mc-hamster/nova-core/nova core/hardware/core 2.0/build_002/core.brd

## EAGLE design nova core/hardware/core 2.0/build_002/core.brd (2022-10-16)

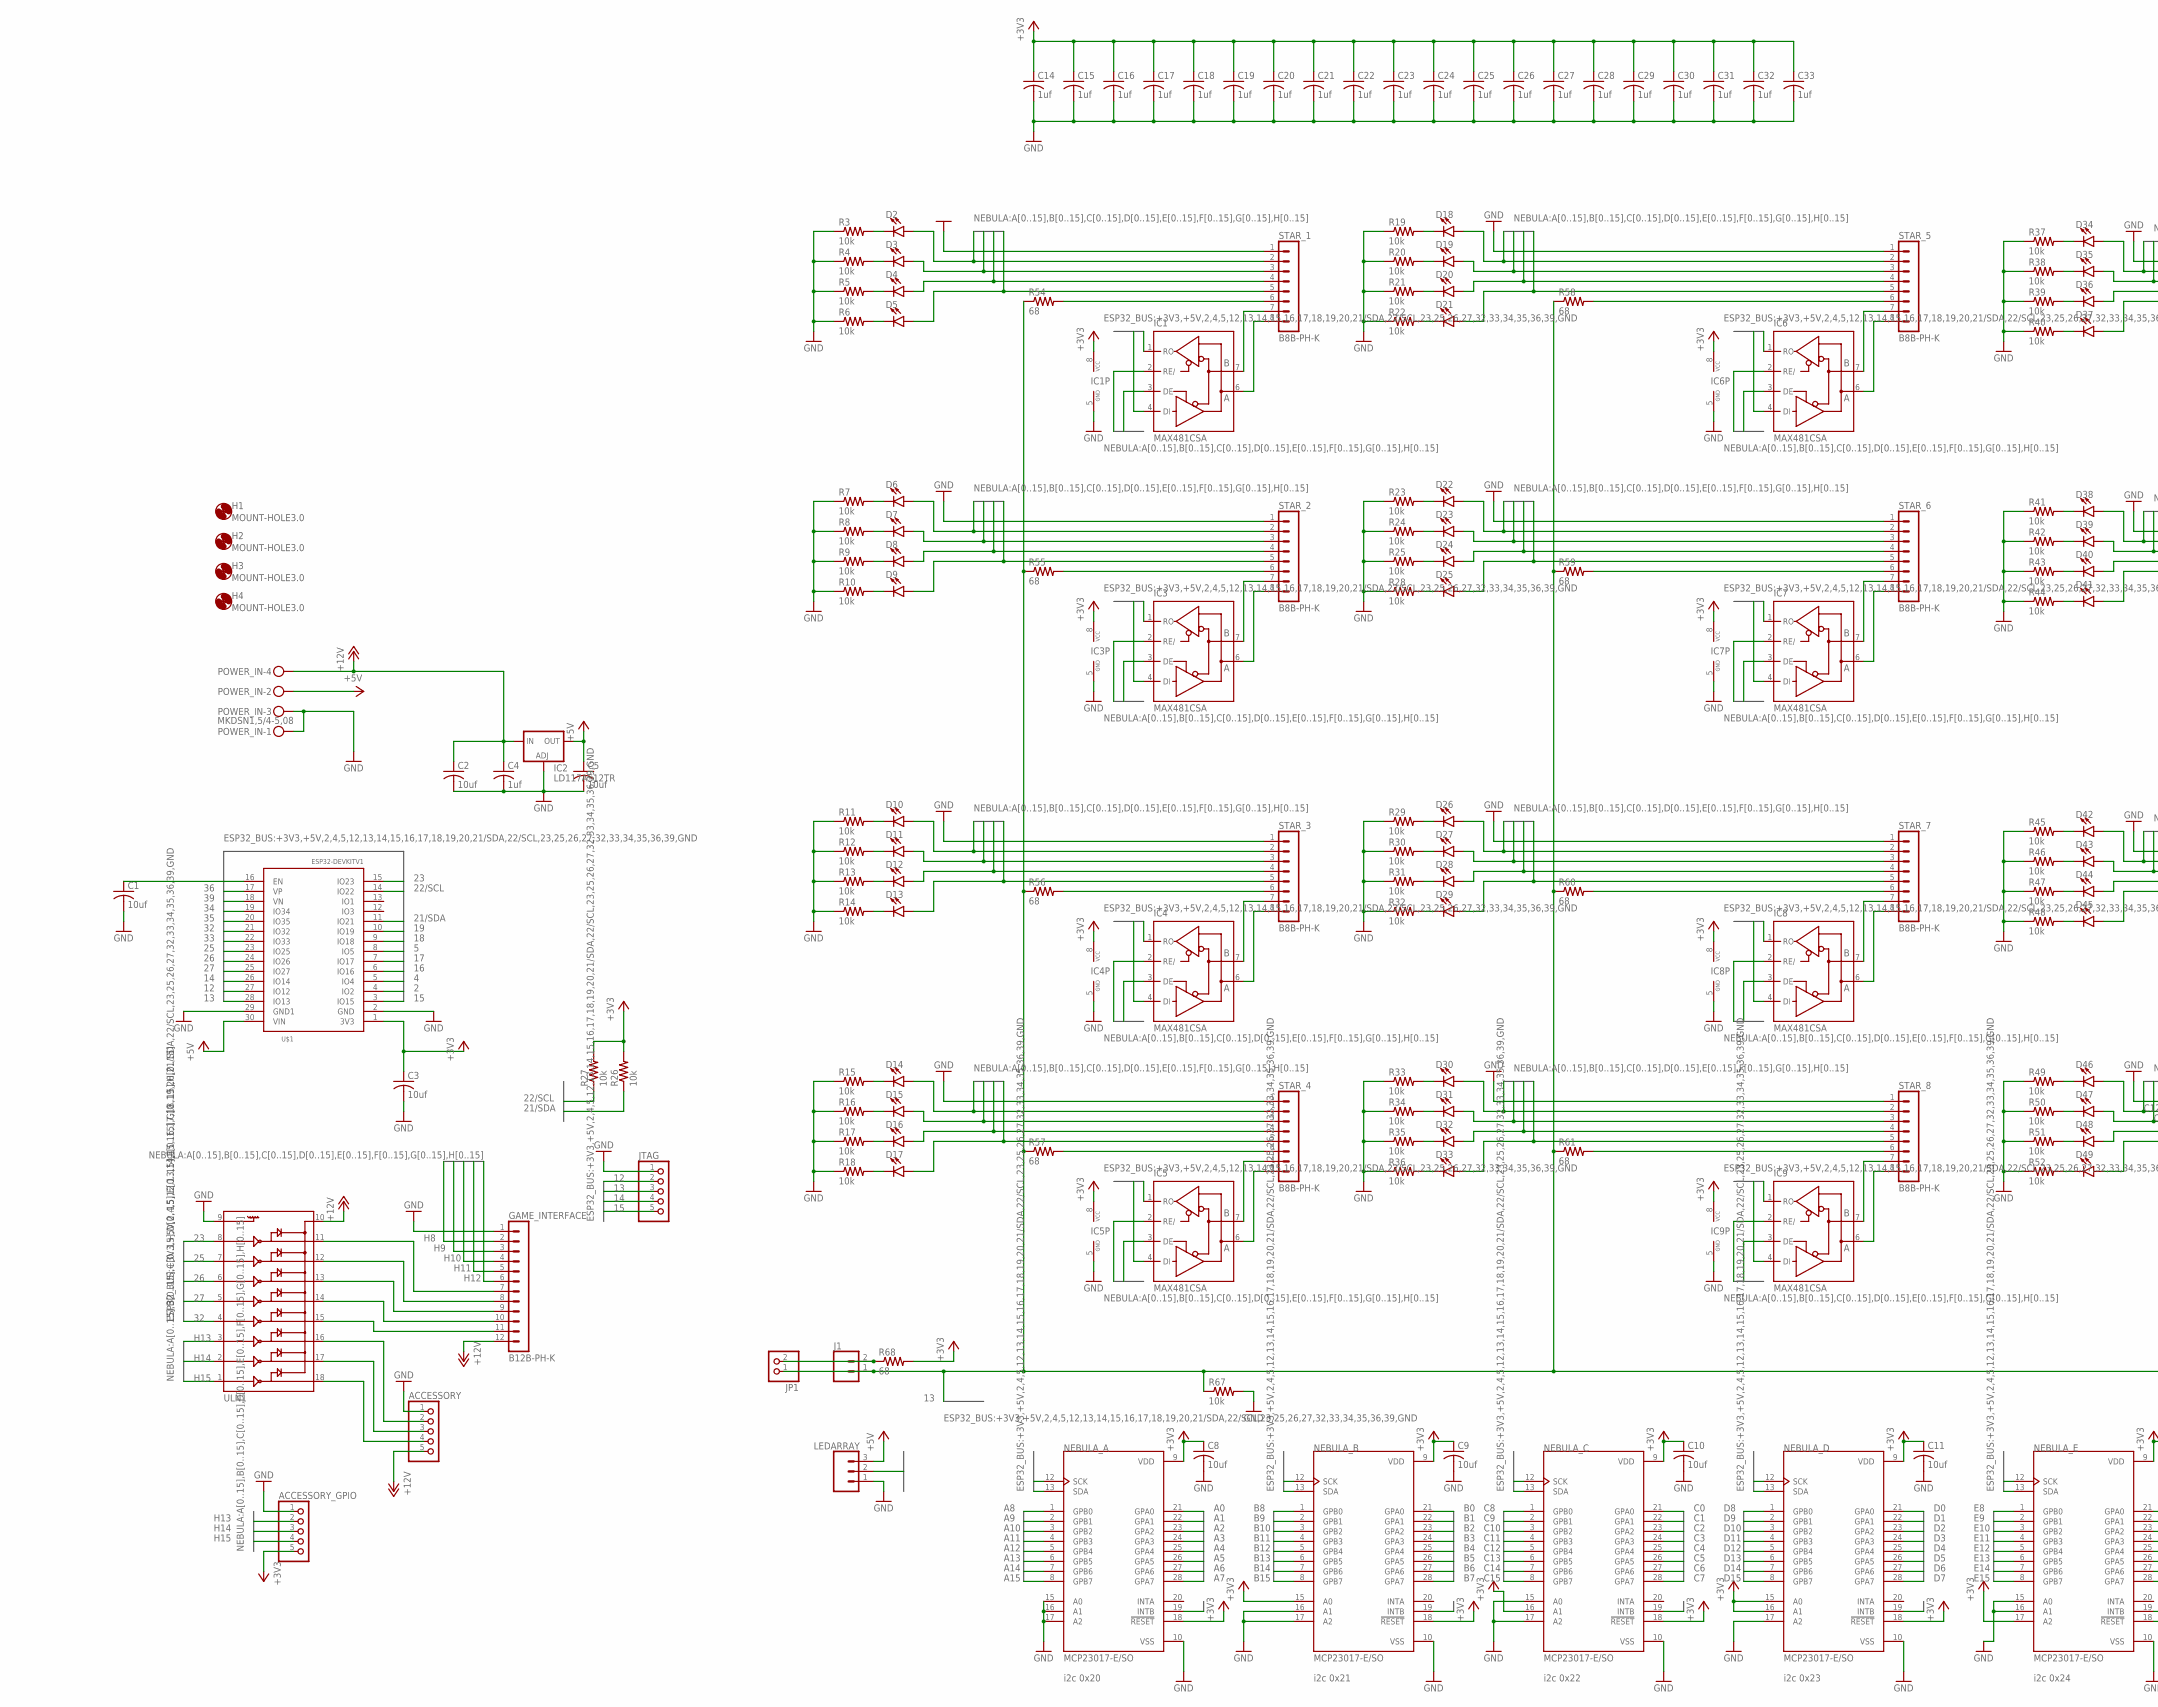
[picture p1: schematic core.sch, part in row 1, column 1]

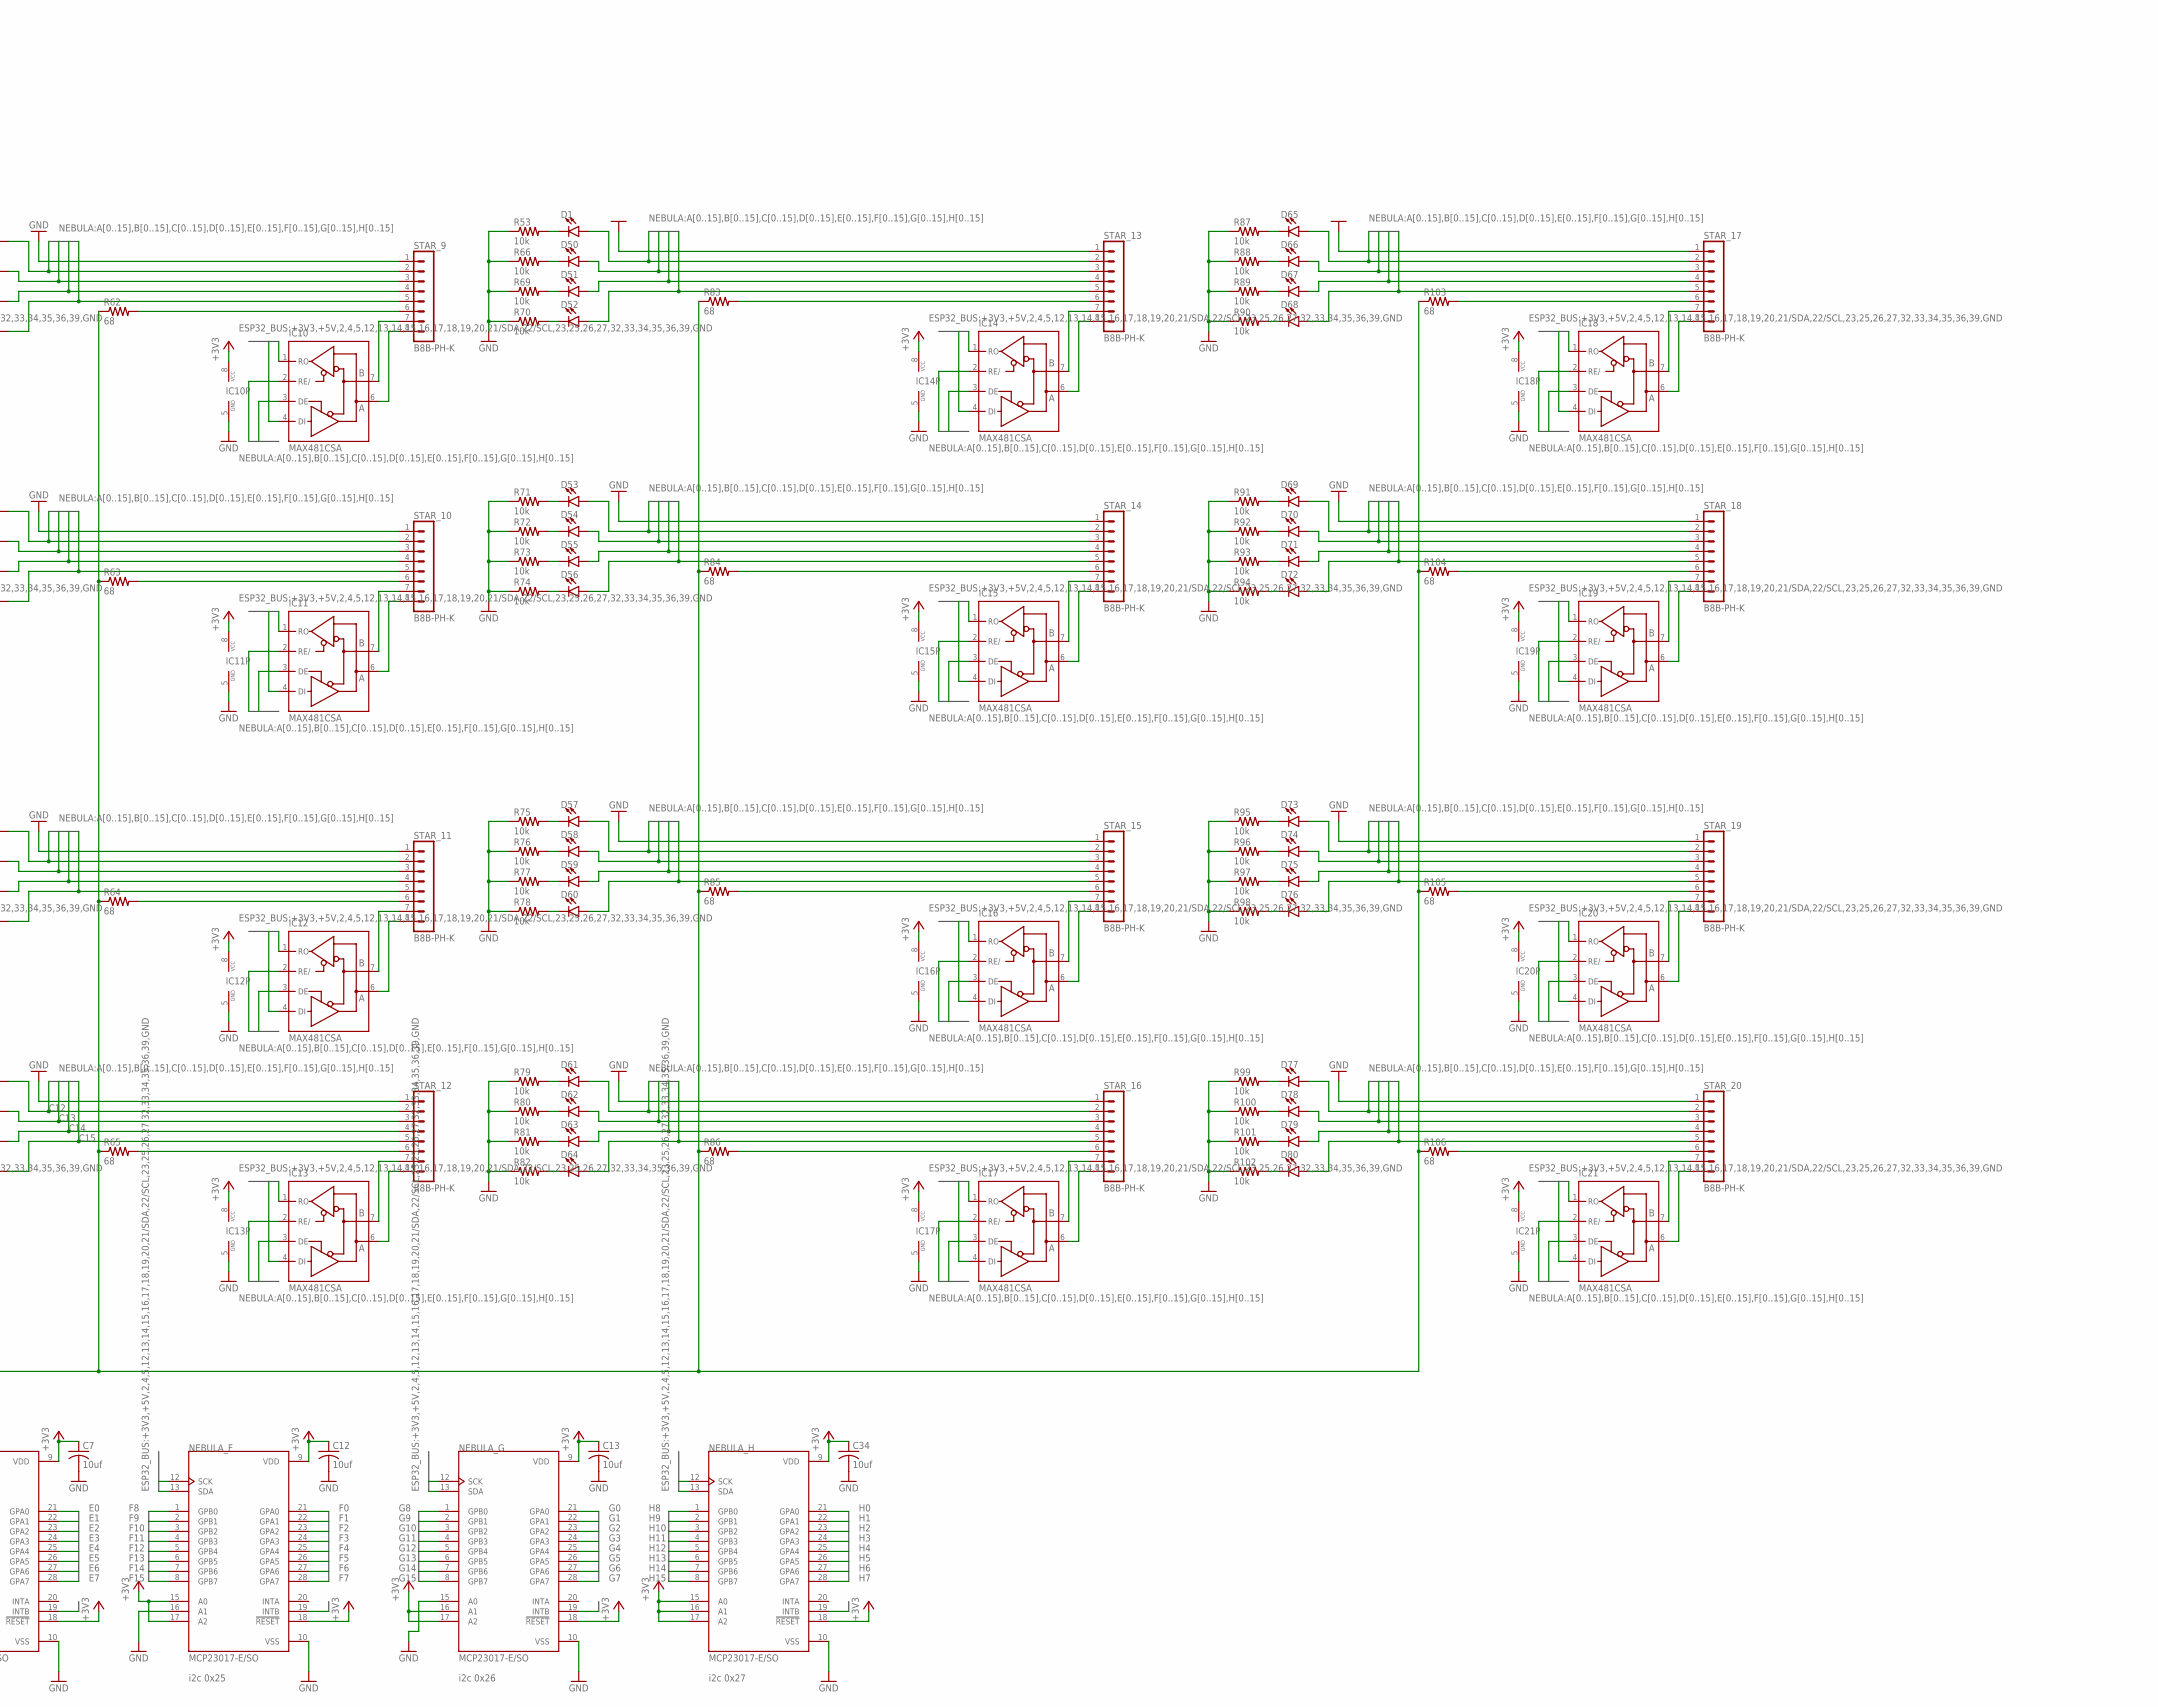
[picture p2: schematic core.sch, part in row 1, column 2]

Parts:
ACCESSORY: PINHD-1X5; 1X05
ACCESSORY_GPIO: PINHD-1X5; 1X05
C1, C2, C3, C5, C7, C8, C9, C10, C11, C12, C13, C34: 10uf; C0603; LCSC_PART C19702
C4, C14, C15, C16, C17, C18, C19, C20, C21, C22, C23, C24, C25, C26, C27, C28, C29, C30, C31, C32, C33: 1uf; C0805; LCSC_PART C15849
D1, D2, D6, D10, D14, D18, D22, D26, D30, D34, D38, D42, D46, D53, D57, D61, D65, D69, D73, D77: LED0603; LED-0603; LCSC_PART C2286
D3, D7, D11, D15, D19, D23, D27, D31, D35, D39, D43, D47, D50, D54, D58, D62, D66, D70, D74, D78: LED0603; LED-0603; LCSC_PART C72043
D4, D8, D12, D16, D20, D24, D28, D32, D36, D40, D44, D48, D51, D55, D59, D63, D67, D71, D75, D79: LED0603; LED-0603; LCSC_PART C72041
D5, D9, D13, D17, D21, D25, D29, D33, D37, D41, D45, D49, D52, D56, D60, D64, D68, D72, D76, D80: LED0603; LED-0603; LCSC_PART C2290
GAME_INTERFACE: B12B-PH-K
H1, H2, H3, H4: MOUNT-HOLE3.0; 3,0
IC1, IC3, IC4, IC5, IC6, IC7, IC8, IC9, IC10, IC11, IC12, IC13, IC14, IC15, IC16, IC17, IC18, IC19, IC20, IC21: MAX481CSA; SO08; LCSC_PART C8963
IC2: LD117AS12TR; SOT223; LCSC_PART C6187
J1: CONN_02JST-PTH-2; JST-2-PTH
JP1: PINHD-1X2; 1X02
JTAG: PINHD-1X5; 1X05
LEDARRAY: CONN_03; 1X03
NEBULA_A: MCP23017-E/SO; SOIC127P1030X265-28N; LCSC_PART C629440
NEBULA_B: MCP23017-E/SO; SOIC127P1030X265-28N; LCSC_PART C629440
NEBULA_C: MCP23017-E/SO; SOIC127P1030X265-28N; LCSC_PART C629440
NEBULA_D: MCP23017-E/SO; SOIC127P1030X265-28N; LCSC_PART C629440
NEBULA_E: MCP23017-E/SO; SOIC127P1030X265-28N; LCSC_PART C629440
NEBULA_F: MCP23017-E/SO; SOIC127P1030X265-28N; LCSC_PART C629440
NEBULA_G: MCP23017-E/SO; SOIC127P1030X265-28N; LCSC_PART C629440
NEBULA_H: MCP23017-E/SO; SOIC127P1030X265-28N; LCSC_PART C629440
POWER_IN: MKDSN1,5/4-5,08
R3, R4, R5, R6, R7, R8, R9, R10, R11, R12, R13, R14, R15, R16, R17, R18, R19, R20, R21, R22, R23, R24, R25, R26, R27, R28, R29, R30, R31, R32, R33, R34, R35, R36, R37, R38, R39, R40, R41, R42, R43, R44, R45, R46, R47, R48, R49, R50, R51, R52, R53, R66, R67, R69, R70, R71, R72, R73, R74, R75, R76, R77, R78, R79, R80, R81, R82, R87, R88, R89, R90, R91, R92, R93, R94, R95, R96, R97, R98, R99, R100, R101, R102: 10k; R0603; LCSC_PART C25804
R54, R55, R56, R57, R58, R59, R60, R61, R62, R63, R64, R65, R68, R83, R84, R85, R86, R103, R104, R105, R106: 68; R0603; LCSC_PART C25804
STAR_1, STAR_2, STAR_3, STAR_4, STAR_5, STAR_6, STAR_7, STAR_8, STAR_9, STAR_10, STAR_11, STAR_12, STAR_13, STAR_14, STAR_15, STAR_16, STAR_17, STAR_18, STAR_19, STAR_20: B8B-PH-K
U$1: ESP32DEVKITV1; ESP32-DEVKITV1
ULN1: ULN2803SOIC; SO018

Connections:
2: U$1.4 (IO2)
4: LEDARRAY.2, U$1.5 (IO4)
5: U$1.8 (IO5)
12: JTAG.2, U$1.27 (IO12)
13: J1.1, JP1.1, JTAG.3, R54.1, R55.1, R56.1, R57.1, R58.1, R59.1, R60.1, R61.1, R62.1, R63.1, R64.1, R65.1, R67.1, R83.1, R84.1, R85.1, R86.1, R103.1, R104.1, R105.1, R106.1, U$1.28 (IO13)
14: JTAG.4, U$1.26 (IO14)
15: JTAG.5, U$1.3 (IO15)
16: IC1.1 (RO), IC3.1 (RO), IC4.1 (RO), IC5.1 (RO), IC6.1 (RO), IC7.1 (RO), IC8.1 (RO), IC9.1 (RO), IC10.1 (RO), IC11.1 (RO), IC12.1 (RO), IC13.1 (RO), IC14.1 (RO), IC15.1 (RO), IC16.1 (RO), IC17.1 (RO), IC18.1 (RO), IC19.1 (RO), IC20.1 (RO), IC21.1 (RO), U$1.6 (IO16)
17: IC1.4 (DI), IC3.4 (DI), IC4.4 (DI), IC5.4 (DI), IC6.4 (DI), IC7.4 (DI), IC8.4 (DI), IC9.4 (DI), IC10.4 (DI), IC11.4 (DI), IC12.4 (DI), IC13.4 (DI), IC14.4 (DI), IC15.4 (DI), IC16.4 (DI), IC17.4 (DI), IC18.4 (DI), IC19.4 (DI), IC20.4 (DI), IC21.4 (DI), U$1.7 (IO17)
18: NEBULA_E.19 (INTB), U$1.9 (IO18)
19: NEBULA_F.19 (INTB), U$1.10 (IO19)
21/SDA: NEBULA_A.13 (SDA), NEBULA_B.13 (SDA), NEBULA_C.13 (SDA), NEBULA_D.13 (SDA), NEBULA_E.13 (SDA), NEBULA_F.13 (SDA), NEBULA_G.13 (SDA), NEBULA_H.13 (SDA), R26.1, U$1.11 (IO21)
22/SCL: NEBULA_A.12 (SCK), NEBULA_B.12 (SCK), NEBULA_C.12 (SCK), NEBULA_D.12 (SCK), NEBULA_E.12 (SCK), NEBULA_F.12 (SCK), NEBULA_G.12 (SCK), NEBULA_H.12 (SCK), R27.1, U$1.14 (IO22)
23: U$1.15 (IO23), ULN1.8
25: U$1.23 (IO25), ULN1.7
26: U$1.24 (IO26), ULN1.6
27: U$1.25 (IO27), ULN1.5
32: U$1.21 (IO32), ULN1.4
33: NEBULA_G.19 (INTB), NEBULA_H.19 (INTB), U$1.22 (IO33)
34: NEBULA_A.19 (INTB), U$1.19 (IO34)
35: NEBULA_B.19 (INTB), U$1.20 (IO35)
36: NEBULA_C.19 (INTB), U$1.17 (VP)
39: NEBULA_D.19 (INTB), U$1.18 (VN)
+3V3: ACCESSORY_GPIO.5, C3.1, C7.1, C8.1, C9.1, C10.1, C11.1, C12.1, C13.1, C14.1, C15.1, C16.1, C17.1, C18.1, C19.1, C20.1, C21.1, C22.1, C23.1, C24.1, C25.1, C26.1, C27.1, C28.1, C29.1, C30.1, C31.1, C32.1, C33.1, C34.1, IC1.8 (VCC), IC3.8 (VCC), IC4.8 (VCC), IC5.8 (VCC), IC6.8 (VCC), IC7.8 (VCC), IC8.8 (VCC), IC9.8 (VCC), IC10.8 (VCC), IC11.8 (VCC), IC12.8 (VCC), IC13.8 (VCC), IC14.8 (VCC), IC15.8 (VCC), IC16.8 (VCC), IC17.8 (VCC), IC18.8 (VCC), IC19.8 (VCC), IC20.8 (VCC), IC21.8 (VCC), NEBULA_A.9 (VDD), NEBULA_A.18 (!RESET), NEBULA_B.9 (VDD), NEBULA_B.15 (A0), NEBULA_B.18 (!RESET), NEBULA_C.9 (VDD), NEBULA_C.16 (A1), NEBULA_C.18 (!RESET), NEBULA_D.9 (VDD), NEBULA_D.15 (A0), NEBULA_D.16 (A1), NEBULA_D.18 (!RESET), NEBULA_E.9 (VDD), NEBULA_E.17 (A2), NEBULA_E.18 (!RESET), NEBULA_F.9 (VDD), NEBULA_F.15 (A0), NEBULA_F.17 (A2), NEBULA_F.18 (!RESET), NEBULA_G.9 (VDD), NEBULA_G.16 (A1), NEBULA_G.17 (A2), NEBULA_G.18 (!RESET), NEBULA_H.9 (VDD), NEBULA_H.15 (A0), NEBULA_H.16 (A1), NEBULA_H.17 (A2), NEBULA_H.18 (!RESET), R26.2, R27.2, R68.2, U$1.1 (3V3)
+5V: C5.1, IC2.4 (OUT), LEDARRAY.3, POWER_IN.2, U$1.30 (VIN)
+12V: ACCESSORY.5, C2.1, C4.1, GAME_INTERFACE.12, IC2.3 (IN), POWER_IN.4, ULN1.10
A0: D2.A, NEBULA_A.21 (GPA0), STAR_1.2
A1: D3.A, NEBULA_A.22 (GPA1), STAR_1.3
A2: D4.A, NEBULA_A.23 (GPA2), STAR_1.4
A3: D5.A, NEBULA_A.24 (GPA3), STAR_1.5
A4: D6.A, NEBULA_A.25 (GPA4), STAR_2.2
A5: D7.A, NEBULA_A.26 (GPA5), STAR_2.3
A6: D8.A, NEBULA_A.27 (GPA6), STAR_2.4
A7: D9.A, NEBULA_A.28 (GPA7), STAR_2.5
A8: D10.A, NEBULA_A.1 (GPB0), STAR_3.2
A9: D11.A, NEBULA_A.2 (GPB1), STAR_3.3
A10: D12.A, NEBULA_A.3 (GPB2), STAR_3.4
A11: D13.A, NEBULA_A.4 (GPB3), STAR_3.5
A12: D14.A, NEBULA_A.5 (GPB4), STAR_4.2
A13: D15.A, NEBULA_A.6 (GPB5), STAR_4.3
A14: D16.A, NEBULA_A.7 (GPB6), STAR_4.4
A15: D17.A, NEBULA_A.8 (GPB7), STAR_4.5
B0: D18.A, NEBULA_B.21 (GPA0), STAR_5.2
B1: D19.A, NEBULA_B.22 (GPA1), STAR_5.3
B2: D20.A, NEBULA_B.23 (GPA2), STAR_5.4
B3: D21.A, NEBULA_B.24 (GPA3), STAR_5.5
B4: D22.A, NEBULA_B.25 (GPA4), STAR_6.2
B5: D23.A, NEBULA_B.26 (GPA5), STAR_6.3
B6: D24.A, NEBULA_B.27 (GPA6), STAR_6.4
B7: D25.A, NEBULA_B.28 (GPA7), STAR_6.5
B8: D26.A, NEBULA_B.1 (GPB0), STAR_7.2
B9: D27.A, NEBULA_B.2 (GPB1), STAR_7.3
B10: D28.A, NEBULA_B.3 (GPB2), STAR_7.4
B11: D29.A, NEBULA_B.4 (GPB3), STAR_7.5
B12: D30.A, NEBULA_B.5 (GPB4), STAR_8.2
B13: D31.A, NEBULA_B.6 (GPB5), STAR_8.3
B14: D32.A, NEBULA_B.7 (GPB6), STAR_8.4
B15: D33.A, NEBULA_B.8 (GPB7), STAR_8.5
C0: D34.A, NEBULA_C.21 (GPA0), STAR_9.2
C1: D35.A, NEBULA_C.22 (GPA1), STAR_9.3
C2: D36.A, NEBULA_C.23 (GPA2), STAR_9.4
C3: D37.A, NEBULA_C.24 (GPA3), STAR_9.5
C4: D38.A, NEBULA_C.25 (GPA4), STAR_10.2
C5: D39.A, NEBULA_C.26 (GPA5), STAR_10.3
C6: D40.A, NEBULA_C.27 (GPA6), STAR_10.4
C7: D41.A, NEBULA_C.28 (GPA7), STAR_10.5
C8: D42.A, NEBULA_C.1 (GPB0), STAR_11.2
C9: D43.A, NEBULA_C.2 (GPB1), STAR_11.3
C10: D44.A, NEBULA_C.3 (GPB2), STAR_11.4
C11: D45.A, NEBULA_C.4 (GPB3), STAR_11.5
C12: D46.A, NEBULA_C.5 (GPB4), STAR_12.2
C13: D47.A, NEBULA_C.6 (GPB5), STAR_12.3
C14: D48.A, NEBULA_C.7 (GPB6), STAR_12.4
C15: D49.A, NEBULA_C.8 (GPB7), STAR_12.5
D0: D1.A, NEBULA_D.21 (GPA0), STAR_13.2
D1: D50.A, NEBULA_D.22 (GPA1), STAR_13.3
D2: D51.A, NEBULA_D.23 (GPA2), STAR_13.4
D3: D52.A, NEBULA_D.24 (GPA3), STAR_13.5
D4: D53.A, NEBULA_D.25 (GPA4), STAR_14.2
D5: D54.A, NEBULA_D.26 (GPA5), STAR_14.3
D6: D55.A, NEBULA_D.27 (GPA6), STAR_14.4
D7: D56.A, NEBULA_D.28 (GPA7), STAR_14.5
D8: D57.A, NEBULA_D.1 (GPB0), STAR_15.2
D9: D58.A, NEBULA_D.2 (GPB1), STAR_15.3
D10: D59.A, NEBULA_D.3 (GPB2), STAR_15.4
D11: D60.A, NEBULA_D.4 (GPB3), STAR_15.5
D12: D61.A, NEBULA_D.5 (GPB4), STAR_16.2
D13: D62.A, NEBULA_D.6 (GPB5), STAR_16.3
D14: D63.A, NEBULA_D.7 (GPB6), STAR_16.4
D15: D64.A, NEBULA_D.8 (GPB7), STAR_16.5
E0: D65.A, NEBULA_E.21 (GPA0), STAR_17.2
E1: D66.A, NEBULA_E.22 (GPA1), STAR_17.3
E2: D67.A, NEBULA_E.23 (GPA2), STAR_17.4
E3: D68.A, NEBULA_E.24 (GPA3), STAR_17.5
E4: D69.A, NEBULA_E.25 (GPA4), STAR_18.2
E5: D70.A, NEBULA_E.26 (GPA5), STAR_18.3
E6: D71.A, NEBULA_E.27 (GPA6), STAR_18.4
E7: D72.A, NEBULA_E.28 (GPA7), STAR_18.5
E8: D73.A, NEBULA_E.1 (GPB0), STAR_19.2
E9: D74.A, NEBULA_E.2 (GPB1), STAR_19.3
E10: D75.A, NEBULA_E.3 (GPB2), STAR_19.4
E11: D76.A, NEBULA_E.4 (GPB3), STAR_19.5
E12: D77.A, NEBULA_E.5 (GPB4), STAR_20.2
E13: D78.A, NEBULA_E.6 (GPB5), STAR_20.3
E14: D79.A, NEBULA_E.7 (GPB6), STAR_20.4
E15: D80.A, NEBULA_E.8 (GPB7), STAR_20.5
F0: IC1.2 (RE/), NEBULA_F.21 (GPA0)
F1: IC1.3 (DE), NEBULA_F.22 (GPA1)
F2: IC3.2 (RE/), NEBULA_F.23 (GPA2)
F3: IC3.3 (DE), NEBULA_F.24 (GPA3)
F4: IC4.2 (RE/), NEBULA_F.25 (GPA4)
F5: IC4.3 (DE), NEBULA_F.26 (GPA5)
F6: IC5.2 (RE/), NEBULA_F.27 (GPA6)
F7: IC5.3 (DE), NEBULA_F.28 (GPA7)
F8: IC6.2 (RE/), NEBULA_F.1 (GPB0)
F9: IC6.3 (DE), NEBULA_F.2 (GPB1)
F10: IC7.2 (RE/), NEBULA_F.3 (GPB2)
F11: IC7.3 (DE), NEBULA_F.4 (GPB3)
F12: IC8.2 (RE/), NEBULA_F.5 (GPB4)
F13: IC8.3 (DE), NEBULA_F.6 (GPB5)
F14: IC9.2 (RE/), NEBULA_F.7 (GPB6)
F15: IC9.3 (DE), NEBULA_F.8 (GPB7)
G0: IC10.2 (RE/), NEBULA_G.21 (GPA0)
G1: IC10.3 (DE), NEBULA_G.22 (GPA1)
G2: IC11.2 (RE/), NEBULA_G.23 (GPA2)
G3: IC11.3 (DE), NEBULA_G.24 (GPA3)
G4: IC12.2 (RE/), NEBULA_G.25 (GPA4)
G5: IC12.3 (DE), NEBULA_G.26 (GPA5)
G6: IC13.2 (RE/), NEBULA_G.27 (GPA6)
G7: IC13.3 (DE), NEBULA_G.28 (GPA7)
G8: IC14.2 (RE/), NEBULA_G.1 (GPB0)
G9: IC14.3 (DE), NEBULA_G.2 (GPB1)
G10: IC15.2 (RE/), NEBULA_G.3 (GPB2)
G11: IC15.3 (DE), NEBULA_G.4 (GPB3)
G12: IC16.2 (RE/), NEBULA_G.5 (GPB4)
G13: IC16.3 (DE), NEBULA_G.6 (GPB5)
G14: IC17.2 (RE/), NEBULA_G.7 (GPB6)
G15: IC17.3 (DE), NEBULA_G.8 (GPB7)
GND: ACCESSORY.1, ACCESSORY_GPIO.1, C1.2, C2.2, C3.2, C4.2, C5.2, C7.2, C8.2, C9.2, C10.2, C11.2, C12.2, C13.2, C14.2, C15.2, C16.2, C17.2, C18.2, C19.2, C20.2, C21.2, C22.2, C23.2, C24.2, C25.2, C26.2, C27.2, C28.2, C29.2, C30.2, C31.2, C32.2, C33.2, C34.2, GAME_INTERFACE.1, IC1.5 (GND), IC2.1 (ADJ), IC3.5 (GND), IC4.5 (GND), IC5.5 (GND), IC6.5 (GND), IC7.5 (GND), IC8.5 (GND), IC9.5 (GND), IC10.5 (GND), IC11.5 (GND), IC12.5 (GND), IC13.5 (GND), IC14.5 (GND), IC15.5 (GND), IC16.5 (GND), IC17.5 (GND), IC18.5 (GND), IC19.5 (GND), IC20.5 (GND), IC21.5 (GND), JTAG.1, LEDARRAY.1, NEBULA_A.10 (VSS), NEBULA_A.15 (A0), NEBULA_A.16 (A1), NEBULA_A.17 (A2), NEBULA_B.10 (VSS), NEBULA_B.16 (A1), NEBULA_B.17 (A2), NEBULA_C.10 (VSS), NEBULA_C.15 (A0), NEBULA_C.17 (A2), NEBULA_D.10 (VSS), NEBULA_D.17 (A2), NEBULA_E.10 (VSS), NEBULA_E.15 (A0), NEBULA_E.16 (A1), NEBULA_F.10 (VSS), NEBULA_F.16 (A1), NEBULA_G.10 (VSS), NEBULA_G.15 (A0), NEBULA_H.10 (VSS), POWER_IN.1, POWER_IN.3, R3.1, R4.1, R5.1, R6.1, R7.1, R8.1, R9.1, R10.1, R11.1, R12.1, R13.1, R14.1, R15.1, R16.1, R17.1, R18.1, R19.1, R20.1, R21.1, R22.1, R23.1, R24.1, R25.1, R28.1, R29.1, R30.1, R31.1, R32.1, R33.1, R34.1, R35.1, R36.1, R37.1, R38.1, R39.1, R40.1, R41.1, R42.1, R43.1, R44.1, R45.1, R46.1, R47.1, R48.1, R49.1, R50.1, R51.1, R52.1, R53.1, R66.1, R67.2, R69.1, R70.1, R71.1, R72.1, R73.1, R74.1, R75.1, R76.1, R77.1, R78.1, R79.1, R80.1, R81.1, R82.1, R87.1, R88.1, R89.1, R90.1, R91.1, R92.1, R93.1, R94.1, R95.1, R96.1, R97.1, R98.1, R99.1, R100.1, R101.1, R102.1, STAR_1.1, STAR_2.1, STAR_3.1, STAR_4.1, STAR_5.1, STAR_6.1, STAR_7.1, STAR_8.1, STAR_9.1, STAR_10.1, STAR_11.1, STAR_12.1, STAR_13.1, STAR_14.1, STAR_15.1, STAR_16.1, STAR_17.1, STAR_18.1, STAR_19.1, STAR_20.1, U$1.2 (GND), U$1.29 (GND1), ULN1.9
H0: IC18.2 (RE/), NEBULA_H.21 (GPA0)
H1: IC18.3 (DE), NEBULA_H.22 (GPA1)
H2: IC19.2 (RE/), NEBULA_H.23 (GPA2)
H3: IC19.3 (DE), NEBULA_H.24 (GPA3)
H4: IC20.2 (RE/), NEBULA_H.25 (GPA4)
H5: IC20.3 (DE), NEBULA_H.26 (GPA5)
H6: IC21.2 (RE/), NEBULA_H.27 (GPA6)
H7: IC21.3 (DE), NEBULA_H.28 (GPA7)
H8: GAME_INTERFACE.2, NEBULA_H.1 (GPB0)
H9: GAME_INTERFACE.3, NEBULA_H.2 (GPB1)
H10: GAME_INTERFACE.4, NEBULA_H.3 (GPB2)
H11: GAME_INTERFACE.5, NEBULA_H.4 (GPB3)
H12: GAME_INTERFACE.6, NEBULA_H.5 (GPB4)
H13: ACCESSORY_GPIO.2, NEBULA_H.6 (GPB5), ULN1.3
H14: ACCESSORY_GPIO.3, NEBULA_H.7 (GPB6), ULN1.2
H15: ACCESSORY_GPIO.4, NEBULA_H.8 (GPB7), ULN1.1
unnamed: C1.1, U$1.16 (EN)
unnamed: R55.2, STAR_2.6
unnamed: D2.C, R3.2
unnamed: D3.C, R4.2
unnamed: D4.C, R5.2
unnamed: D5.C, R6.2
unnamed: R56.2, STAR_3.6
unnamed: R57.2, STAR_4.6
unnamed: R54.2, STAR_1.6
unnamed: R58.2, STAR_5.6
unnamed: D6.C, R7.2
unnamed: D7.C, R8.2
unnamed: D8.C, R9.2
unnamed: D9.C, R10.2
unnamed: R59.2, STAR_6.6
unnamed: R60.2, STAR_7.6
unnamed: R61.2, STAR_8.6
unnamed: R65.2, STAR_12.6
unnamed: R64.2, STAR_11.6
unnamed: D10.C, R11.2
unnamed: D11.C, R12.2
unnamed: D12.C, R13.2
unnamed: D13.C, R14.2
unnamed: R63.2, STAR_10.6
unnamed: R62.2, STAR_9.6
unnamed: D1.C, R53.2
unnamed: D50.C, R66.2
unnamed: D14.C, R15.2
unnamed: D15.C, R16.2
unnamed: D16.C, R17.2
unnamed: D17.C, R18.2
unnamed: D51.C, R69.2
unnamed: D52.C, R70.2
unnamed: D65.C, R87.2
unnamed: D53.C, R71.2
unnamed: D18.C, R19.2
unnamed: D19.C, R20.2
unnamed: D20.C, R21.2
unnamed: D21.C, R22.2
unnamed: D54.C, R72.2
unnamed: D55.C, R73.2
unnamed: D56.C, R74.2
unnamed: D57.C, R75.2
unnamed: D22.C, R23.2
unnamed: D23.C, R24.2
unnamed: D24.C, R25.2
unnamed: D25.C, R28.2
unnamed: D58.C, R76.2
unnamed: D59.C, R77.2
unnamed: D60.C, R78.2
unnamed: GAME_INTERFACE.7, ULN1.11
unnamed: D26.C, R29.2
unnamed: D27.C, R30.2
unnamed: D28.C, R31.2
unnamed: D29.C, R32.2
unnamed: GAME_INTERFACE.8, ULN1.12
unnamed: GAME_INTERFACE.9, ULN1.13
unnamed: GAME_INTERFACE.10, ULN1.14
unnamed: GAME_INTERFACE.11, ULN1.15
unnamed: D30.C, R33.2
unnamed: D31.C, R34.2
unnamed: D32.C, R35.2
unnamed: D33.C, R36.2
unnamed: D61.C, R79.2
unnamed: D62.C, R80.2
unnamed: D63.C, R81.2
unnamed: D64.C, R82.2
unnamed: D34.C, R37.2
unnamed: D35.C, R38.2
unnamed: D36.C, R39.2
unnamed: D37.C, R40.2
unnamed: R84.2, STAR_14.6
unnamed: R85.2, STAR_15.6
unnamed: R86.2, STAR_16.6
unnamed: R83.2, STAR_13.6
unnamed: D38.C, R41.2
unnamed: D39.C, R42.2
unnamed: D40.C, R43.2
unnamed: D41.C, R44.2
unnamed: D66.C, R88.2
unnamed: D67.C, R89.2
unnamed: D68.C, R90.2
unnamed: D69.C, R91.2
unnamed: D42.C, R45.2
unnamed: D43.C, R46.2
unnamed: D44.C, R47.2
unnamed: D45.C, R48.2
unnamed: D70.C, R92.2
unnamed: J1.2, JP1.2, R68.1
unnamed: D71.C, R93.2
unnamed: D72.C, R94.2
unnamed: D73.C, R95.2
unnamed: D46.C, R49.2
unnamed: D47.C, R50.2
unnamed: D48.C, R51.2
unnamed: D49.C, R52.2
unnamed: D74.C, R96.2
unnamed: D75.C, R97.2
unnamed: D76.C, R98.2
unnamed: D77.C, R99.2
unnamed: D78.C, R100.2
unnamed: D79.C, R101.2
unnamed: D80.C, R102.2
unnamed: R104.2, STAR_18.6
unnamed: R105.2, STAR_19.6
unnamed: R106.2, STAR_20.6
unnamed: R103.2, STAR_17.6
unnamed: IC1.7 (B), STAR_1.7
unnamed: IC1.6 (A), STAR_1.8
unnamed: IC3.7 (B), STAR_2.7
unnamed: IC3.6 (A), STAR_2.8
unnamed: IC4.7 (B), STAR_3.7
unnamed: IC4.6 (A), STAR_3.8
unnamed: IC5.7 (B), STAR_4.7
unnamed: IC5.6 (A), STAR_4.8
unnamed: IC6.7 (B), STAR_5.7
unnamed: IC6.6 (A), STAR_5.8
unnamed: IC7.7 (B), STAR_6.7
unnamed: IC7.6 (A), STAR_6.8
unnamed: IC8.7 (B), STAR_7.7
unnamed: IC8.6 (A), STAR_7.8
unnamed: IC9.7 (B), STAR_8.7
unnamed: IC9.6 (A), STAR_8.8
unnamed: IC10.7 (B), STAR_9.7
unnamed: IC10.6 (A), STAR_9.8
unnamed: IC11.7 (B), STAR_10.7
unnamed: IC11.6 (A), STAR_10.8
unnamed: IC12.7 (B), STAR_11.7
unnamed: IC12.6 (A), STAR_11.8
unnamed: IC13.7 (B), STAR_12.7
unnamed: IC13.6 (A), STAR_12.8
unnamed: IC14.7 (B), STAR_13.7
unnamed: IC14.6 (A), STAR_13.8
unnamed: IC15.7 (B), STAR_14.7
unnamed: IC15.6 (A), STAR_14.8
unnamed: IC16.7 (B), STAR_15.7
unnamed: IC16.6 (A), STAR_15.8
unnamed: IC17.7 (B), STAR_16.7
unnamed: IC17.6 (A), STAR_16.8
unnamed: IC18.7 (B), STAR_17.7
unnamed: IC18.6 (A), STAR_17.8
unnamed: IC19.7 (B), STAR_18.7
unnamed: IC19.6 (A), STAR_18.8
unnamed: IC20.7 (B), STAR_19.7
unnamed: IC20.6 (A), STAR_19.8
unnamed: IC21.7 (B), STAR_20.7
unnamed: IC21.6 (A), STAR_20.8
unnamed: ACCESSORY.2, ULN1.16
unnamed: ACCESSORY.3, ULN1.17
unnamed: ACCESSORY.4, ULN1.18

Notes on the sheet:
i2c 0x20
i2c 0x21
i2c 0x22
i2c 0x23
i2c 0x24
i2c 0x25
i2c 0x26
i2c 0x27

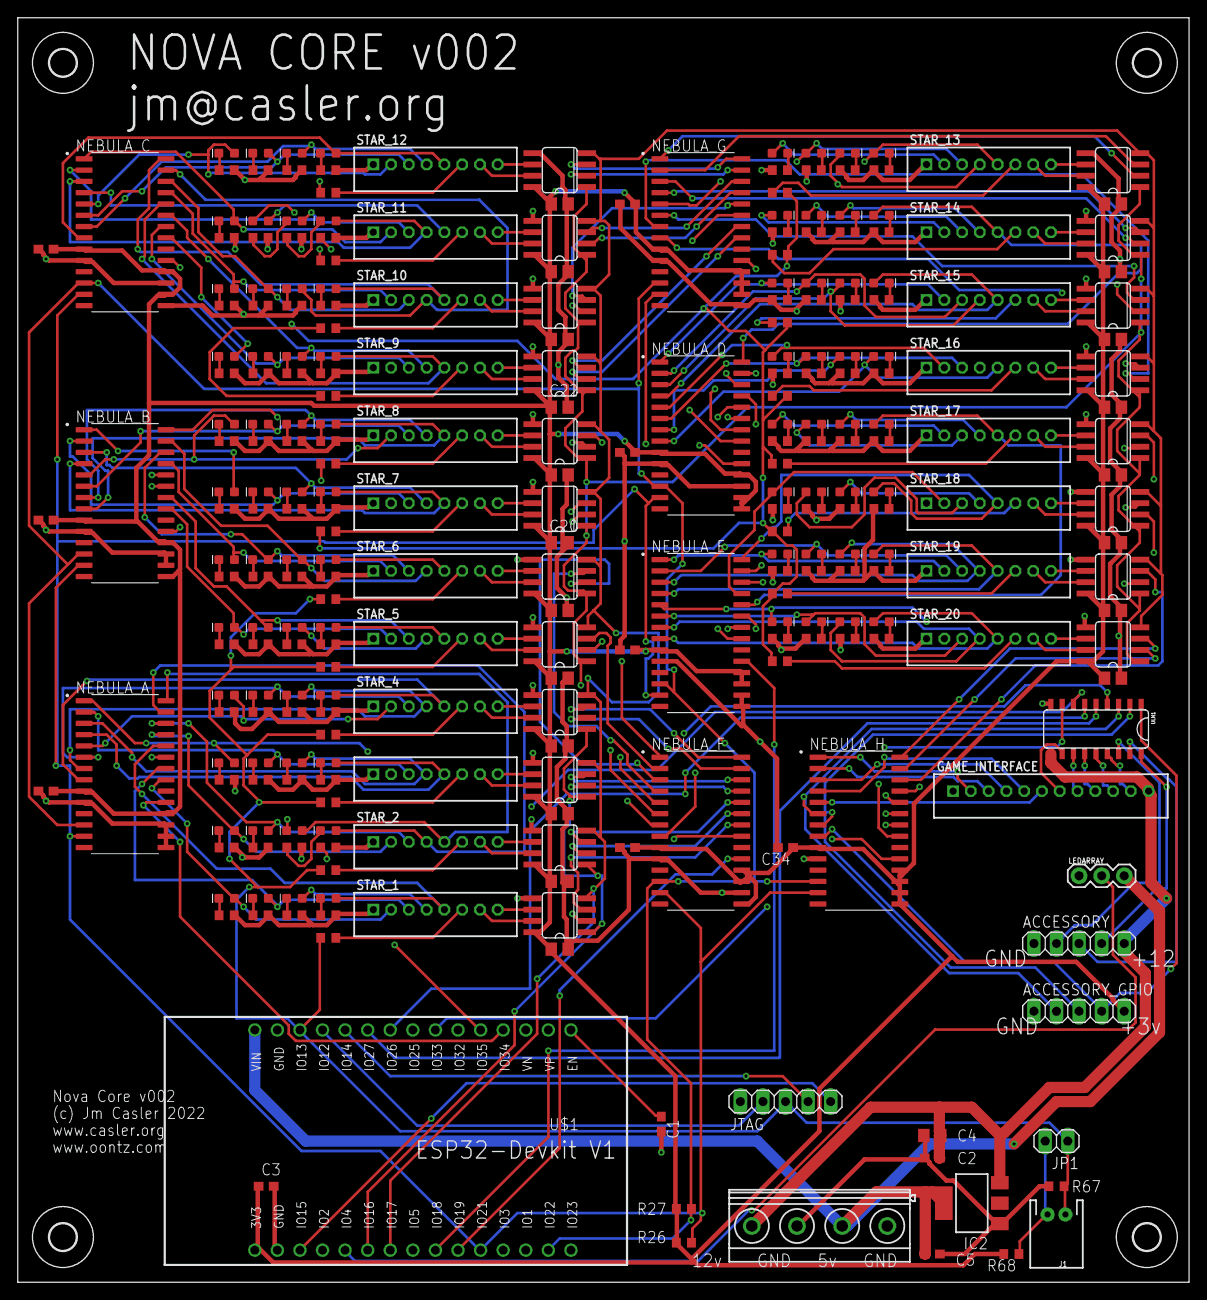
[picture p3: board nova core/hardware/core 2.0/build_002/core.brd from above]

Board: 4 copper layers, 131.8 x 142.2 mm, 280 parts (0 on the bottom side), 303 nets.
