mc-hamster/nova-core/nova core/hardware/core-manual/core_manual.brd

## EAGLE design nova core/hardware/core-manual/core_manual.brd (2023-05-19)

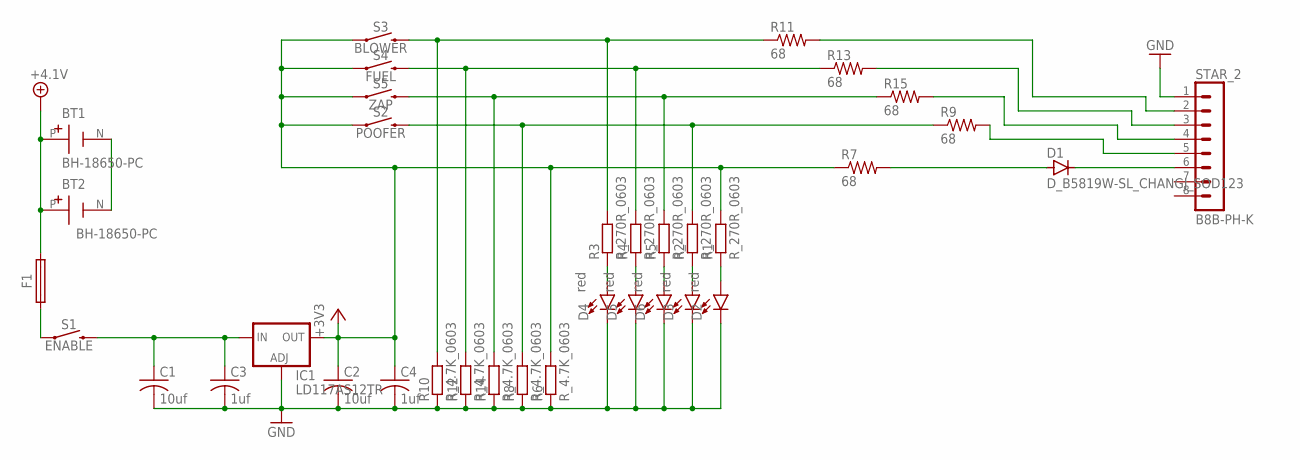
[picture p4: schematic core_manual.sch]

Parts:
BT1, BT2: BH-18650-PC; BAT_BH-18650-PC
C1, C2: 10uf; C0603; LCSC_PART C19702
C3, C4: 1uf; C0805; LCSC_PART C15849
D1: D_B5819W-SL_CHANGJ_SOD123; SOD123
D2, D3, D4, D5, D6: red; LED-0603; LCSC_PART C2286
F1: MF-MSMF-STYLE2_1; FUSC4632X160; LCSC_PART C78695
IC1: LD117AS12TR; SOT223; LCSC_PART C347222
R1, R2, R3, R4, R5: R_270R_0603; R0603
R6, R8, R10, R12, R14: R_4.7K_0603; R0603
R7, R9, R11, R13, R15: 68; R0603; LCSC_PART c27592
S1: ENABLE; TACTILE_SWITCH_PTH_6.0MM
S2: POOFER; TACTILE_SWITCH_PTH_6.0MM
S3: BLOWER; TACTILE_SWITCH_PTH_6.0MM
S4: FUEL; TACTILE_SWITCH_PTH_6.0MM
S5: ZAP; TACTILE_SWITCH_PTH_6.0MM
STAR_2: B8B-PH-K

Connections:
+3V3: C2.1, C4.1, IC1.4 (OUT), R1.2, R6.2, R7.1, S2.1, S3.1, S4.1, S5.1
+4.1V: BT1.P (+), BT2.P (+), F1.2
GND: C1.2, C2.2, C3.2, C4.2, D2.C, D3.C, D4.C, D5.C, D6.C, IC1.1 (ADJ), R6.1, R8.1, R10.1, R12.1, R14.1, STAR_2.1
unnamed: C1.1, C3.1, IC1.3 (IN), S1.3 (2)
unnamed: BT1.N (-), BT2.N (-)
unnamed: F1.1, S1.1
unnamed: R3.2, R10.2, R11.1, S3.3 (2)
unnamed: R4.2, R12.2, R13.1, S4.3 (2)
unnamed: R5.2, R14.2, R15.1, S5.3 (2)
unnamed: R2.2, R8.2, R9.1, S2.3 (2)
unnamed: R9.2, STAR_2.5
unnamed: R15.2, STAR_2.4
unnamed: R13.2, STAR_2.3
unnamed: R11.2, STAR_2.2
unnamed: D2.A, R1.1
unnamed: D3.A, R2.1
unnamed: D6.A, R5.1
unnamed: D5.A, R4.1
unnamed: D4.A, R3.1
unnamed: D1.A, R7.2
unnamed: D1.C, STAR_2.6

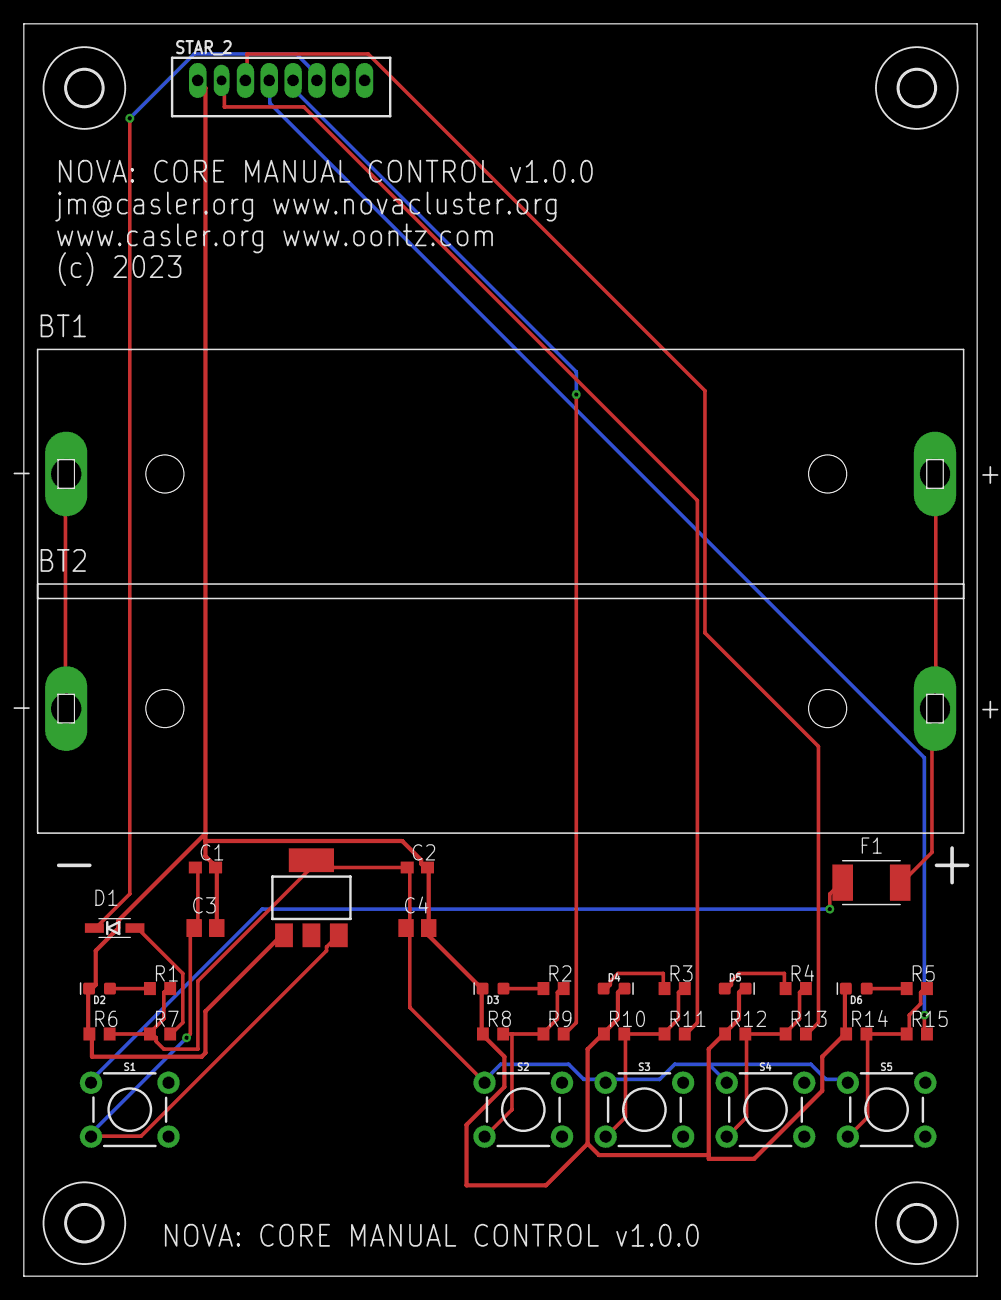
[picture p5: board core_manual.brd from above]

Board: 2 copper layers, 80.0 x 105.1 mm, 39 parts (0 on the bottom side), 21 nets.

Other parts of the board:
H1, H2, H3, H4: MOUNT-HOLE3.0; 3,0
