mc-hamster/nova-core/nova core/hardware/core 2.0/core.brd

## EAGLE design nova core/hardware/core 2.0/core.brd (2023-05-14)

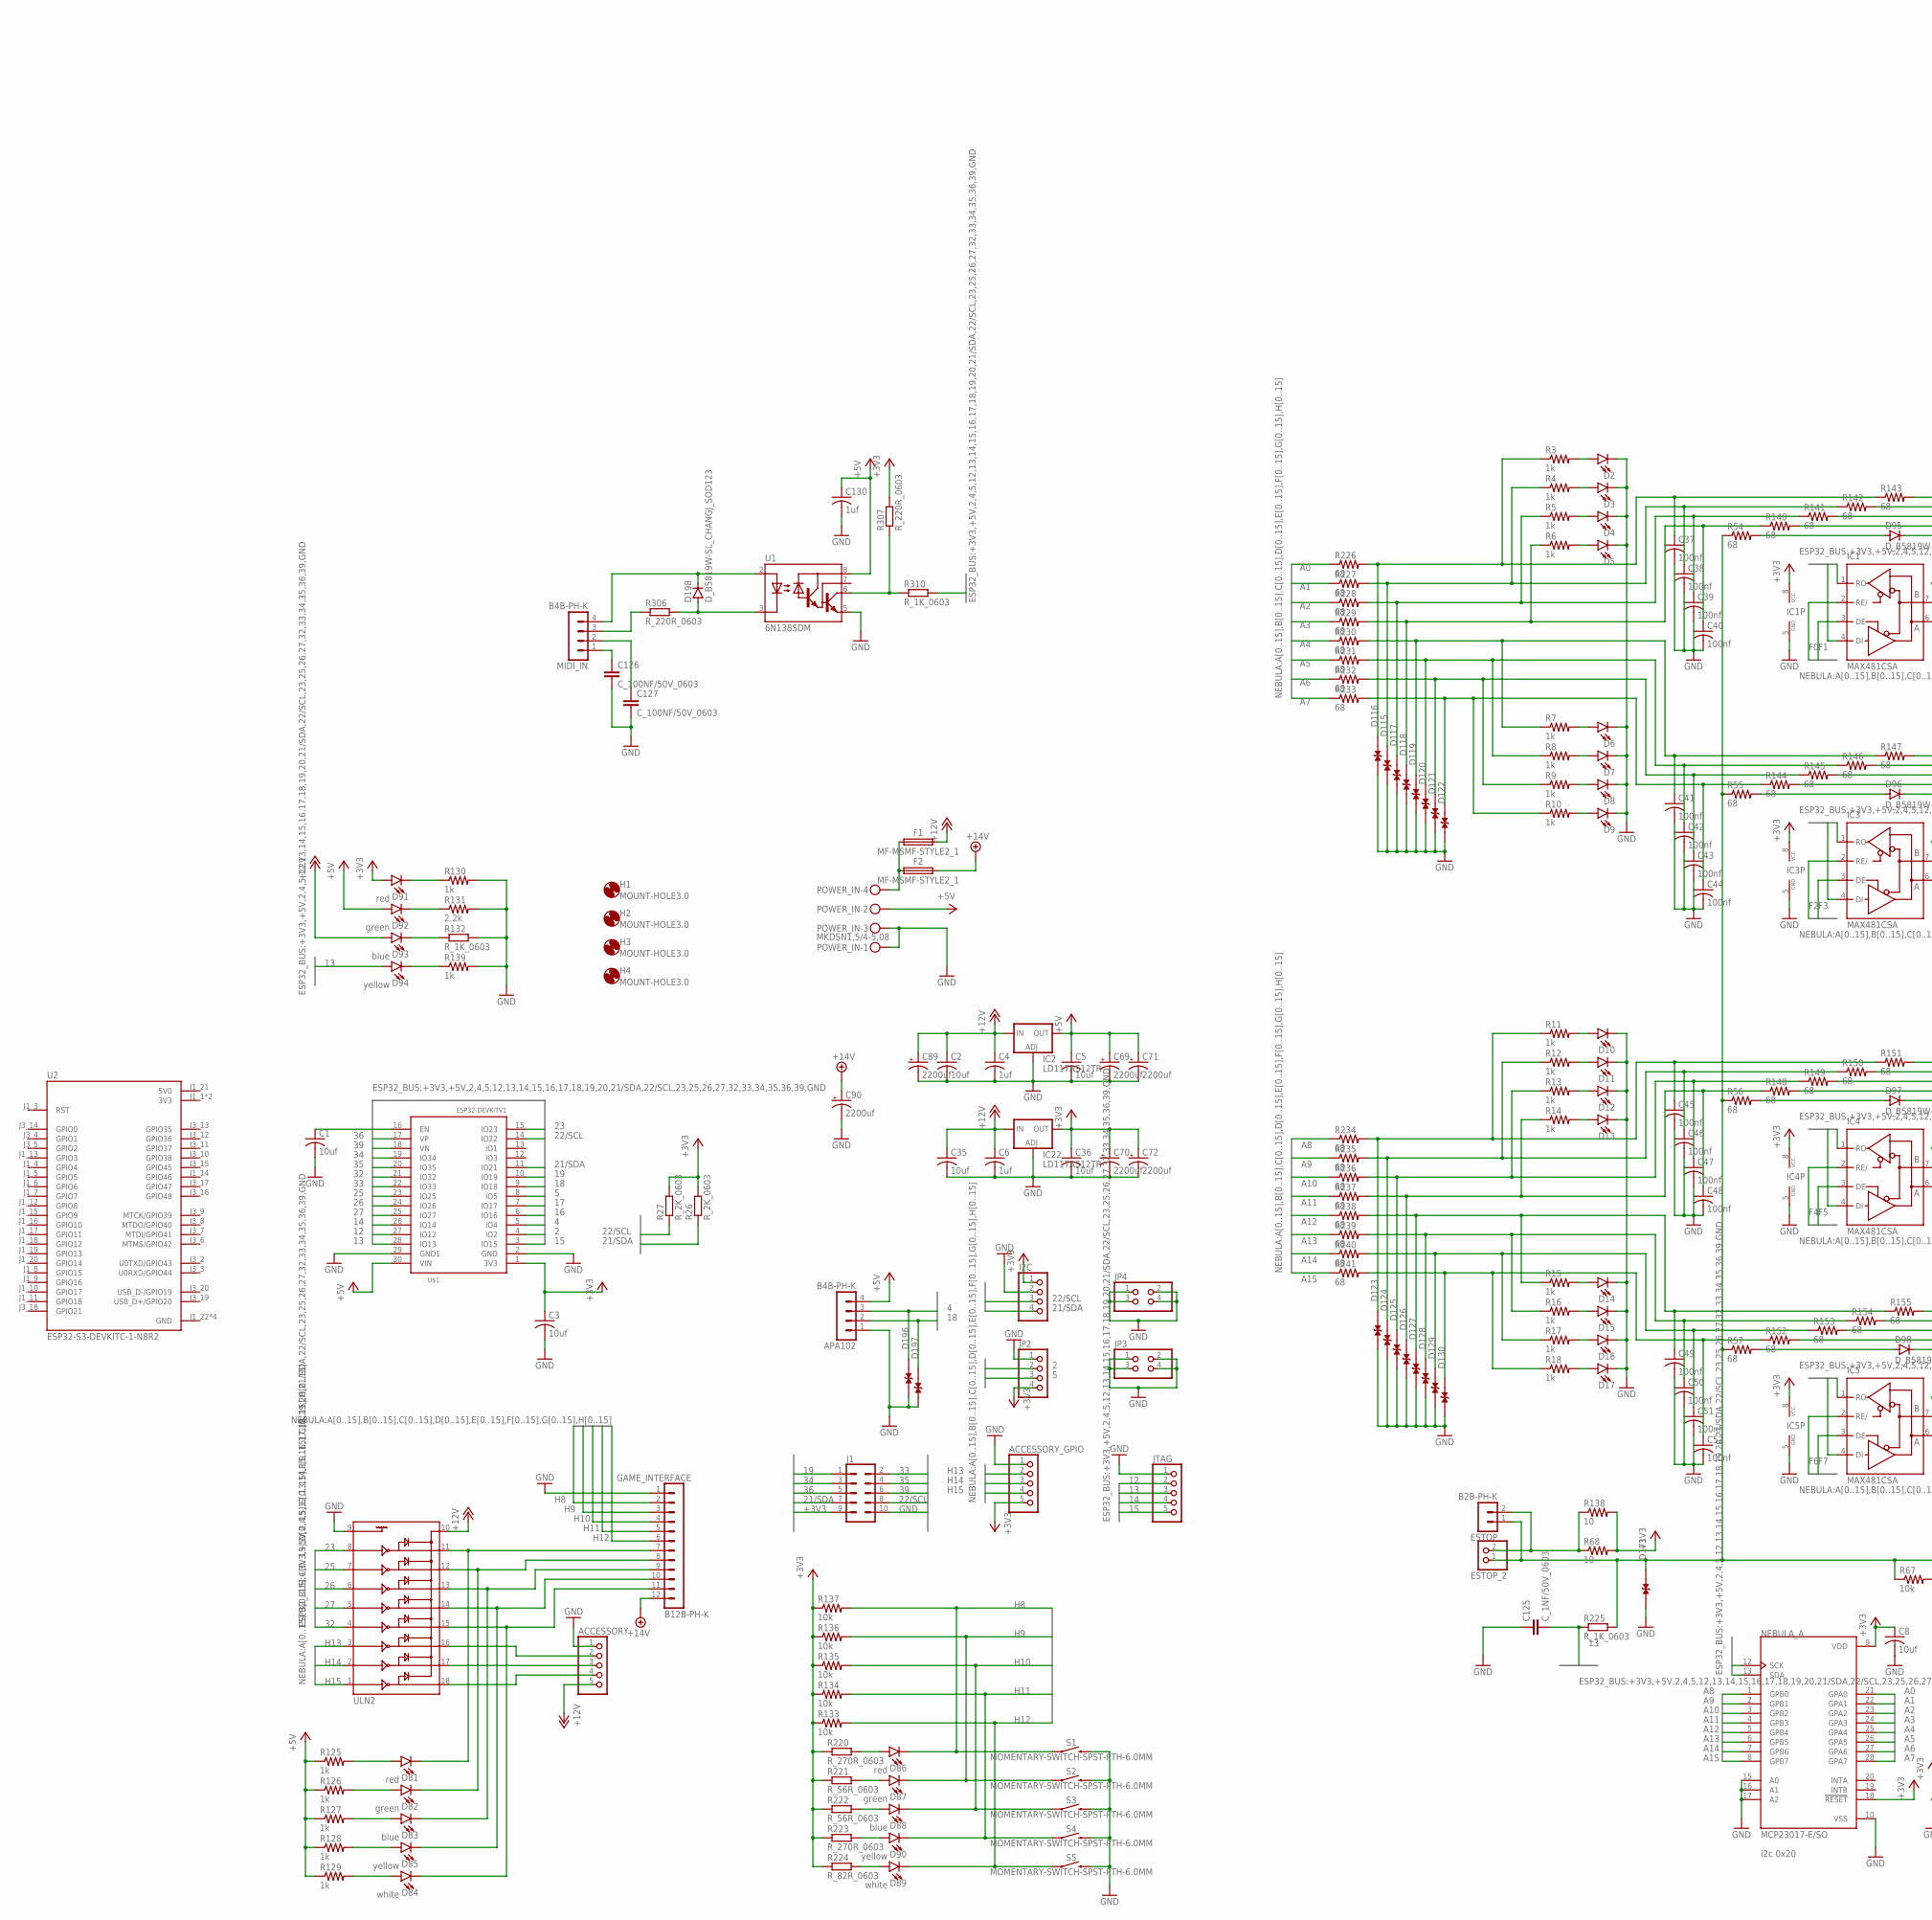
[picture p6: schematic core.sch, part in row 1, column 1]

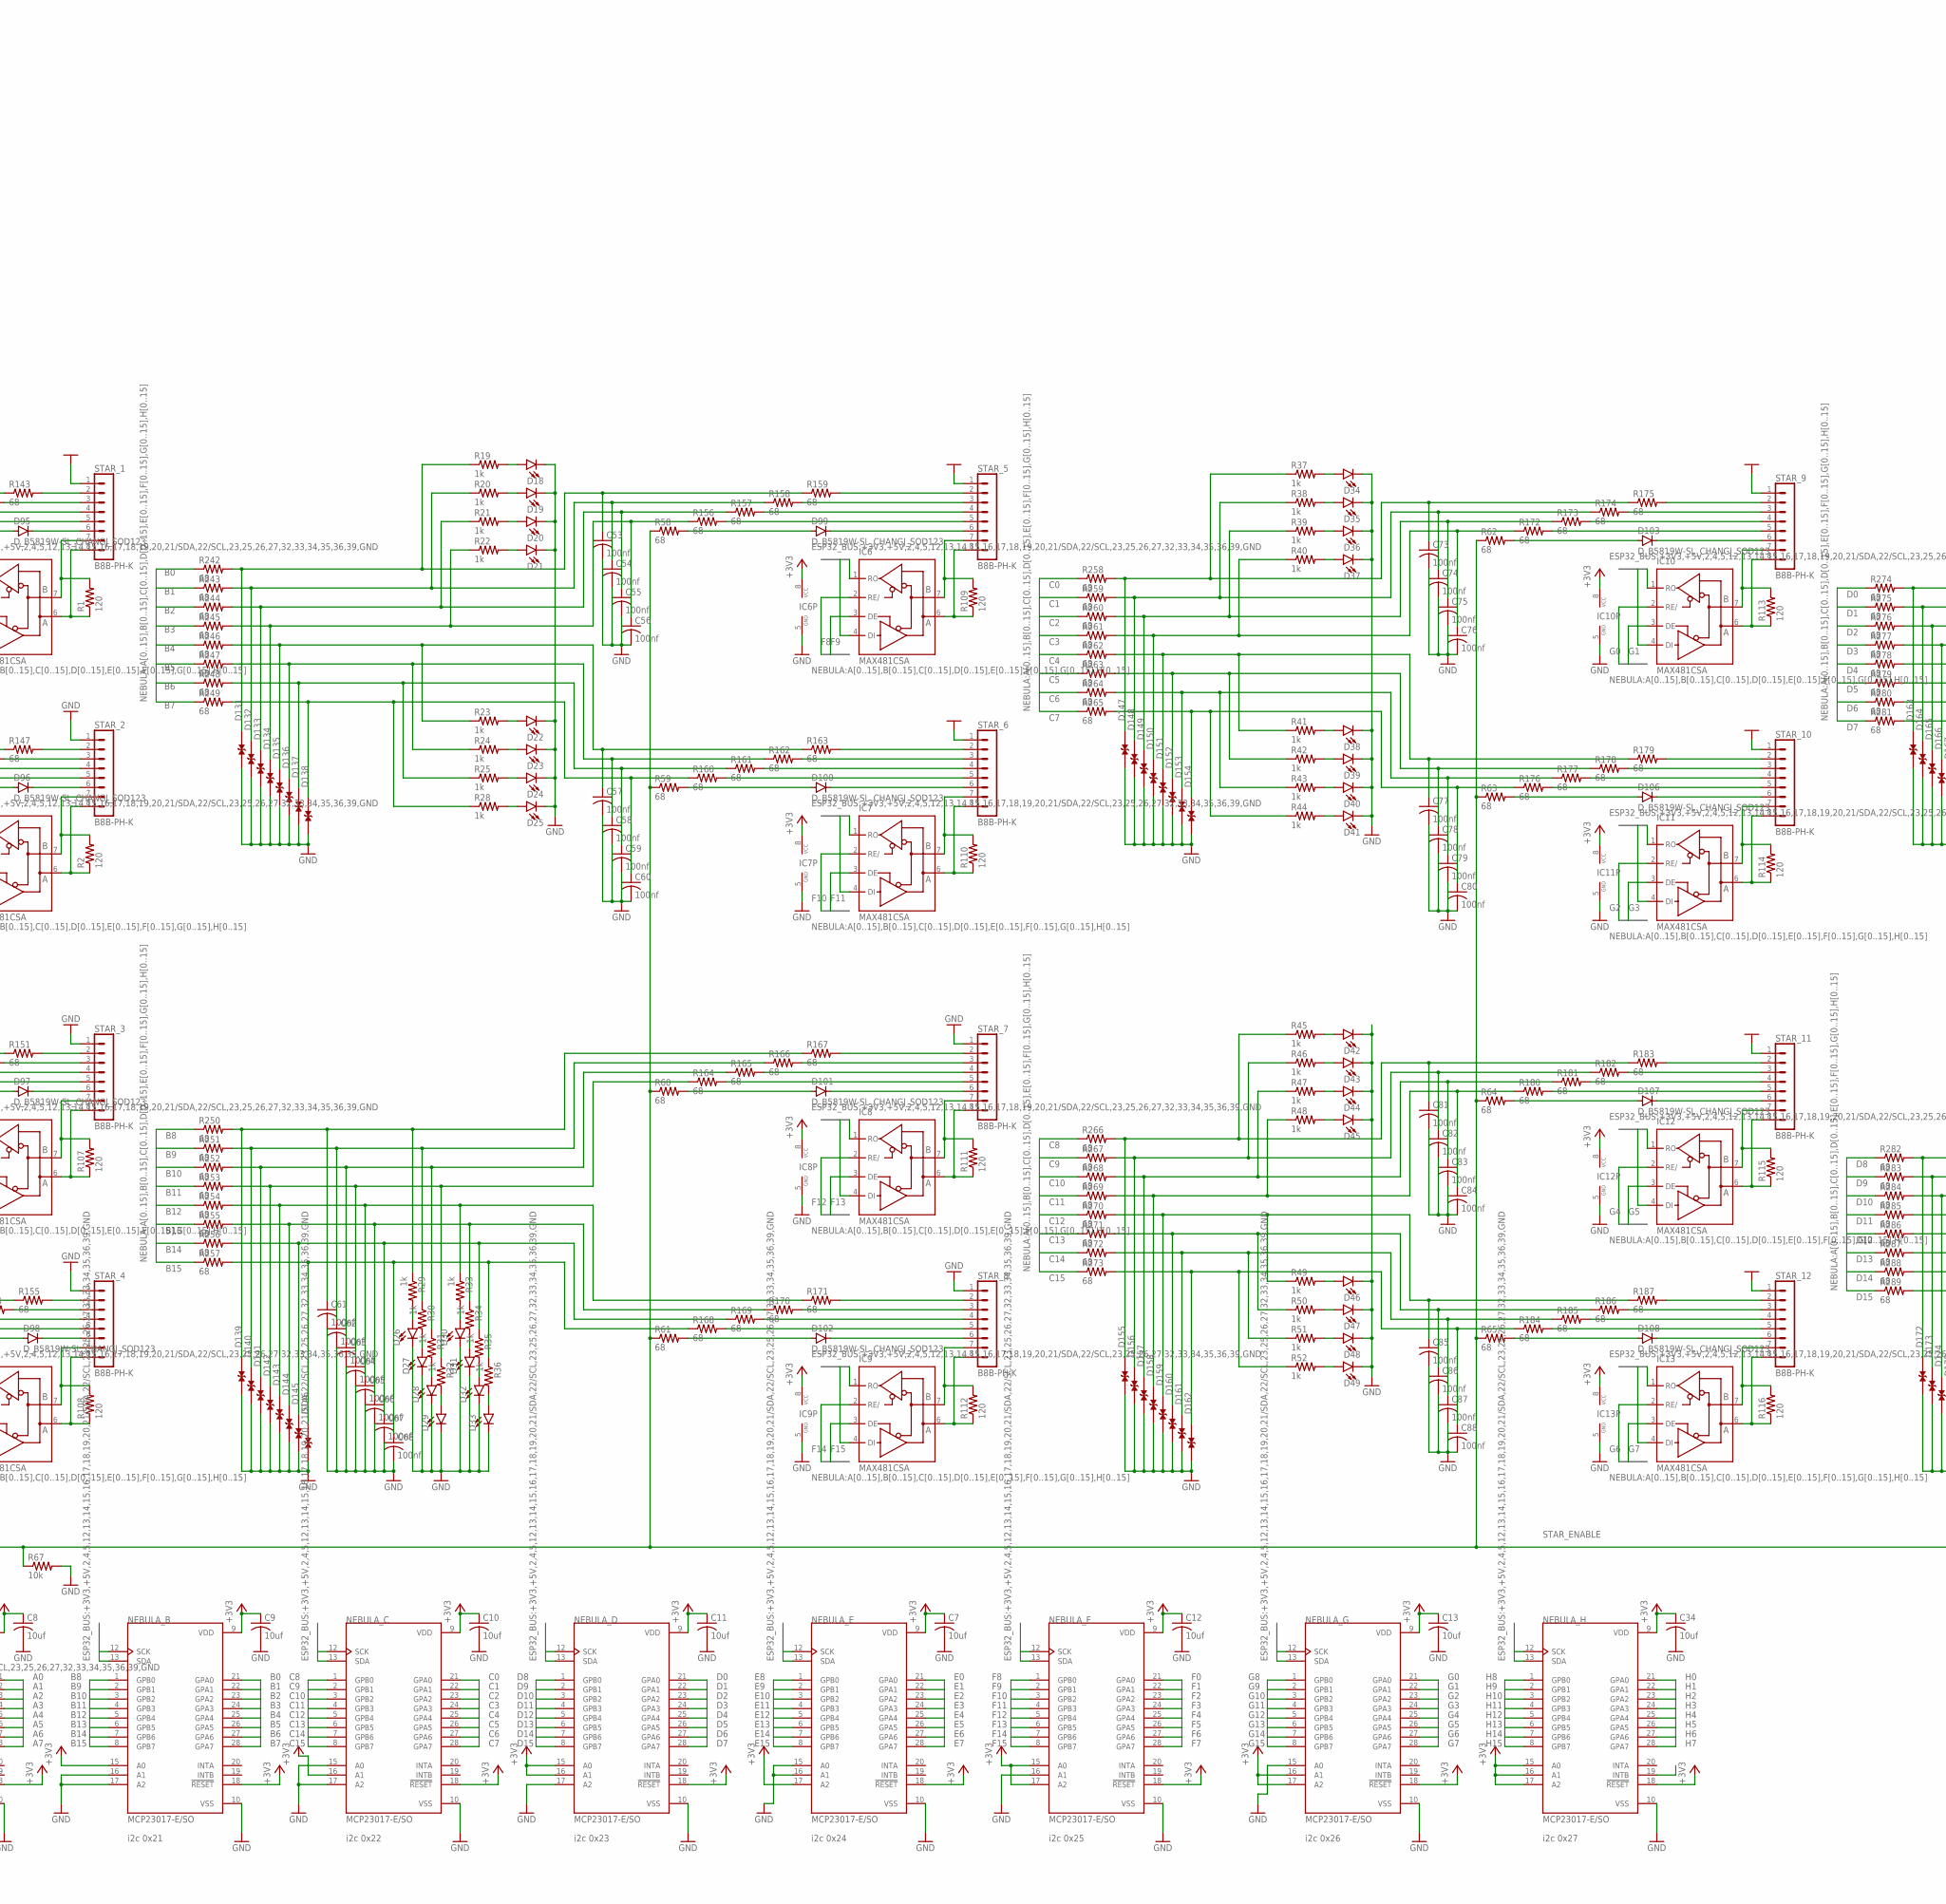
[picture p7: schematic core.sch, part in row 1, column 2]

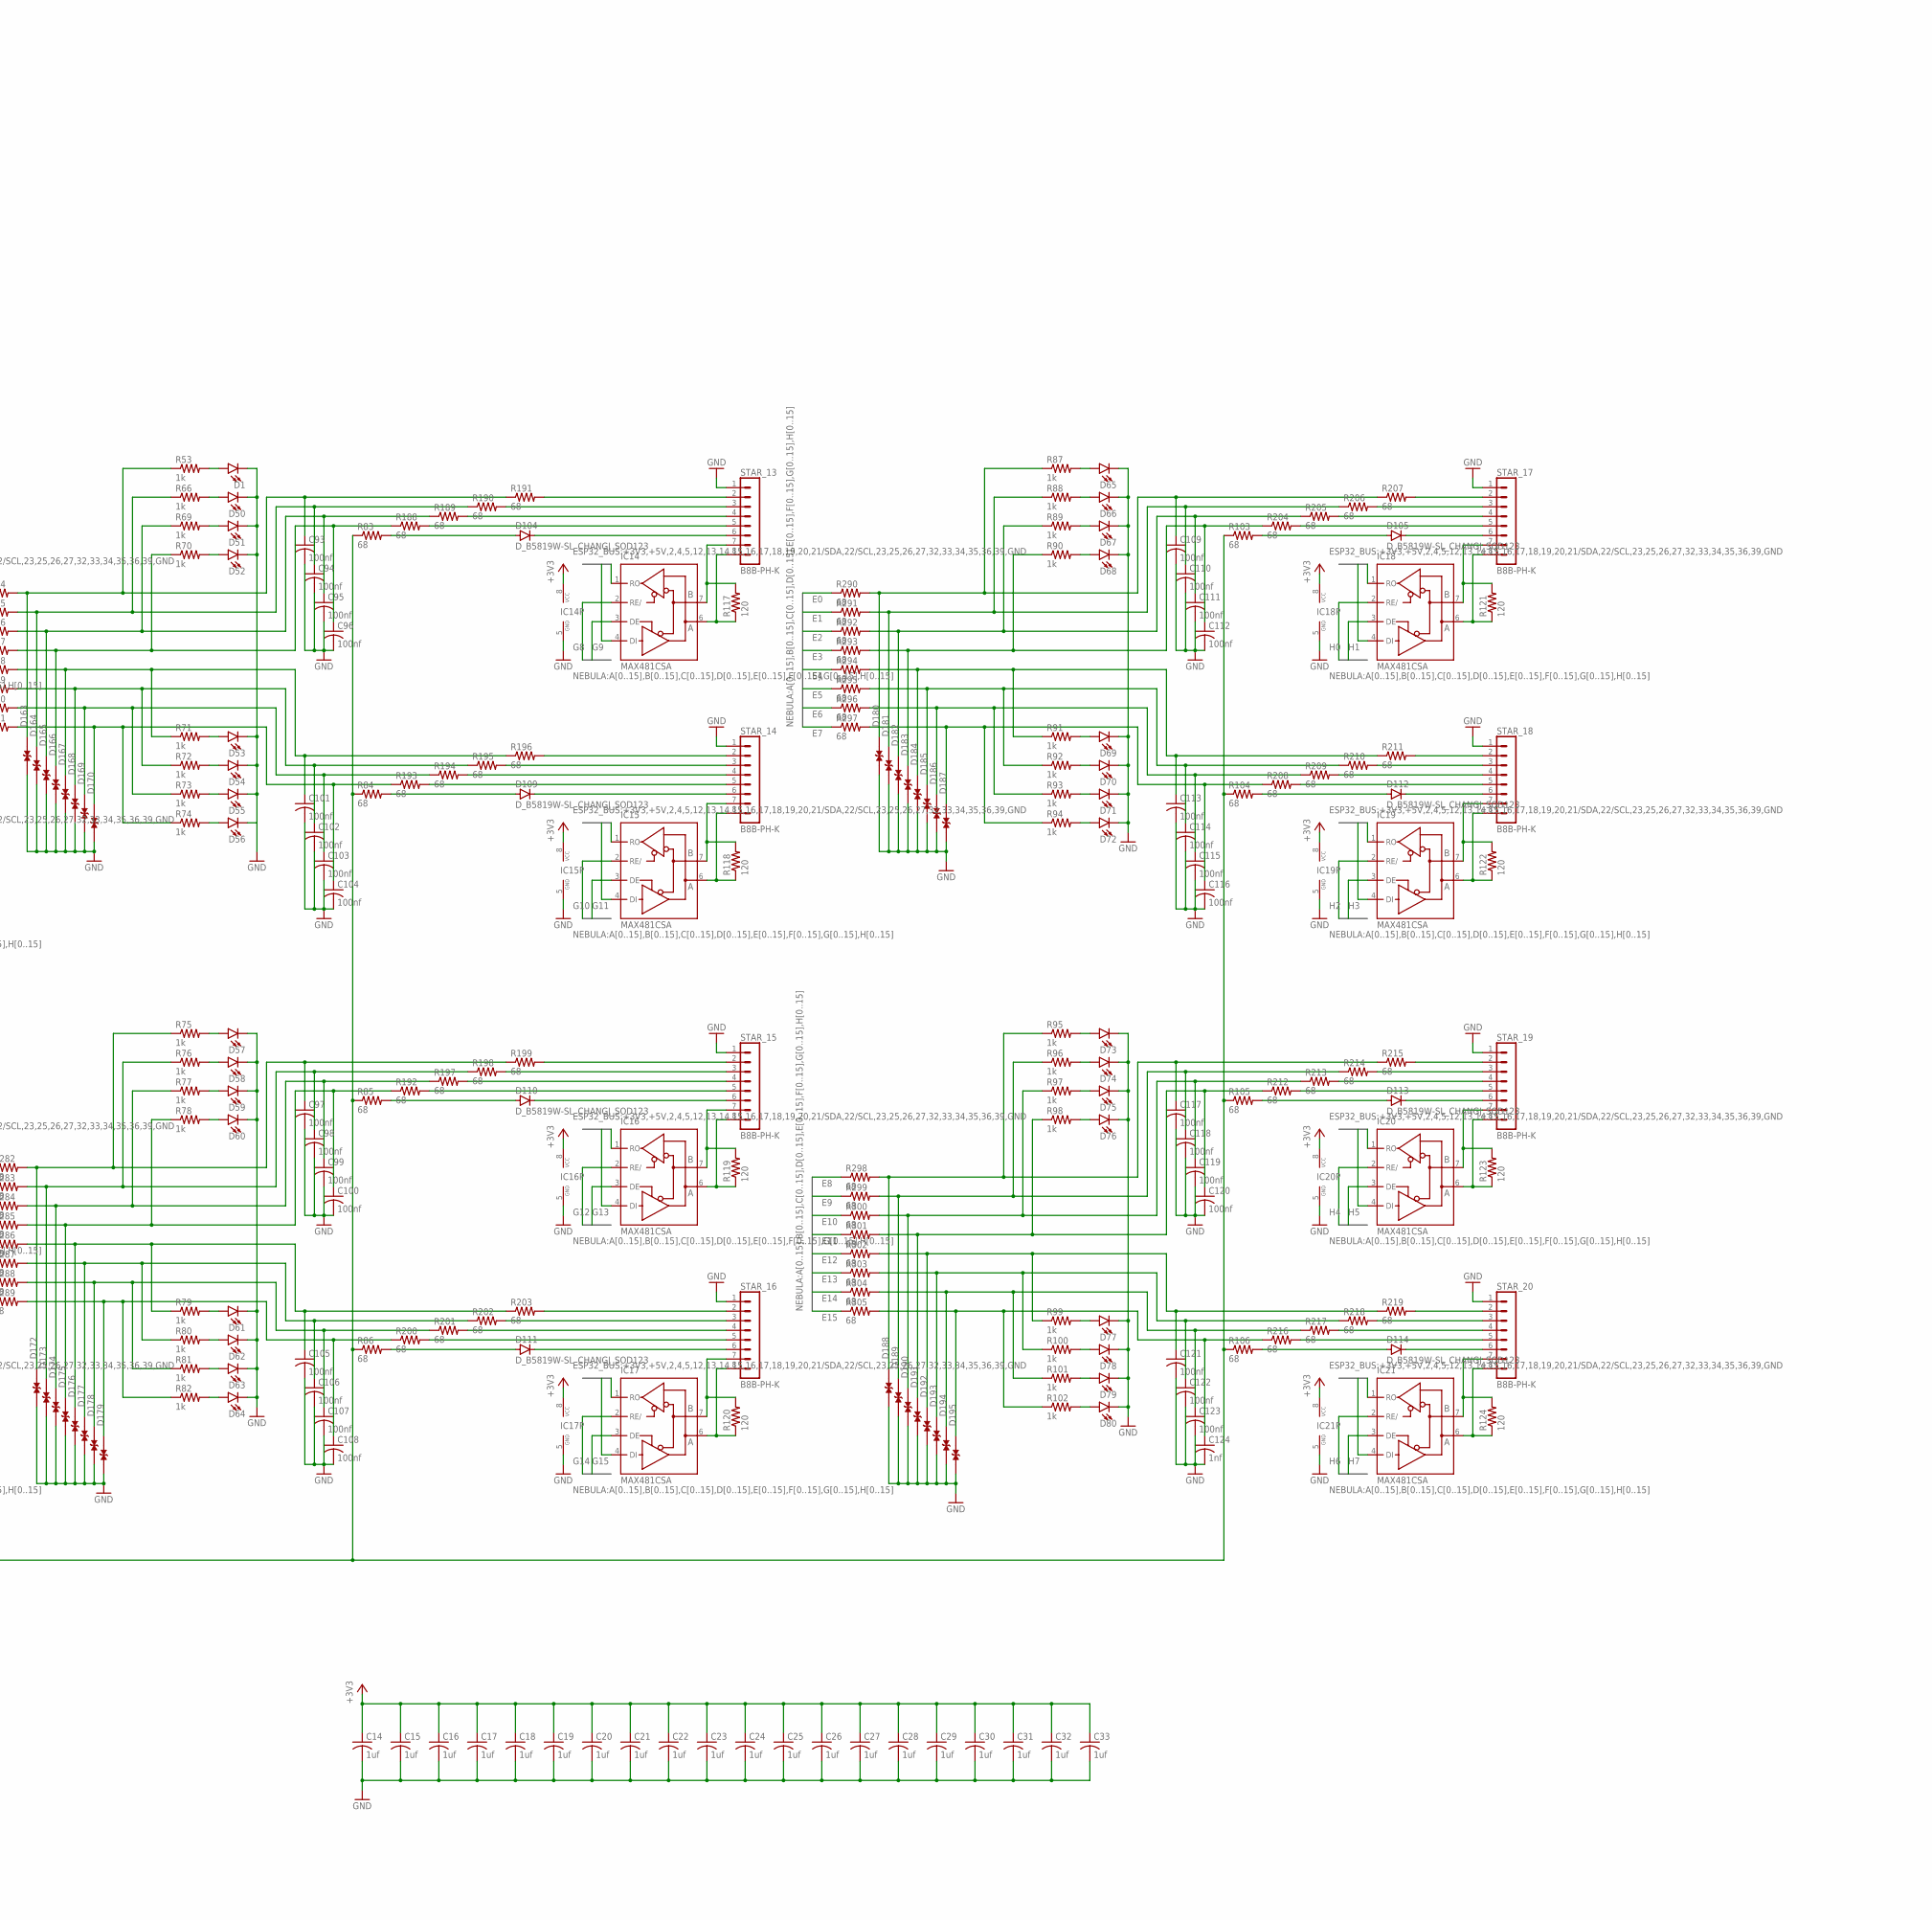
[picture p8: schematic core.sch, part in row 1, column 3]

Parts:
ACCESSORY: PINHD-1X5; 1X05
ACCESSORY_GPIO: PINHD-1X5; 1X05
APA102: B4B-PH-K
C1, C2, C3, C5, C7, C8, C9, C10, C11, C12, C13, C34, C35, C36: 10uf; C0603; LCSC_PART C19702
C4, C6, C14, C15, C16, C17, C18, C19, C20, C21, C22, C23, C24, C25, C26, C27, C28, C29, C30, C31, C32, C33, C130: 1uf; C0805; LCSC_PART C15849
C37, C38, C39, C40, C41, C42, C43, C44, C45, C46, C47, C48, C49, C50, C51, C52, C53, C54, C55, C56, C57, C58, C59, C60, C61, C62, C63, C64, C65, C66, C67, C68, C73, C74, C75, C76, C77, C78, C79, C80, C81, C82, C83, C84, C85, C86, C87, C88, C93, C94, C95, C96, C97, C98, C99, C100, C101, C102, C103, C104, C105, C106, C107, C108, C109, C110, C111, C112, C113, C114, C115, C116, C117, C118, C119, C120, C121, C122, C123: 100nf; C0603; LCSC_PART C14663
C69, C70, C71, C72, C89, C90: 2200uf; E5-13
C124: 1nf; C0603; LCSC_PART C1588
C125: C_1NF/50V_0603; C0603
C126, C127: C_100NF/50V_0603; C0603
D1, D2, D6, D10, D14, D18, D22, D26, D30, D34, D38, D42, D46, D53, D57, D61, D65, D69, D73, D77: LED0603; LED-0603; LCSC_PART C2286
D3, D7, D11, D15, D19, D23, D27, D31, D35, D39, D43, D47, D50, D54, D58, D62, D66, D70, D74, D78: LED0603; LED-0603; LCSC_PART C72043
D4, D8, D12, D16, D20, D24, D28, D32, D36, D40, D44, D48, D51, D55, D59, D63, D67, D71, D75, D79: LED0603; LED-0603; LCSC_PART C72041
D5, D9, D13, D17, D21, D25, D29, D33, D37, D41, D45, D49, D52, D56, D60, D64, D68, D72, D76, D80: LED0603; LED-0603; LCSC_PART C2290
D81, D86, D91: red; LED-0603; LCSC_PART C2286
D82, D87, D92: green; LED-0603; LCSC_PART C72043
D83, D88, D93: blue; LED-0603; LCSC_PART C72041
D84, D89: white; LED-0603; LCSC_PART C2290
D85, D90, D94: yellow; LED-0603; LCSC_PART C72038
D95, D96, D97, D98, D99, D100, D101, D102, D103, D104, D105, D106, D107, D108, D109, D110, D111, D112, D113, D114, D198: D_B5819W-SL_CHANGJ_SOD123; SOD123
D115, D116, D117, D118, D119, D120, D121, D122, D123, D124, D125, D126, D127, D128, D129, D130, D131, D132, D133, D134, D135, D136, D137, D138, D139, D140, D141, D142, D143, D144, D145, D146, D147, D148, D149, D150, D151, D152, D153, D154, D155, D156, D157, D158, D159, D160, D161, D162, D163, D164, D165, D166, D167, D168, D169, D170, D171, D172, D173, D174, D175, D176, D177, D178, D179, D180, D181, D182, D183, D184, D185, D186, D187, D188, D189, D190, D191, D192, D193, D194, D195, D196, D197: SMBJ8.0CA; DIOM4336X265N; LCSC_PART C78757
ESTOP: B2B-PH-K
ESTOP_2: PINHD-1X2; 1X02
F1, F2: MF-MSMF-STYLE2_1; FUSC4632X160; LCSC_PART C78695
GAME_INTERFACE: B12B-PH-K
H1, H2, H3, H4: MOUNT-HOLE3.0; 3,0
I2C: PINHD-1X4; 1X04
IC1, IC3, IC4, IC5, IC6, IC7, IC8, IC9, IC10, IC11, IC12, IC13, IC14, IC15, IC16, IC17, IC18, IC19, IC20, IC21: MAX481CSA; SO08; LCSC_PART C8963
IC2: LD117AS12TR; SOT223; LCSC_PART C6187
IC22: LD117AS12TR; SOT223; LCSC_PART C347222
J1: CONN_05X2SHD; 2X5-SHROUDED
JP2: PINHD-1X4; 1X04
JP3, JP4: PINHD-2X2; 2X02
JTAG: PINHD-1X5; 1X05
MIDI_IN: B4B-PH-K
NEBULA_A: MCP23017-E/SO; SOIC127P1030X265-28N; LCSC_PART C629440
NEBULA_B: MCP23017-E/SO; SOIC127P1030X265-28N; LCSC_PART C629440
NEBULA_C: MCP23017-E/SO; SOIC127P1030X265-28N; LCSC_PART C629440
NEBULA_D: MCP23017-E/SO; SOIC127P1030X265-28N; LCSC_PART C629440
NEBULA_E: MCP23017-E/SO; SOIC127P1030X265-28N; LCSC_PART C629440
NEBULA_F: MCP23017-E/SO; SOIC127P1030X265-28N; LCSC_PART C629440
NEBULA_G: MCP23017-E/SO; SOIC127P1030X265-28N; LCSC_PART C629440
NEBULA_H: MCP23017-E/SO; SOIC127P1030X265-28N; LCSC_PART C629440
POWER_IN: MKDSN1,5/4-5,08
R1, R2, R107, R108, R109, R110, R111, R112, R113, R114, R115, R116, R117, R118, R119, R120, R121, R122, R123, R124: 120; R0603; LCSC_PART C22787
R3, R4, R5, R6, R7, R8, R9, R10, R11, R12, R13, R14, R15, R16, R17, R18, R19, R20, R21, R22, R23, R24, R25, R28, R29, R30, R31, R32, R33, R34, R35, R36, R37, R38, R39, R40, R41, R42, R43, R44, R45, R46, R47, R48, R49, R50, R51, R52, R53, R66, R69, R70, R71, R72, R73, R74, R75, R76, R77, R78, R79, R80, R81, R82, R87, R88, R89, R90, R91, R92, R93, R94, R95, R96, R97, R98, R99, R100, R101, R102, R125, R126, R127, R128, R129, R130, R139: 1k; R0603; LCSC_PART C21190
R26, R27: R_2K_0603; R0603
R54, R55, R56, R57, R58, R59, R60, R61, R62, R63, R64, R65, R83, R84, R85, R86, R103, R104, R105, R106, R140, R141, R142, R143, R144, R145, R146, R147, R148, R149, R150, R151, R152, R153, R154, R155, R156, R157, R158, R159, R160, R161, R162, R163, R164, R165, R166, R167, R168, R169, R170, R171, R172, R173, R174, R175, R176, R177, R178, R179, R180, R181, R182, R183, R184, R185, R186, R187, R188, R189, R190, R191, R192, R193, R194, R195, R196, R197, R198, R199, R200, R201, R202, R203, R204, R205, R206, R207, R208, R209, R210, R211, R212, R213, R214, R215, R216, R217, R218, R219, R226, R227, R228, R229, R230, R231, R232, R233, R234, R235, R236, R237, R238, R239, R240, R241, R242, R243, R244, R245, R246, R247, R248, R249, R250, R251, R252, R253, R254, R255, R256, R257, R258, R259, R260, R261, R262, R263, R264, R265, R266, R267, R268, R269, R270, R271, R272, R273, R274, R275, R276, R277, R278, R279, R280, R281, R282, R283, R284, R285, R286, R287, R288, R289, R290, R291, R292, R293, R294, R295, R296, R297, R298, R299, R300, R301, R302, R303, R304, R305: 68; R0603; LCSC_PART c27592
R67, R133, R134, R135, R136, R137: 10k; R0603; LCSC_PART C25804
R68, R138: 10; R1206; LCSC_PART C17903
R131: 2.2k; R0603; LCSC_PART C4190
R132, R225, R310: R_1K_0603; R0603
R220, R223: R_270R_0603; R0603
R221, R222: R_56R_0603; R0603
R224: R_82R_0603; R0603
R306, R307: R_220R_0603; R0603
S1, S2, S3, S4, S5: MOMENTARY-SWITCH-SPST-PTH-6.0MM; TACTILE_SWITCH_PTH_6.0MM
STAR_1, STAR_2, STAR_3, STAR_4, STAR_5, STAR_6, STAR_7, STAR_8, STAR_9, STAR_10, STAR_11, STAR_12, STAR_13, STAR_14, STAR_15, STAR_16, STAR_17, STAR_18, STAR_19, STAR_20: B8B-PH-K
U1: 6N138SDM; COUPL_6N138SDM; LCSC_PART C188666
U2: ESP32-S3-DEVKITC-1-N8R2; XCVR_ESP32-S3-DEVKITC-1-N8R2
U$1: ESP32DEVKITV1; ESP32-DEVKITV1
ULN2: ULN2803SOICW; SO18L

Connections:
2: JP2.2, U$1.4 (IO2)
3V3: U2.J1_1 (3V3), U2.J1_2 (3V3)
4: APA102.3, D196.2, U$1.5 (IO4)
5: JP2.3, U$1.8 (IO5)
5V0: U2.J1_21 (5V0)
12: JTAG.2, U$1.27 (IO12)
13: C125.2, D94.A, JTAG.3, R225.1, U$1.28 (IO13)
14: JTAG.4, U$1.26 (IO14)
15: JTAG.5, U$1.3 (IO15)
16: IC1.1 (RO), IC3.1 (RO), IC4.1 (RO), IC5.1 (RO), IC6.1 (RO), IC7.1 (RO), IC8.1 (RO), IC9.1 (RO), IC10.1 (RO), IC11.1 (RO), IC12.1 (RO), IC13.1 (RO), IC14.1 (RO), IC15.1 (RO), IC16.1 (RO), IC17.1 (RO), IC18.1 (RO), IC19.1 (RO), IC20.1 (RO), IC21.1 (RO), U$1.6 (IO16)
17: IC1.4 (DI), IC3.4 (DI), IC4.4 (DI), IC5.4 (DI), IC6.4 (DI), IC7.4 (DI), IC8.4 (DI), IC9.4 (DI), IC10.4 (DI), IC11.4 (DI), IC12.4 (DI), IC13.4 (DI), IC14.4 (DI), IC15.4 (DI), IC16.4 (DI), IC17.4 (DI), IC18.4 (DI), IC19.4 (DI), IC20.4 (DI), IC21.4 (DI), U$1.7 (IO17)
18: APA102.2, D197.2, U$1.9 (IO18)
19: J1.1, R307.1, R310.1, R310.2, U1.6 (VO), U$1.10 (IO19)
21/SDA: I2C.4, J1.7, NEBULA_A.13 (SDA), NEBULA_B.13 (SDA), NEBULA_C.13 (SDA), NEBULA_D.13 (SDA), NEBULA_E.13 (SDA), NEBULA_F.13 (SDA), NEBULA_G.13 (SDA), NEBULA_H.13 (SDA), R26.1, U$1.11 (IO21)
22/SCL: I2C.3, J1.8, NEBULA_A.12 (SCK), NEBULA_B.12 (SCK), NEBULA_C.12 (SCK), NEBULA_D.12 (SCK), NEBULA_E.12 (SCK), NEBULA_F.12 (SCK), NEBULA_G.12 (SCK), NEBULA_H.12 (SCK), R27.1, U$1.14 (IO22)
23: U$1.15 (IO23), ULN2.8
25: U$1.23 (IO25), ULN2.7
26: U$1.24 (IO26), ULN2.6
27: U$1.25 (IO27), ULN2.5
32: U$1.21 (IO32), ULN2.4
33: J1.2, U$1.22 (IO33)
34: J1.3, U$1.19 (IO34)
35: J1.4, U$1.20 (IO35)
36: J1.5, U$1.17 (VP)
39: J1.6, NEBULA_H.19 (INTB), U$1.18 (VN)
+3V3: ACCESSORY_GPIO.5, C3.1, C7.1, C8.1, C9.1, C10.1, C11.1, C12.1, C13.1, C14.1, C15.1, C16.1, C17.1, C18.1, C19.1, C20.1, C21.1, C22.1, C23.1, C24.1, C25.1, C26.1, C27.1, C28.1, C29.1, C30.1, C31.1, C32.1, C33.1, C34.1, C36.1, C70.+, C72.+, D91.A, I2C.1, IC1.8 (VCC), IC3.8 (VCC), IC4.8 (VCC), IC5.8 (VCC), IC6.8 (VCC), IC7.8 (VCC), IC8.8 (VCC), IC9.8 (VCC), IC10.8 (VCC), IC11.8 (VCC), IC12.8 (VCC), IC13.8 (VCC), IC14.8 (VCC), IC15.8 (VCC), IC16.8 (VCC), IC17.8 (VCC), IC18.8 (VCC), IC19.8 (VCC), IC20.8 (VCC), IC21.8 (VCC), IC22.4 (OUT), J1.9, JP2.4, NEBULA_A.9 (VDD), NEBULA_A.18 (!RESET), NEBULA_B.9 (VDD), NEBULA_B.15 (A0), NEBULA_B.18 (!RESET), NEBULA_C.9 (VDD), NEBULA_C.16 (A1), NEBULA_C.18 (!RESET), NEBULA_D.9 (VDD), NEBULA_D.15 (A0), NEBULA_D.16 (A1), NEBULA_D.18 (!RESET), NEBULA_E.9 (VDD), NEBULA_E.17 (A2), NEBULA_E.18 (!RESET), NEBULA_F.9 (VDD), NEBULA_F.15 (A0), NEBULA_F.17 (A2), NEBULA_F.18 (!RESET), NEBULA_G.9 (VDD), NEBULA_G.16 (A1), NEBULA_G.17 (A2), NEBULA_G.18 (!RESET), NEBULA_H.9 (VDD), NEBULA_H.15 (A0), NEBULA_H.16 (A1), NEBULA_H.17 (A2), NEBULA_H.18 (!RESET), R26.2, R27.2, R68.2, R133.1, R134.1, R135.1, R136.1, R137.1, R138.2, R220.1, R221.1, R222.1, R223.1, R224.1, R307.2, U$1.1 (3V3)
+5V: APA102.4, C5.1, C69.+, C71.+, C130.1, D92.A, IC2.4 (OUT), POWER_IN.2, R125.1, R126.1, R127.1, R128.1, R129.1, U1.8 (VCC), U$1.30 (VIN)
+12V: ACCESSORY.5, C2.1, C4.1, C6.1, C35.1, C89.+, D93.A, F1.2, IC2.3 (IN), IC22.3 (IN), ULN2.10
+14V: C90.+, F2.2, GAME_INTERFACE.12
A0: NEBULA_A.21 (GPA0), R226.1
A1: NEBULA_A.22 (GPA1), R227.1
A2: NEBULA_A.23 (GPA2), R228.1
A3: NEBULA_A.24 (GPA3), R229.1
A4: NEBULA_A.25 (GPA4), R230.1
A5: NEBULA_A.26 (GPA5), R231.1
A6: NEBULA_A.27 (GPA6), R232.1
A7: NEBULA_A.28 (GPA7), R233.1
A8: NEBULA_A.1 (GPB0), R234.1
A9: NEBULA_A.2 (GPB1), R235.1
A10: NEBULA_A.3 (GPB2), R236.1
A11: NEBULA_A.4 (GPB3), R237.1
A12: NEBULA_A.5 (GPB4), R238.1
A13: NEBULA_A.6 (GPB5), R239.1
A14: NEBULA_A.7 (GPB6), R240.1
A15: NEBULA_A.8 (GPB7), R241.1
B0: NEBULA_B.21 (GPA0), R242.1
B1: NEBULA_B.22 (GPA1), R243.1
B2: NEBULA_B.23 (GPA2), R244.1
B3: NEBULA_B.24 (GPA3), R245.1
B4: NEBULA_B.25 (GPA4), R246.1
B5: NEBULA_B.26 (GPA5), R247.1
B6: NEBULA_B.27 (GPA6), R248.1
B7: NEBULA_B.28 (GPA7), R249.1
B8: NEBULA_B.1 (GPB0), R250.1
B9: NEBULA_B.2 (GPB1), R251.1
B10: NEBULA_B.3 (GPB2), R252.1
B11: NEBULA_B.4 (GPB3), R253.1
B12: NEBULA_B.5 (GPB4), R254.1
B13: NEBULA_B.6 (GPB5), R255.1
B14: NEBULA_B.7 (GPB6), R256.1
B15: NEBULA_B.8 (GPB7), R257.1
C0: NEBULA_C.21 (GPA0), R258.1
C1: NEBULA_C.22 (GPA1), R259.1
C2: NEBULA_C.23 (GPA2), R260.1
C3: NEBULA_C.24 (GPA3), R261.1
C4: NEBULA_C.25 (GPA4), R262.1
C5: NEBULA_C.26 (GPA5), R263.1
C6: NEBULA_C.27 (GPA6), R264.1
C7: NEBULA_C.28 (GPA7), R265.1
C8: NEBULA_C.1 (GPB0), R266.1
C9: NEBULA_C.2 (GPB1), R267.1
C10: NEBULA_C.3 (GPB2), R268.1
C11: NEBULA_C.4 (GPB3), R269.1
C12: NEBULA_C.5 (GPB4), R270.1
C13: NEBULA_C.6 (GPB5), R271.1
C14: NEBULA_C.7 (GPB6), R272.1
C15: NEBULA_C.8 (GPB7), R273.1
D0: NEBULA_D.21 (GPA0), R274.1
D1: NEBULA_D.22 (GPA1), R275.1
D2: NEBULA_D.23 (GPA2), R276.1
D3: NEBULA_D.24 (GPA3), R277.1
D4: NEBULA_D.25 (GPA4), R278.1
D5: NEBULA_D.26 (GPA5), R279.1
D6: NEBULA_D.27 (GPA6), R280.1
D7: NEBULA_D.28 (GPA7), R281.1
D8: NEBULA_D.1 (GPB0), R282.1
D9: NEBULA_D.2 (GPB1), R283.1
D10: NEBULA_D.3 (GPB2), R284.1
D11: NEBULA_D.4 (GPB3), R285.1
D12: NEBULA_D.5 (GPB4), R286.1
D13: NEBULA_D.6 (GPB5), R287.1
D14: NEBULA_D.7 (GPB6), R288.1
D15: NEBULA_D.8 (GPB7), R289.1
E0: NEBULA_E.21 (GPA0), R290.1
E1: NEBULA_E.22 (GPA1), R291.1
E2: NEBULA_E.23 (GPA2), R292.1
E3: NEBULA_E.24 (GPA3), R293.1
E4: NEBULA_E.25 (GPA4), R294.1
E5: NEBULA_E.26 (GPA5), R295.1
E6: NEBULA_E.27 (GPA6), R296.1
E7: NEBULA_E.28 (GPA7), R297.1
E8: NEBULA_E.1 (GPB0), R298.1
E9: NEBULA_E.2 (GPB1), R299.1
E10: NEBULA_E.3 (GPB2), R300.1
E11: NEBULA_E.4 (GPB3), R301.1
E12: NEBULA_E.5 (GPB4), R302.1
E13: NEBULA_E.6 (GPB5), R303.1
E14: NEBULA_E.7 (GPB6), R304.1
E15: NEBULA_E.8 (GPB7), R305.1
F0: IC1.2 (RE/), NEBULA_F.21 (GPA0)
F1: IC1.3 (DE), NEBULA_F.22 (GPA1)
F2: IC3.2 (RE/), NEBULA_F.23 (GPA2)
F3: IC3.3 (DE), NEBULA_F.24 (GPA3)
F4: IC4.2 (RE/), NEBULA_F.25 (GPA4)
F5: IC4.3 (DE), NEBULA_F.26 (GPA5)
F6: IC5.2 (RE/), NEBULA_F.27 (GPA6)
F7: IC5.3 (DE), NEBULA_F.28 (GPA7)
F8: IC6.2 (RE/), NEBULA_F.1 (GPB0)
F9: IC6.3 (DE), NEBULA_F.2 (GPB1)
F10: IC7.2 (RE/), NEBULA_F.3 (GPB2)
F11: IC7.3 (DE), NEBULA_F.4 (GPB3)
F12: IC8.2 (RE/), NEBULA_F.5 (GPB4)
F13: IC8.3 (DE), NEBULA_F.6 (GPB5)
F14: IC9.2 (RE/), NEBULA_F.7 (GPB6)
F15: IC9.3 (DE), NEBULA_F.8 (GPB7)
G0: IC10.2 (RE/), NEBULA_G.21 (GPA0)
G1: IC10.3 (DE), NEBULA_G.22 (GPA1)
G2: IC11.2 (RE/), NEBULA_G.23 (GPA2)
G3: IC11.3 (DE), NEBULA_G.24 (GPA3)
G4: IC12.2 (RE/), NEBULA_G.25 (GPA4)
G5: IC12.3 (DE), NEBULA_G.26 (GPA5)
G6: IC13.2 (RE/), NEBULA_G.27 (GPA6)
G7: IC13.3 (DE), NEBULA_G.28 (GPA7)
G8: IC14.2 (RE/), NEBULA_G.1 (GPB0)
G9: IC14.3 (DE), NEBULA_G.2 (GPB1)
G10: IC15.2 (RE/), NEBULA_G.3 (GPB2)
G11: IC15.3 (DE), NEBULA_G.4 (GPB3)
G12: IC16.2 (RE/), NEBULA_G.5 (GPB4)
G13: IC16.3 (DE), NEBULA_G.6 (GPB5)
G14: IC17.2 (RE/), NEBULA_G.7 (GPB6)
G15: IC17.3 (DE), NEBULA_G.8 (GPB7)
GND: ACCESSORY.1, ACCESSORY_GPIO.1, APA102.1, C1.2, C2.2, C3.2, C4.2, C5.2, C6.2, C7.2, C8.2, C9.2, C10.2, C11.2, C12.2, C13.2, C14.2, C15.2, C16.2, C17.2, C18.2, C19.2, C20.2, C21.2, C22.2, C23.2, C24.2, C25.2, C26.2, C27.2, C28.2, C29.2, C30.2, C31.2, C32.2, C33.2, C34.2, C35.2, C36.2, C37.2, C38.2, C39.2, C40.2, C41.2, C42.2, C43.2, C44.2, C45.2, C46.2, C47.2, C48.2, C49.2, C50.2, C51.2, C52.2, C53.2, C54.2, C55.2, C56.2, C57.2, C58.2, C59.2, C60.2, C61.2, C62.2, C63.2, C64.2, C65.2, C66.2, C67.2, C68.2, C69.-, C70.-, C71.-, C72.-, C73.2, C74.2, C75.2, C76.2, C77.2, C78.2, C79.2, C80.2, C81.2, C82.2, C83.2, C84.2, C85.2, C86.2, C87.2, C88.2, C89.-, C90.-, C93.2, C94.2, C95.2, C96.2, C97.2, C98.2, C99.2, C100.2, C101.2, C102.2, C103.2, C104.2, C105.2, C106.2, C107.2, C108.2, C109.2, C110.2, C111.2, C112.2, C113.2, C114.2, C115.2, C116.2, C117.2, C118.2, C119.2, C120.2, C121.2, C122.2, C123.2, C124.2, C125.1, C126.2, C127.2, C130.2, D1.C, D2.C, D3.C, D4.C, D5.C, D6.C, D7.C, D8.C, D9.C, D10.C, D11.C, D12.C, D13.C, D14.C, D15.C, D16.C, D17.C, D18.C, D19.C, D20.C, D21.C, D22.C, D23.C, D24.C, D25.C, D26.C, D27.C, D28.C, D29.C, D30.C, D31.C, D32.C, D33.C, D34.C, D35.C, D36.C, D37.C, D38.C, D39.C, D40.C, D41.C, D42.C, D43.C, D44.C, D45.C, D46.C, D47.C, D48.C, D49.C, D50.C, D51.C, D52.C, D53.C, D54.C, D55.C, D56.C, D57.C, D58.C, D59.C, D60.C, D61.C, D62.C, D63.C, D64.C, D65.C, D66.C, D67.C, D68.C, D69.C, D70.C, D71.C, D72.C, D73.C, D74.C, D75.C, D76.C, D77.C, D78.C, D79.C, D80.C, D115.1, D116.1, D117.1, D118.1, D119.1, D120.1, D121.1, D122.1, D123.1, D124.1, D125.1, D126.1, D127.1, D128.1, D129.1, D130.1, D131.1, D132.1, D133.1, D134.1, D135.1, D136.1, D137.1, D138.1, D139.1, D140.1, D141.1, D142.1, D143.1, D144.1, D145.1, D146.1, D147.1, D148.1, D149.1, D150.1, D151.1, D152.1, D153.1, D154.1, D155.1, D156.1, D157.1, D158.1, D159.1, D160.1, D161.1, D162.1, D163.1, D164.1, D165.1, D166.1, D167.1, D168.1, D169.1, D170.1, D171.1, D172.1, D173.1, D174.1, D175.1, D176.1, D177.1, D178.1, D179.1, D180.1, D181.1, D182.1, D183.1, D184.1, D185.1, D186.1, D187.1, D188.1, D189.1, D190.1, D191.1, D192.1, D193.1, D194.1, D195.1, D196.1, D197.1, GAME_INTERFACE.1, I2C.2, IC1.5 (GND), IC2.1 (ADJ), IC3.5 (GND), IC4.5 (GND), IC5.5 (GND), IC6.5 (GND), IC7.5 (GND), IC8.5 (GND), IC9.5 (GND), IC10.5 (GND), IC11.5 (GND), IC12.5 (GND), IC13.5 (GND), IC14.5 (GND), IC15.5 (GND), IC16.5 (GND), IC17.5 (GND), IC18.5 (GND), IC19.5 (GND), IC20.5 (GND), IC21.5 (GND), IC22.1 (ADJ), J1.10, JP2.1, JP3.1, JP3.2, JP3.3, JP3.4, JP4.1, JP4.2, JP4.3, JP4.4, JTAG.1, NEBULA_A.10 (VSS), NEBULA_A.15 (A0), NEBULA_A.16 (A1), NEBULA_A.17 (A2), NEBULA_B.10 (VSS), NEBULA_B.16 (A1), NEBULA_B.17 (A2), NEBULA_C.10 (VSS), NEBULA_C.15 (A0), NEBULA_C.17 (A2), NEBULA_D.10 (VSS), NEBULA_D.17 (A2), NEBULA_E.10 (VSS), NEBULA_E.15 (A0), NEBULA_E.16 (A1), NEBULA_F.10 (VSS), NEBULA_F.16 (A1), NEBULA_G.10 (VSS), NEBULA_G.15 (A0), NEBULA_H.10 (VSS), POWER_IN.1, POWER_IN.3, R67.2, R130.2, R131.2, R132.2, R139.2, S1.3 (2), S2.3 (2), S3.3 (2), S4.3 (2), S5.3 (2), STAR_1.1, STAR_2.1, STAR_3.1, STAR_4.1, STAR_5.1, STAR_6.1, STAR_7.1, STAR_8.1, STAR_9.1, STAR_10.1, STAR_11.1, STAR_12.1, STAR_13.1, STAR_14.1, STAR_15.1, STAR_16.1, STAR_17.1, STAR_18.1, STAR_19.1, STAR_20.1, U1.5 (GND), U2.J1_22 (GND), U2.J3_1 (GND), U2.J3_21 (GND), U2.J3_22 (GND), U$1.2 (GND), U$1.29 (GND1), ULN2.9
H0: IC18.2 (RE/), NEBULA_H.21 (GPA0)
H1: IC18.3 (DE), NEBULA_H.22 (GPA1)
H2: IC19.2 (RE/), NEBULA_H.23 (GPA2)
H3: IC19.3 (DE), NEBULA_H.24 (GPA3)
H4: IC20.2 (RE/), NEBULA_H.25 (GPA4)
H5: IC20.3 (DE), NEBULA_H.26 (GPA5)
H6: IC21.2 (RE/), NEBULA_H.27 (GPA6)
H7: IC21.3 (DE), NEBULA_H.28 (GPA7)
H8: D86.C, GAME_INTERFACE.2, NEBULA_H.1 (GPB0), R137.2, S1.1
H9: D87.C, GAME_INTERFACE.3, NEBULA_H.2 (GPB1), R136.2, S2.1
H10: D88.C, GAME_INTERFACE.4, NEBULA_H.3 (GPB2), R135.2, S3.1
H11: D90.C, GAME_INTERFACE.5, NEBULA_H.4 (GPB3), R134.2, S4.1
H12: D89.C, GAME_INTERFACE.6, NEBULA_H.5 (GPB4), R133.2, S5.1
H13: ACCESSORY_GPIO.2, NEBULA_H.6 (GPB5), ULN2.3
H14: ACCESSORY_GPIO.3, NEBULA_H.7 (GPB6), ULN2.2
H15: ACCESSORY_GPIO.4, NEBULA_H.8 (GPB7), ULN2.1
unnamed: C1.1, U$1.16 (EN)
unnamed: D98.A, R57.2
unnamed: D2.A, R3.2
unnamed: D3.A, R4.2
unnamed: D4.A, R5.2
unnamed: D5.A, R6.2
unnamed: D98.C, STAR_4.6
unnamed: D97.A, R56.2
unnamed: D95.A, R54.2
unnamed: D102.A, R61.2
unnamed: D6.A, R7.2
unnamed: D7.A, R8.2
unnamed: D8.A, R9.2
unnamed: D9.A, R10.2
unnamed: D102.C, STAR_8.6
unnamed: D101.A, R60.2
unnamed: D101.C, STAR_7.6
unnamed: D103.A, R62.2
unnamed: D103.C, STAR_9.6
unnamed: D14.A, R15.2
unnamed: D15.A, R16.2
unnamed: D16.A, R17.2
unnamed: D17.A, R18.2
unnamed: D104.A, R83.2
unnamed: D104.C, STAR_13.6
unnamed: D56.A, R74.2
unnamed: D55.A, R73.2
unnamed: D13.A, R14.2
unnamed: D12.A, R13.2
unnamed: D11.A, R12.2
unnamed: D10.A, R11.2
unnamed: D54.A, R72.2
unnamed: D53.A, R71.2
unnamed: D80.A, R102.2
unnamed: D1.A, R53.2
unnamed: D25.A, R28.2
unnamed: D24.A, R25.2
unnamed: D23.A, R24.2
unnamed: D22.A, R23.2
unnamed: D50.A, R66.2
unnamed: D51.A, R69.2
unnamed: D52.A, R70.2
unnamed: D61.A, R79.2
unnamed: D21.A, R22.2
unnamed: D20.A, R21.2
unnamed: D19.A, R20.2
unnamed: D18.A, R19.2
unnamed: D62.A, R80.2
unnamed: D63.A, R81.2
unnamed: D64.A, R82.2
unnamed: D81.C, GAME_INTERFACE.7, ULN2.11
unnamed: D26.A, R29.2
unnamed: D27.A, R30.2
unnamed: D28.A, R31.2
unnamed: D29.A, R32.2
unnamed: D82.C, GAME_INTERFACE.8, ULN2.12
unnamed: D83.C, GAME_INTERFACE.9, ULN2.13
unnamed: D85.C, GAME_INTERFACE.10, ULN2.14
unnamed: D84.C, GAME_INTERFACE.11, ULN2.15
unnamed: D30.A, R33.2
unnamed: D31.A, R34.2
unnamed: D32.A, R35.2
unnamed: D33.A, R36.2
unnamed: D57.A, R75.2
unnamed: D58.A, R76.2
unnamed: D59.A, R77.2
unnamed: D60.A, R78.2
unnamed: D34.A, R37.2
unnamed: D35.A, R38.2
unnamed: D36.A, R39.2
unnamed: D37.A, R40.2
unnamed: D106.A, R63.2
unnamed: D106.C, STAR_10.6
unnamed: D107.A, R64.2
unnamed: D107.C, STAR_11.6
unnamed: D38.A, R41.2
unnamed: D39.A, R42.2
unnamed: D40.A, R43.2
unnamed: D41.A, R44.2
unnamed: D79.A, R101.2
unnamed: D78.A, R100.2
unnamed: D77.A, R99.2
unnamed: D76.A, R98.2
unnamed: D42.A, R45.2
unnamed: D43.A, R46.2
unnamed: D44.A, R47.2
unnamed: D75.A, R97.2
unnamed: ESTOP.2, ESTOP_2.2, R68.1, R138.1
unnamed: D74.A, R96.2
unnamed: D73.A, R95.2
unnamed: D65.A, R87.2
unnamed: D45.A, R48.2
unnamed: D46.A, R49.2
unnamed: D47.A, R50.2
unnamed: D48.A, R51.2
unnamed: D66.A, R88.2
unnamed: D67.A, R89.2
unnamed: D68.A, R90.2
unnamed: D69.A, R91.2
unnamed: D70.A, R92.2
unnamed: D71.A, R93.2
unnamed: D72.A, R94.2
unnamed: D108.A, R65.2
unnamed: D108.C, STAR_12.6
unnamed: D111.A, R86.2
unnamed: D111.C, STAR_16.6
unnamed: IC1.7 (B), R1.2, STAR_1.7
unnamed: IC1.6 (A), R1.1, STAR_1.8
unnamed: IC3.7 (B), R2.2, STAR_2.7
unnamed: IC3.6 (A), R2.1, STAR_2.8
unnamed: IC4.7 (B), R107.2, STAR_3.7
unnamed: IC4.6 (A), R107.1, STAR_3.8
unnamed: IC5.7 (B), R108.2, STAR_4.7
unnamed: IC5.6 (A), R108.1, STAR_4.8
unnamed: IC6.7 (B), R109.2, STAR_5.7
unnamed: IC6.6 (A), R109.1, STAR_5.8
unnamed: IC7.7 (B), R110.2, STAR_6.7
unnamed: IC7.6 (A), R110.1, STAR_6.8
unnamed: IC8.7 (B), R111.2, STAR_7.7
unnamed: IC8.6 (A), R111.1, STAR_7.8
unnamed: IC9.7 (B), R112.2, STAR_8.7
unnamed: IC9.6 (A), R112.1, STAR_8.8
unnamed: IC10.7 (B), R113.2, STAR_9.7
unnamed: IC10.6 (A), R113.1, STAR_9.8
unnamed: IC11.7 (B), R114.2, STAR_10.7
unnamed: IC11.6 (A), R114.1, STAR_10.8
unnamed: IC12.7 (B), R115.2, STAR_11.7
unnamed: IC12.6 (A), R115.1, STAR_11.8
unnamed: IC13.7 (B), R116.2, STAR_12.7
unnamed: IC13.6 (A), R116.1, STAR_12.8
unnamed: IC14.7 (B), R117.2, STAR_13.7
unnamed: IC14.6 (A), R117.1, STAR_13.8
unnamed: IC15.7 (B), R118.2, STAR_14.7
unnamed: IC15.6 (A), R118.1, STAR_14.8
unnamed: IC16.7 (B), R119.2, STAR_15.7
unnamed: IC16.6 (A), R119.1, STAR_15.8
unnamed: IC17.7 (B), R120.2, STAR_16.7
unnamed: IC17.6 (A), R120.1, STAR_16.8
unnamed: IC18.7 (B), R121.2, STAR_17.7
unnamed: IC18.6 (A), R121.1, STAR_17.8
unnamed: IC19.7 (B), R122.2, STAR_18.7
unnamed: IC19.6 (A), R122.1, STAR_18.8
unnamed: IC20.7 (B), R123.2, STAR_19.7
unnamed: IC20.6 (A), R123.1, STAR_19.8
unnamed: IC21.7 (B), R124.2, STAR_20.7
unnamed: IC21.6 (A), R124.1, STAR_20.8
unnamed: ACCESSORY.2, ULN2.16
unnamed: ACCESSORY.3, ULN2.17
unnamed: ACCESSORY.4, ULN2.18
unnamed: D84.A, R129.2
unnamed: D85.A, R128.2
unnamed: D83.A, R127.2
unnamed: D82.A, R126.2
unnamed: D81.A, R125.2
unnamed: D91.C, R130.1
unnamed: D92.C, R131.1
unnamed: D93.C, R132.1
unnamed: D94.C, R139.1
unnamed: C37.1, D116.2, R3.1, R143.1, R226.2
unnamed: C38.1, D115.2, R4.1, R142.1, R227.2
unnamed: C39.1, D117.2, R5.1, R141.1, R228.2
unnamed: C40.1, D118.2, R6.1, R140.1, R229.2
unnamed: C44.1, D122.2, R10.1, R144.1, R233.2
unnamed: C43.1, D121.2, R9.1, R145.1, R232.2
unnamed: C42.1, D120.2, R8.1, R146.1, R231.2
unnamed: C41.1, D119.2, R7.1, R147.1, R230.2
unnamed: R143.2, STAR_1.2
unnamed: R142.2, STAR_1.3
unnamed: R141.2, STAR_1.4
unnamed: R140.2, STAR_1.5
unnamed: R147.2, STAR_2.2
unnamed: R146.2, STAR_2.3
unnamed: R145.2, STAR_2.4
unnamed: R144.2, STAR_2.5
unnamed: R151.2, STAR_3.2
unnamed: R150.2, STAR_3.3
unnamed: R149.2, STAR_3.4
unnamed: R148.2, STAR_3.5
unnamed: R155.2, STAR_4.2
unnamed: R154.2, STAR_4.3
unnamed: R153.2, STAR_4.4
unnamed: R152.2, STAR_4.5
unnamed: D49.A, R52.2
unnamed: C46.1, D124.2, R12.1, R150.1, R235.2
unnamed: C47.1, D125.2, R13.1, R149.1, R236.2
unnamed: C48.1, D126.2, R14.1, R148.1, R237.2
unnamed: C52.1, D130.2, R18.1, R152.1, R241.2
unnamed: C51.1, D129.2, R17.1, R153.1, R240.2
unnamed: C50.1, D128.2, R16.1, R154.1, R239.2
unnamed: C49.1, D127.2, R15.1, R155.1, R238.2
unnamed: C53.1, D131.2, R19.1, R159.1, R242.2
unnamed: C56.1, D134.2, R22.1, R156.1, R245.2
unnamed: C55.1, D133.2, R21.1, R157.1, R244.2
unnamed: C54.1, D132.2, R20.1, R158.1, R243.2
unnamed: C60.1, D138.2, R28.1, R160.1, R249.2
unnamed: C59.1, D137.2, R25.1, R161.1, R248.2
unnamed: C58.1, D136.2, R24.1, R162.1, R247.2
unnamed: C57.1, D135.2, R23.1, R163.1, R246.2
unnamed: R159.2, STAR_5.2
unnamed: R158.2, STAR_5.3
unnamed: R157.2, STAR_5.4
unnamed: R156.2, STAR_5.5
unnamed: R163.2, STAR_6.2
unnamed: R162.2, STAR_6.3
unnamed: R161.2, STAR_6.4
unnamed: R160.2, STAR_6.5
unnamed: R167.2, STAR_7.2
unnamed: R166.2, STAR_7.3
unnamed: R165.2, STAR_7.4
unnamed: R164.2, STAR_7.5
unnamed: R171.2, STAR_8.2
unnamed: R170.2, STAR_8.3
unnamed: R169.2, STAR_8.4
unnamed: R168.2, STAR_8.5
unnamed: C61.1, D139.2, R29.1, R167.1, R250.2
unnamed: C62.1, D140.2, R30.1, R166.1, R251.2
unnamed: C63.1, D141.2, R31.1, R165.1, R252.2
unnamed: C64.1, D142.2, R32.1, R164.1, R253.2
unnamed: C68.1, D146.2, R36.1, R168.1, R257.2
unnamed: C67.1, D145.2, R35.1, R169.1, R256.2
unnamed: C66.1, D144.2, R34.1, R170.1, R255.2
unnamed: C65.1, D143.2, R33.1, R171.1, R254.2
unnamed: R175.2, STAR_9.2
unnamed: R179.2, STAR_10.2
unnamed: R178.2, STAR_10.3
unnamed: R174.2, STAR_9.3
unnamed: R173.2, STAR_9.4
unnamed: R172.2, STAR_9.5
unnamed: R177.2, STAR_10.4
unnamed: R176.2, STAR_10.5
unnamed: R183.2, STAR_11.2
unnamed: R182.2, STAR_11.3
unnamed: R181.2, STAR_11.4
unnamed: R180.2, STAR_11.5
unnamed: R187.2, STAR_12.2
unnamed: R186.2, STAR_12.3
unnamed: R185.2, STAR_12.4
unnamed: R184.2, STAR_12.5
unnamed: C73.1, D147.2, R37.1, R175.1, R258.2
unnamed: C74.1, D148.2, R38.1, R174.1, R259.2
unnamed: C75.1, D149.2, R39.1, R173.1, R260.2
unnamed: C76.1, D150.2, R40.1, R172.1, R261.2
unnamed: R191.2, STAR_13.2
unnamed: C79.1, D153.2, R43.1, R177.1, R264.2
unnamed: C78.1, D152.2, R42.1, R178.1, R263.2
unnamed: C77.1, D151.2, R41.1, R179.1, R262.2
unnamed: C81.1, D155.2, R45.1, R183.1, R266.2
unnamed: C82.1, D156.2, R46.1, R182.1, R267.2
unnamed: C83.1, D157.2, R47.1, R181.1, R268.2
unnamed: C84.1, D158.2, R48.1, R180.1, R269.2
unnamed: C80.1, D154.2, R44.1, R176.1, R265.2
unnamed: C87.1, D161.2, R51.1, R185.1, R272.2
unnamed: C86.1, D160.2, R50.1, R186.1, R271.2
unnamed: C85.1, D159.2, R49.1, R187.1, R270.2
unnamed: R190.2, STAR_13.3
unnamed: R189.2, STAR_13.4
unnamed: R188.2, STAR_13.5
unnamed: R196.2, STAR_14.2
unnamed: C88.1, D162.2, R52.1, R184.1, R273.2
unnamed: R195.2, STAR_14.3
unnamed: R194.2, STAR_14.4
unnamed: R193.2, STAR_14.5
unnamed: R199.2, STAR_15.2
unnamed: R198.2, STAR_15.3
unnamed: R192.2, STAR_15.5
unnamed: R197.2, STAR_15.4
unnamed: R203.2, STAR_16.2
unnamed: R202.2, STAR_16.3
unnamed: R201.2, STAR_16.4
unnamed: R200.2, STAR_16.5
unnamed: R216.2, STAR_20.5
unnamed: R217.2, STAR_20.4
unnamed: R218.2, STAR_20.3
unnamed: R219.2, STAR_20.2
unnamed: R212.2, STAR_19.5
unnamed: R213.2, STAR_19.4
unnamed: R214.2, STAR_19.3
unnamed: R215.2, STAR_19.2
unnamed: R208.2, STAR_18.5
unnamed: R209.2, STAR_18.4
unnamed: R210.2, STAR_18.3
unnamed: R211.2, STAR_18.2
unnamed: R204.2, STAR_17.5
unnamed: R205.2, STAR_17.4
unnamed: R206.2, STAR_17.3
unnamed: R207.2, STAR_17.2
unnamed: C97.1, D172.2, R75.1, R199.1, R282.2
unnamed: C98.1, D173.2, R76.1, R198.1, R283.2
unnamed: C99.1, D174.2, R77.1, R197.1, R284.2
unnamed: C100.1, D175.2, R78.1, R192.1, R285.2
unnamed: C108.1, D179.2, R82.1, R200.1, R289.2
unnamed: C107.1, D178.2, R81.1, R201.1, R288.2
unnamed: C106.1, D177.2, R80.1, R202.1, R287.2
unnamed: C105.1, D176.2, R79.1, R203.1, R286.2
unnamed: C93.1, D163.2, R53.1, R191.1, R274.2
unnamed: C94.1, D164.2, R66.1, R190.1, R275.2
unnamed: C95.1, D165.2, R69.1, R189.1, R276.2
unnamed: C96.1, D166.2, R70.1, R188.1, R277.2
unnamed: C104.1, D170.2, R74.1, R193.1, R281.2
unnamed: C103.1, D169.2, R73.1, R194.1, R280.2
unnamed: C102.1, D168.2, R72.1, R195.1, R279.2
unnamed: C101.1, D167.2, R71.1, R196.1, R278.2
unnamed: C109.1, D180.2, R87.1, R207.1, R290.2
unnamed: C110.1, D181.2, R88.1, R206.1, R291.2
unnamed: C111.1, D182.2, R89.1, R205.1, R292.2
unnamed: C112.1, D183.2, R90.1, R204.1, R293.2
unnamed: C116.1, D187.2, R94.1, R208.1, R297.2
unnamed: C115.1, D186.2, R93.1, R209.1, R296.2
unnamed: C114.1, D185.2, R92.1, R210.1, R295.2
unnamed: C113.1, D184.2, R91.1, R211.1, R294.2
unnamed: C117.1, D188.2, R95.1, R215.1, R298.2
unnamed: C118.1, D189.2, R96.1, R214.1, R299.2
unnamed: C119.1, D190.2, R97.1, R213.1, R300.2
unnamed: C120.1, D191.2, R98.1, R212.1, R301.2
unnamed: C124.1, D195.2, R102.1, R216.1, R305.2
unnamed: C123.1, D194.2, R101.1, R217.1, R304.2
unnamed: C122.1, D193.2, R100.1, R218.1, R303.2
unnamed: C121.1, D192.2, R99.1, R219.1, R302.2
unnamed: D86.A, R220.2
unnamed: D87.A, R221.2
unnamed: D88.A, R222.2
unnamed: D90.A, R223.2
unnamed: D89.A, R224.2
unnamed: D95.C, STAR_1.6
unnamed: D97.C, STAR_3.6
unnamed: D96.A, R55.2
unnamed: D96.C, STAR_2.6
unnamed: D100.A, R59.2
unnamed: D100.C, STAR_6.6
unnamed: D99.A, R58.2
unnamed: D99.C, STAR_5.6
unnamed: D110.A, R85.2
unnamed: D110.C, STAR_15.6
unnamed: D109.A, R84.2
unnamed: D109.C, STAR_14.6
unnamed: D105.A, R103.2
unnamed: D105.C, STAR_17.6
unnamed: D112.A, R104.2
unnamed: D112.C, STAR_18.6
unnamed: D113.A, R105.2
unnamed: D113.C, STAR_19.6
unnamed: D114.A, R106.2
unnamed: D114.C, STAR_20.6
unnamed: C45.1, D123.2, R11.1, R151.1, R234.2
unnamed: F1.1, F2.1, POWER_IN.4
unnamed: D198.A, R306.2, U1.3 (C)
unnamed: C126.1, MIDI_IN.1
unnamed: C127.1, MIDI_IN.2
unnamed: MIDI_IN.3, R306.1
unnamed: D198.C, MIDI_IN.4, U1.2 (A)
STAR_ENABLE: D171.2, ESTOP.1, ESTOP_2.1, R54.1, R55.1, R56.1, R57.1, R58.1, R59.1, R60.1, R61.1, R62.1, R63.1, R64.1, R65.1, R67.1, R83.1, R84.1, R85.1, R86.1, R103.1, R104.1, R105.1, R106.1, R225.2

Notes on the sheet:
i2c 0x20
i2c 0x21
i2c 0x22
i2c 0x23
i2c 0x24
i2c 0x25
i2c 0x26
i2c 0x27

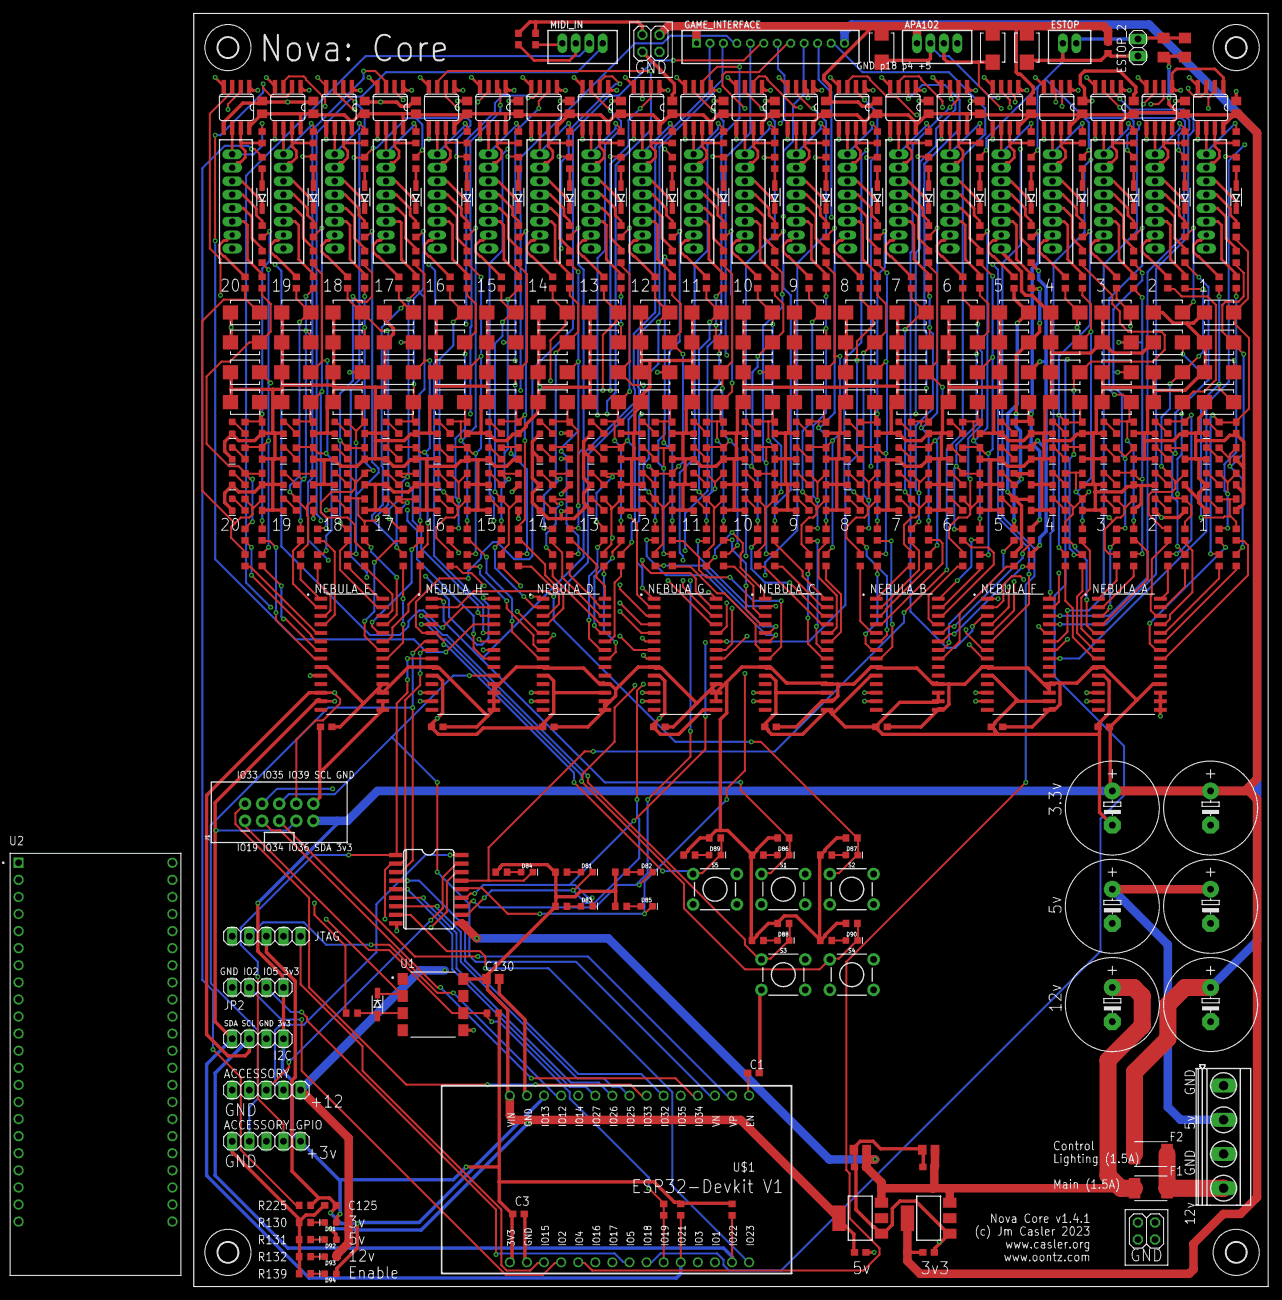
[picture p9: board nova core/hardware/core 2.0/core.brd from above]

Board: 4 copper layers, 159.7 x 189.2 mm, 711 parts (0 on the bottom side), 508 nets.
