mc-hamster/nova-core/nova star/hardware/star/starbase v01/star.brd

## EAGLE design nova star/hardware/star/starbase v01/star.brd (2025-03-02, an earlier design)

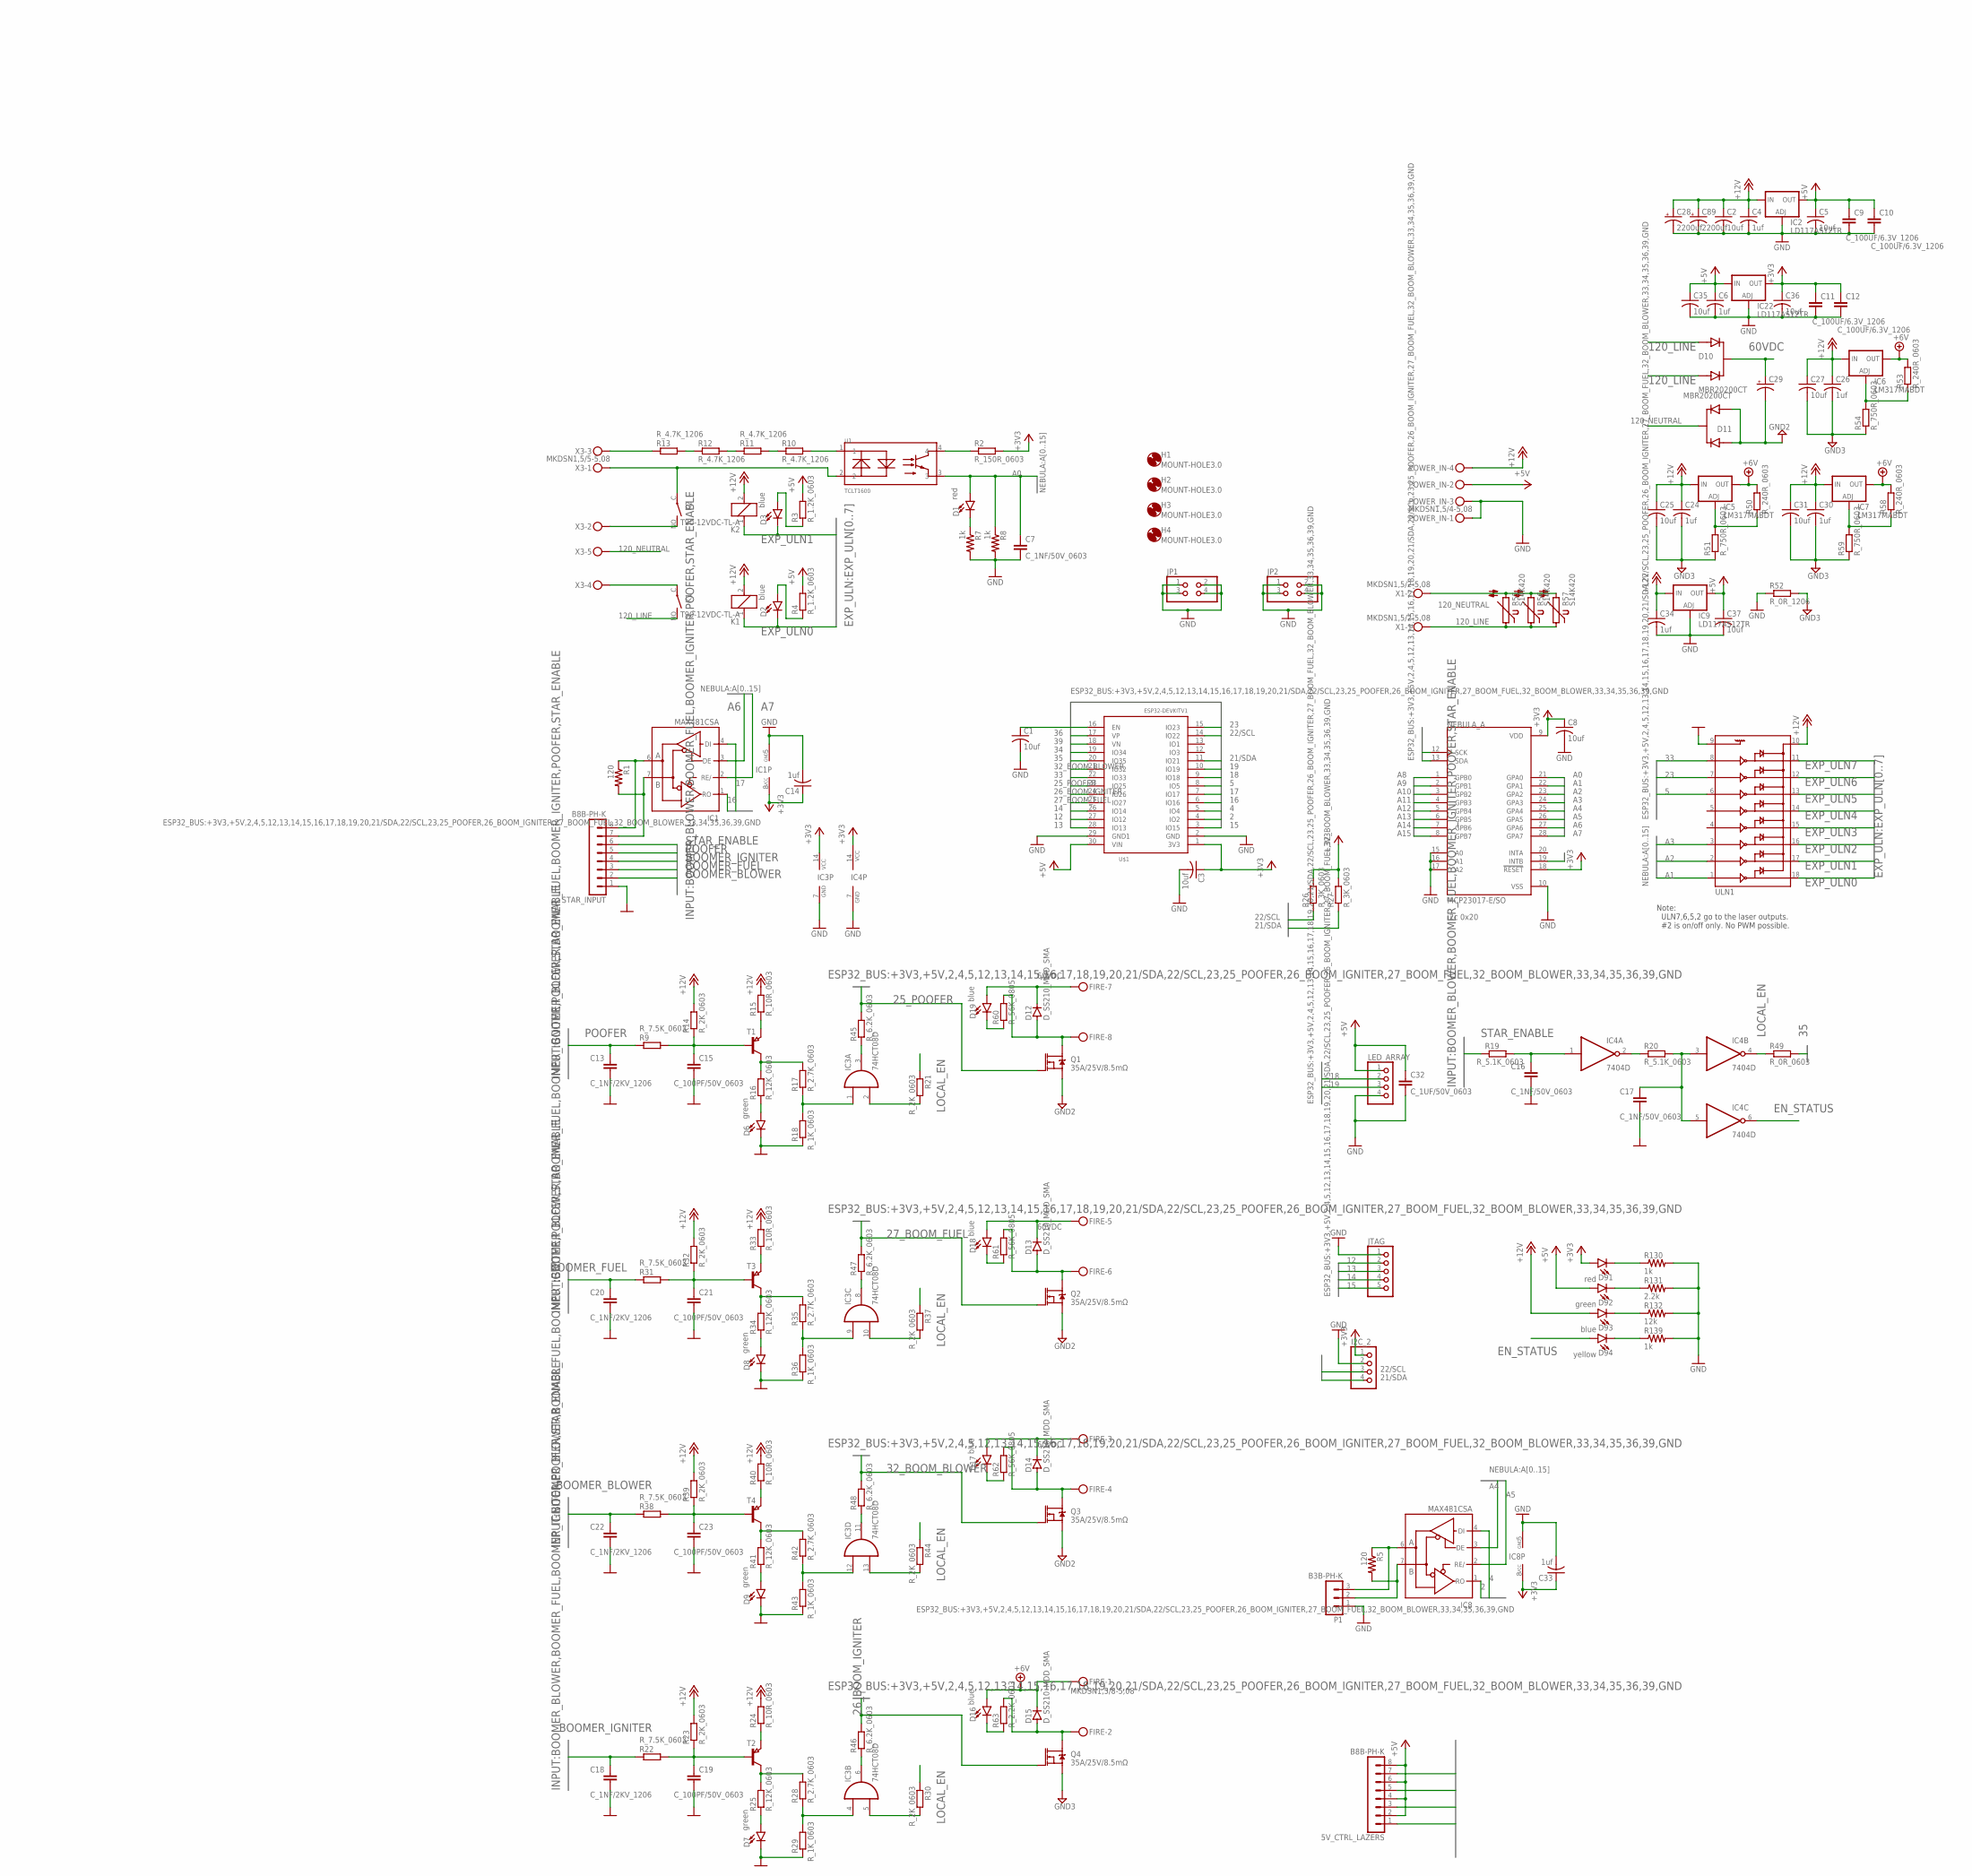
[picture p10: schematic star.sch]

Parts:
5V_CTRL_LAZERS: B8B-PH-K
C1, C2, C3, C5, C8, C25, C27, C31, C35, C36, C37: 10uf; C0603; LCSC_PART C19702
C4, C6, C14, C24, C26, C30, C33, C34: 1uf; C0805; LCSC_PART C15849
C7, C16, C17: C_1NF/50V_0603; C0603
C9, C10, C11, C12: C_100UF/6.3V_1206; C1206
C13, C18, C20, C22: C_1NF/2KV_1206; C1206
C15, C19, C21, C23: C_100PF/50V_0603; C0603
C28, C89: 2200uf; E5-13
C29: CPOL-USE10-25; EB25D
C32: C_1UF/50V_0603; C0603
D1, D91: red; LED-0603; JLC_ROTATION 180
D2, D3, D16, D17, D18, D19, D93: blue; LED-0603; JLC_ROTATION 180
D6, D7, D8, D9, D92: green; LED-0603; JLC_ROTATION 180
D10, D11: MBR20200CT; TO254P1050X476X2020-3
D12, D13, D14, D15: D_SS210_MDD_SMA; DO-214AC
D94: yellow; LED-0603; JLC_ROTATION 180
FIRE: MKDSN1,5/8-5,08
H1, H2, H3, H4: MOUNT-HOLE3.0; 3,0
I2C_2: PINHD-1X4; 1X04
IC1, IC8: MAX481CSA; SO08; LCSC_PART C8963
IC2, IC9: LD117AS12TR; SOT223; LCSC_PART C6187
IC3: 74HCT08D; SO14; LCSC_PART C5593
IC4: 7404D; SO14; LCSC_PART C5590
IC5, IC6, IC7: LM317MABDT; DPACK; LCSC_PART C75510
IC22: LD117AS12TR; SOT223; LCSC_PART C347222
JP1, JP2: PINHD-2X2; 2X02
JTAG: PINHD-1X5; 1X05
K1, K2: T90-12VDC-TL-A; JT1A-PCB
LED_ARRAY: PINHD-1X4; 1X04
NEBULA_A: MCP23017-E/SO; SOIC127P1030X265-28N; LCSC_PART C629440
P1: B3B-PH-K
POWER_IN: MKDSN1,5/4-5,08
Q1, Q2, Q3, Q4: 35A/25V/8.5mΩ; DPAK; LCSC_PART C2995335
R1, R5: 120; R0603; LCSC_PART C22787
R2: R_150R_0603; R0603
R3, R4: R_1.2K_0603; R0603
R7, R8, R130, R139: 1k; R0603; LCSC_PART C21190
R9, R22, R31, R38: R_7.5K_0603; R0603
R10, R11, R12, R13: R_4.7K_1206; R1206
R14, R21, R23, R30, R32, R37, R39, R44: R_2K_0603; R0603
R15, R24, R33, R40: R_10R_0603; R0603
R16, R25, R34, R41: R_12K_0603; R0603
R17, R28, R35, R42: R_2.7K_0603; R0603
R18, R29, R36, R43: R_1K_0603; R0603
R19, R20: R_5.1K_0603; R0603
R26, R27: R_3K_0603; R0603
R45, R46, R47, R48: R_6.2K_0603; R0603
R49: R_0R_0603; R0603
R50, R53, R58: R_240R_0603; R0603
R51, R54, R59: R_750R_0603; R0603
R52: R_0R_1206; R1206
R55, R56, R57: S14K420
R60, R61, R62: R_56K_0805; R0805
R63: R_2.2K_0603; R0603
R131: 2.2k; R0603; LCSC_PART C4190
R132: 12k; R0603; LCSC_PART C22790
STAR_INPUT: B8B-PH-K
T1, T2, T3, T4: T_PNP_MMBT5401_CHANGJ_SOT23-BEC; SOT23
U1: TCLT1600; SOP254P1015X230-4N; LCSC_PART C553998
U$1: ESP32DEVKITV1; ESP32-DEVKITV1
ULN1: ULN2803SOICW; SO18L; LCSC_PART C9683
X1: MKDSN1,5/2-5,08
X3: MKDSN1,5/5-5,08

Connections:
2: IC8.1 (RO), U$1.4 (IO2)
4: IC8.4 (DI), U$1.5 (IO4)
5: U$1.8 (IO5), ULN1.6
12: JTAG.2, U$1.27 (IO12)
13: JTAG.3, U$1.28 (IO13)
14: JTAG.4, U$1.26 (IO14)
15: JTAG.5, U$1.3 (IO15)
16: IC1.1 (RO), U$1.6 (IO16)
17: IC1.4 (DI), U$1.7 (IO17)
18: LED_ARRAY.2, U$1.9 (IO18)
19: LED_ARRAY.3, U$1.10 (IO19)
21/SDA: I2C_2.4, NEBULA_A.13 (SDA), R27.1, U$1.11 (IO21)
22/SCL: I2C_2.3, NEBULA_A.12 (SCK), R26.1, U$1.14 (IO22)
23: U$1.15 (IO23), ULN1.7
25_POOFER: Q1.1 (G), R45.2, U$1.23 (IO25)
26_BOOM_IGNITER: Q4.1 (G), R46.2, U$1.24 (IO26)
27_BOOM_FUEL: Q2.1 (G), R47.2, U$1.25 (IO27)
32_BOOM_BLOWER: Q3.1 (G), R48.2, U$1.21 (IO32)
33: U$1.22 (IO33), ULN1.8
34: NEBULA_A.19 (INTB), U$1.19 (IO34)
35: R49.2, U$1.20 (IO35)
36: U$1.17 (VP)
39: U$1.18 (VN)
60VDC: C29.+, D10.2 (C), D12.C, D13.C, D14.C, D17.A, D18.A, D19.A, FIRE.3, FIRE.5, FIRE.7
120_LINE: D10.1 (A1), D10.3 (A2), K1.NO (S), R55.1, R56.1, R57.1, X1.1
120_NEUTRAL: D11.2 (C), R55.2, R56.2, R57.2, X1.2, X3.5
+3V3: C3.1, C8.1, C11.1, C12.1, C14.1, C33.1, C36.1, D91.A, I2C_2.1, IC1.8 (VCC), IC3.14 (VCC), IC4.14 (VCC), IC8.8 (VCC), IC22.4 (OUT), NEBULA_A.9 (VDD), NEBULA_A.18 (!RESET), R2.2, R26.2, R27.2, U$1.1 (3V3)
+5V: 5V_CTRL_LAZERS.2, 5V_CTRL_LAZERS.4, 5V_CTRL_LAZERS.6, 5V_CTRL_LAZERS.8, C5.1, C6.1, C9.1, C10.1, C32.1, C35.1, C37.1, D92.A, IC2.4 (OUT), IC9.4 (OUT), IC22.3 (IN), LED_ARRAY.1, POWER_IN.2, R3.2, R4.2, U$1.30 (VIN)
+6V: D15.C, D16.A, FIRE.1, IC5.4 (OUT), IC6.4 (OUT), IC7.4 (OUT), R50.2, R53.2, R58.2
+12V: C2.1, C4.1, C24.1, C25.1, C26.1, C27.1, C28.+, C30.1, C31.1, C34.1, C89.+, D93.A, IC2.3 (IN), IC5.3 (IN), IC6.3 (IN), IC7.3 (IN), IC9.3 (IN), K1.2, K2.2, POWER_IN.4, R14.2, R15.2, R23.2, R24.2, R32.2, R33.2, R39.2, R40.2, ULN1.10
A0: C7.1, D1.A, NEBULA_A.21 (GPA0), R8.1, U1.3
A1: NEBULA_A.22 (GPA1), ULN1.1
A2: NEBULA_A.23 (GPA2), ULN1.2
A3: NEBULA_A.24 (GPA3), ULN1.3
A4: IC8.3 (DE), NEBULA_A.25 (GPA4)
A5: IC8.2 (RE/), NEBULA_A.26 (GPA5)
A6: IC1.3 (DE), NEBULA_A.27 (GPA6)
A7: IC1.2 (RE/), NEBULA_A.28 (GPA7)
A8: NEBULA_A.1 (GPB0)
A9: NEBULA_A.2 (GPB1)
A10: NEBULA_A.3 (GPB2)
A11: NEBULA_A.4 (GPB3)
A12: NEBULA_A.5 (GPB4)
A13: NEBULA_A.6 (GPB5)
A14: NEBULA_A.7 (GPB6)
A15: NEBULA_A.8 (GPB7)
BOOMER_BLOWER: C22.1, R38.1, STAR_INPUT.2
BOOMER_FUEL: C20.1, R31.1, STAR_INPUT.3
BOOMER_IGNITER: C18.1, R22.1, STAR_INPUT.4
EN_STATUS: D94.A, IC4.6 (O)
EXP_ULN0: D2.C, K1.1, ULN1.18
EXP_ULN1: D3.C, K2.1, ULN1.17
EXP_ULN2: 5V_CTRL_LAZERS.7, ULN1.16
EXP_ULN3: ULN1.15
EXP_ULN4: ULN1.14
EXP_ULN5: 5V_CTRL_LAZERS.5, ULN1.13
EXP_ULN6: 5V_CTRL_LAZERS.3, ULN1.12
EXP_ULN7: 5V_CTRL_LAZERS.1, ULN1.11
GND: C1.2, C2.2, C3.2, C4.2, C5.2, C6.2, C7.2, C8.2, C9.2, C10.2, C11.2, C12.2, C13.2, C14.2, C15.2, C16.2, C17.2, C18.2, C19.2, C20.2, C21.2, C22.2, C23.2, C28.-, C32.2, C33.2, C34.2, C35.2, C36.2, C37.2, C89.-, D6.C, D7.C, D8.C, D9.C, I2C_2.2, IC1.5 (GND), IC2.1 (ADJ), IC3.7 (GND), IC4.7 (GND), IC8.5 (GND), IC9.1 (ADJ), IC22.1 (ADJ), JP1.1, JP1.2, JP1.3, JP1.4, JP2.1, JP2.2, JP2.3, JP2.4, JTAG.1, LED_ARRAY.4, NEBULA_A.10 (VSS), NEBULA_A.15 (A0), NEBULA_A.16 (A1), NEBULA_A.17 (A2), P1.1, POWER_IN.1, POWER_IN.3, R7.2, R8.2, R18.1, R29.1, R36.1, R43.1, R52.1, R130.2, R131.2, R132.2, R139.2, STAR_INPUT.1, U$1.2 (GND), U$1.29 (GND1), ULN1.9
GND2: C29.-, D11.1 (A1), D11.3 (A2), Q1.3 (S), Q2.3 (S), Q3.3 (S)
GND3: C24.2, C25.2, C26.2, C27.2, C30.2, C31.2, Q4.3 (S), R51.1, R52.2, R54.1, R59.1
LOCAL_EN: IC4.4 (O), R21.1, R30.1, R37.1, R44.1, R49.1
unnamed: C1.1, U$1.16 (EN)
unnamed: R2.1, U1.4
unnamed: D2.A, R4.1
unnamed: D3.A, R3.1
unnamed: IC8.7 (B), P1.2, R5.2
unnamed: IC8.6 (A), P1.3, R5.1
unnamed: R13.1, X3.3
unnamed: R12.1, R13.2
unnamed: R11.1, R12.2
unnamed: R10.1, R11.2
unnamed: R10.2, U1.1
unnamed: D1.C, R7.1
unnamed: K2.NO (S), X3.2
unnamed: K1.C, X3.4
unnamed: K2.C, U1.2, X3.1
unnamed: R16.2, R17.2, T1.3 (C)
unnamed: C15.1, R9.2, R14.1, T1.1 (B)
unnamed: D6.A, R16.1
unnamed: IC3.1 (I0), R17.1, R18.2
unnamed: R15.1, T1.2 (E)
unnamed: IC4.2 (O), R20.1
unnamed: C17.1, IC4.3 (I), IC4.5 (I), R20.2
unnamed: C16.1, IC4.1 (I), R19.2
unnamed: IC3.2 (I1), R21.2
unnamed: C19.1, R22.2, R23.1, T2.1 (B)
unnamed: R25.2, R28.2, T2.3 (C)
unnamed: D7.A, R25.1
unnamed: IC3.4 (I0), R28.1, R29.2
unnamed: R24.1, T2.2 (E)
unnamed: IC3.5 (I1), R30.2
unnamed: C21.1, R31.2, R32.1, T3.1 (B)
unnamed: R34.2, R35.2, T3.3 (C)
unnamed: D8.A, R34.1
unnamed: IC3.9 (I0), R35.1, R36.2
unnamed: R33.1, T3.2 (E)
unnamed: IC3.10 (I1), R37.2
unnamed: C23.1, R38.2, R39.1, T4.1 (B)
unnamed: R41.2, R42.2, T4.3 (C)
unnamed: D9.A, R41.1
unnamed: IC3.12 (I0), R42.1, R43.2
unnamed: R40.1, T4.2 (E)
unnamed: IC3.13 (I1), R44.2
unnamed: IC3.3 (O), R45.1
unnamed: IC3.6 (O), R46.1
unnamed: IC3.8 (O), R47.1
unnamed: IC3.11 (O), R48.1
unnamed: D13.A, FIRE.6, Q2.4 (D), R61.2
unnamed: IC6.1 (ADJ), R53.1, R54.2
unnamed: D12.A, FIRE.8, Q1.4 (D), R60.2
unnamed: IC5.1 (ADJ), R50.1, R51.2
unnamed: D14.A, FIRE.4, Q3.4 (D), R62.2
unnamed: D15.A, FIRE.2, Q4.4 (D), R63.2
unnamed: IC7.1 (ADJ), R58.1, R59.2
unnamed: D16.C, R63.1
unnamed: D17.C, R62.1
unnamed: D18.C, R61.1
unnamed: D19.C, R60.1
unnamed: IC1.7 (B), R1.2, STAR_INPUT.7
unnamed: IC1.6 (A), R1.1, STAR_INPUT.8
unnamed: D91.C, R130.1
unnamed: D92.C, R131.1
unnamed: D93.C, R132.1
unnamed: D94.C, R139.1
POOFER: C13.1, R9.1, STAR_INPUT.5
STAR_ENABLE: R19.1, STAR_INPUT.6

Notes on the sheet:
i2c 0x20
Note: ULN7,6,5,2 go to the laser outputs. #2 is on/off only. No PWM possible.

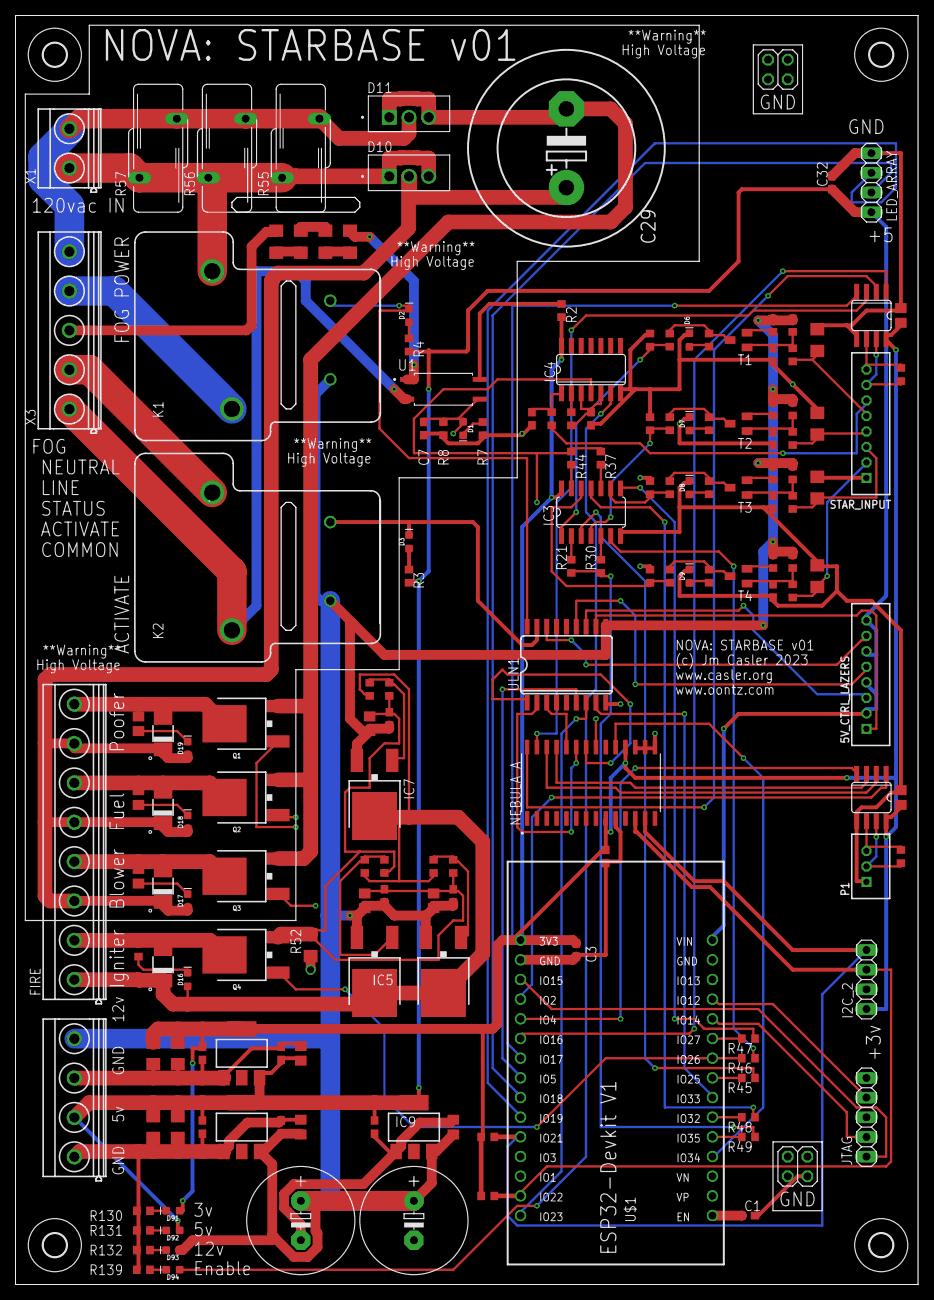
[picture p11: board star.brd from above]

Board: 4 copper layers, 116.5 x 163.8 mm, 165 parts (0 on the bottom side), 115 nets.
