mc-hamster/nova-core/nova core/src/output/Star.cpp

#include <Arduino.h>
#include "Star.h"
#include "configuration.h"
#include "NovaIO.h"
#include "Enable.h"
//#include "modes/Buttons.h"

Star *star = NULL;

Star::Star()
{

    // Setup the stars
    setupStar();
}

/*
    Setup the mapping between stars and the outputs that control the star.
    Note: We assume all devices are on the same GPIO Expansion chip.
*/
void Star::setupStar(void)
{
    #if DEBUG_STARS_ENABLED
    Serial.println("Setting up stars");
    #endif

    for (uint32_t i = 0; i < 20; i++)
    {
        cluster.stars[i].starState.boomerButtonState = BOOMER_IDLE;
        cluster.stars[i].pooferOutputState = 0;
        cluster.stars[i].pooferOutputState = 0;
        cluster.stars[i].boomer.outputState = BOOMER_READY;
        cluster.stars[i].boomer.previousMillis = 0;
        cluster.stars[i].boomer.abort = false;
        cluster.stars[i].net.cache_re = 0;
        cluster.stars[i].net.cache_de = 0;
        cluster.stars[i].disableBoomer = false;
        cluster.stars[i].disablePoofer = false;
        
        // Load fog enabled setting from preferences
        char prefKey[16];
        snprintf(prefKey, sizeof(prefKey), "star%d_fog", i);
        cluster.stars[i].fogEnabled = PreferencesManager::getBool(prefKey, false);
    }

    cluster.stars[0].expander = 0;
    cluster.stars[0].blowerOutput = 0;
    cluster.stars[0].fuelOutput = 1;
    cluster.stars[0].igniterOutput = 2;
    cluster.stars[0].pooferOutput = 3;
    cluster.stars[0].blowerOutputDuty = 255;
    cluster.stars[0].net.expander = 5;
    cluster.stars[0].net.re = 0;
    cluster.stars[0].net.de = 1;

    cluster.stars[1].expander = 0;
    cluster.stars[1].blowerOutput = 4;
    cluster.stars[1].fuelOutput = 5;
    cluster.stars[1].igniterOutput = 6;
    cluster.stars[1].pooferOutput = 7;
    cluster.stars[1].blowerOutputDuty = 255;
    cluster.stars[1].net.expander = 5;
    cluster.stars[1].net.re = 2;
    cluster.stars[1].net.de = 3;

    cluster.stars[2].expander = 0;
    cluster.stars[2].blowerOutput = 8;
    cluster.stars[2].fuelOutput = 9;
    cluster.stars[2].igniterOutput = 10;
    cluster.stars[2].pooferOutput = 11;
    cluster.stars[2].blowerOutputDuty = 255;
    cluster.stars[2].net.expander = 5;
    cluster.stars[2].net.re = 4;
    cluster.stars[2].net.de = 5;

    cluster.stars[3].expander = 0;
    cluster.stars[3].blowerOutput = 12;
    cluster.stars[3].fuelOutput = 13;
    cluster.stars[3].igniterOutput = 14;
    cluster.stars[3].pooferOutput = 15;
    cluster.stars[3].blowerOutputDuty = 255;
    cluster.stars[3].net.expander = 5;
    cluster.stars[3].net.re = 6;
    cluster.stars[3].net.de = 7;

    cluster.stars[4].expander = 1;
    cluster.stars[4].blowerOutput = 0;
    cluster.stars[4].fuelOutput = 1;
    cluster.stars[4].igniterOutput = 2;
    cluster.stars[4].pooferOutput = 3;
    cluster.stars[4].blowerOutputDuty = 255;
    cluster.stars[4].net.expander = 5;
    cluster.stars[4].net.re = 8;
    cluster.stars[4].net.de = 9;

    cluster.stars[5].expander = 1;
    cluster.stars[5].blowerOutput = 4;
    cluster.stars[5].fuelOutput = 5;
    cluster.stars[5].igniterOutput = 6;
    cluster.stars[5].pooferOutput = 7;
    cluster.stars[5].blowerOutputDuty = 255;
    cluster.stars[5].net.expander = 5;
    cluster.stars[5].net.re = 10;
    cluster.stars[5].net.de = 11;

    cluster.stars[6].expander = 1;
    cluster.stars[6].blowerOutput = 8;
    cluster.stars[6].fuelOutput = 9;
    cluster.stars[6].igniterOutput = 10;
    cluster.stars[6].pooferOutput = 11;
    cluster.stars[6].blowerOutputDuty = 255;
    cluster.stars[6].net.expander = 5;
    cluster.stars[6].net.re = 12;
    cluster.stars[6].net.de = 13;

    cluster.stars[7].expander = 1;
    cluster.stars[7].blowerOutput = 12;
    cluster.stars[7].fuelOutput = 13;
    cluster.stars[7].igniterOutput = 14;
    cluster.stars[7].pooferOutput = 15;
    cluster.stars[7].blowerOutputDuty = 255;
    cluster.stars[7].net.expander = 5;
    cluster.stars[7].net.re = 14;
    cluster.stars[7].net.de = 15;

    cluster.stars[8].expander = 2;
    cluster.stars[8].blowerOutput = 0;
    cluster.stars[8].fuelOutput = 1;
    cluster.stars[8].igniterOutput = 2;
    cluster.stars[8].pooferOutput = 3;
    cluster.stars[8].blowerOutputDuty = 255;
    cluster.stars[8].net.expander = 6;
    cluster.stars[8].net.re = 0;
    cluster.stars[8].net.de = 1;

    cluster.stars[9].expander = 2;
    cluster.stars[9].blowerOutput = 4;
    cluster.stars[9].fuelOutput = 5;
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
    if (enable->isSystemEnabled())
    {
        star_loop();
    }
    else
    {
        #if DEBUG_STARS_ENABLED
        Serial.println("system disabled");
        #endif
        delay(1000);
    }
}

// Called by the modes task
void Star::star_loop(void)
{

    for (uint32_t outputStar = 0; outputStar < 20; outputStar++)
    {
        
        // Important to yield here to allow other tasks to run.
        //  Especially important to ensure the ambient task runs.
        yield();

        if (cluster.stars[outputStar].starState.pooferButtonState == POOFER_POOF)
        {
            if (goPoof(outputStar, pooferDuration, pooferDuration / 4))
            {
                cluster.stars[outputStar].starState.pooferButtonState = POOFER_OFF;
            }
        }
        if (cluster.stars[outputStar].starState.boomerButtonState == BOOMER_ON)
        {
            if (goBoom(outputStar))
            {
                #if DEBUG_STARS_ENABLED
                Serial.println("Setting: BOOMER_OFF - Turning off boomer");
                #endif
                cluster.stars[outputStar].starState.boomerButtonState = BOOMER_IDLE;
            }
        }
    }
}



/**
 * Triggers a controlled boom of the specified star.
 *
 * @param star The index of the star to trigger the boom for.
 *
 * @return true if the boom is triggered successfully, false otherwise.
 */
bool Star::goBoom(uint8_t star)
{
    #if DEBUG_STARS_ENABLED
    Serial.printf("Triggering boom for star %d\n", star);
    #endif

    if (cluster.stars[star].disableBoomer)
    {
        #if DEBUG_STARS_ENABLED
        Serial.print("Star - ");
        Serial.print(star);
        Serial.println(" - Boomer is disabled.");
        #endif
        return 1;
    }

    uint32_t currentMillis = millis();
    if (cluster.stars[star].boomer.outputState == BOOMER_ABORT)
    {
        #if DEBUG_STARS_ENABLED
        Serial.print("Star - ");
        Serial.print(star);
        Serial.print(" - ");

        Serial.print("Current state - ");
        Serial.println(cluster.stars[star].boomer.outputState);
        Serial.println("BOOMER_ABORT RECEIVED");
        #endif
        novaIO->mcp_digitalWrite(cluster.stars[star].blowerOutput, HIGH, cluster.stars[star].expander);
        novaIO->mcp_digitalWrite(cluster.stars[star].fuelOutput, LOW, cluster.stars[star].expander);
        novaIO->mcp_digitalWrite(cluster.stars[star].pooferOutput, LOW, cluster.stars[star].expander);

        cluster.stars[star].boomer.outputState = BOOMER_BLOWER_EXHAUST;
        cluster.stars[star].boomer.abort = false;
    }
    else if (cluster.stars[star].boomer.outputState == BOOMER_READY)
    {
        if (cluster.stars[star].boomer.abort)
        {
            #if DEBUG_STARS_ENABLED
            Serial.println("In BOOMER_READY, entering BOOMER_ABORT");
            #endif
            cluster.stars[star].boomer.outputState = BOOMER_ABORT;
        }
        else
        {
            cluster.stars[star].boomer.previousMillis = millis();
            #if DEBUG_STARS_ENABLED
            Serial.print("Star - ");
            Serial.print(star);
            Serial.print(" - ");
            Serial.println("BOOMER_READY");
            #endif
            // Serial.println(millis());
            cluster.stars[star].boomer.outputState = BOOMER_BLOWER_ON;
        }
    }
    else if (cluster.stars[star].boomer.outputState == BOOMER_BLOWER_ON)
    {
        if (cluster.stars[star].boomer.abort)
        {
            #if DEBUG_STARS_ENABLED
            Serial.println("In BOOMER_BLOWER_ON, entering BOOMER_ABORT");
            #endif
            cluster.stars[star].boomer.outputState = BOOMER_ABORT;
        }
        else
        {

            cluster.stars[star].boomer.previousMillis = millis();
            #if DEBUG_STARS_ENABLED
            Serial.print("Star - ");
            Serial.print(star);
            Serial.print(" - ");
            Serial.println("BOOMER_BLOWER_ON");
            #endif

            novaIO->mcp_digitalWrite(cluster.stars[star].blowerOutput, HIGH, cluster.stars[star].expander);
            cluster.stars[star].boomer.outputState = BOOMER_BLOWER_ON_IDLE;
        }
    }
    else if (cluster.stars[star].boomer.outputState == BOOMER_BLOWER_ON_IDLE)
    {
        if (cluster.stars[star].boomer.abort)
        {
            #if DEBUG_STARS_ENABLED
            Serial.println("In BOOMER_BLOWER_ON_IDLE, entering BOOMER_ABORT");
            #endif
            cluster.stars[star].boomer.outputState = BOOMER_ABORT;
        }
        else
        {
            if (currentMillis - cluster.stars[star].boomer.previousMillis >= boomerTimeBlowerOn)
            {
                cluster.stars[star].boomer.previousMillis = millis();
                #if DEBUG_STARS_ENABLED
                Serial.print("Star - ");
                Serial.print(star);
                Serial.print(" - ");
                Serial.println("BOOMER_BLOWER_ON_IDLE");
                #endif
                // Serial.println(currentMillis - cluster.stars[star].boomer.previousMillis);
                cluster.stars[star].boomer.outputState = BOOMER_BLOWER_ON_FUEL_ON;
            }
        }
    }
    else if (cluster.stars[star].boomer.outputState == BOOMER_BLOWER_ON_FUEL_ON)
    {
        if (cluster.stars[star].boomer.abort)
        {
            #if DEBUG_STARS_ENABLED
            Serial.println("In BOOMER_BLOWER_ON_FUEL_ON, entering BOOMER_ABORT");
            #endif
            cluster.stars[star].boomer.outputState = BOOMER_ABORT;
        }
        else
        {

            cluster.stars[star].boomer.previousMillis = millis();
            #if DEBUG_STARS_ENABLED
            Serial.print("Star - ");
            Serial.print(star);
            Serial.print(" - ");
            Serial.println("BOOMER_BLOWER_ON_FUEL_ON");
            #endif

            novaIO->mcp_digitalWrite(cluster.stars[star].blowerOutput, HIGH, cluster.stars[star].expander);
            novaIO->mcp_digitalWrite(cluster.stars[star].fuelOutput, HIGH, cluster.stars[star].expander);
            cluster.stars[star].boomer.outputState = BOOMER_BLOWER_ON_FUEL_ON_IDLE;
        }
    }
    else if (cluster.stars[star].boomer.outputState == BOOMER_BLOWER_ON_FUEL_ON_IDLE)
    {
        if (cluster.stars[star].boomer.abort)
        {
            #if DEBUG_STARS_ENABLED
            Serial.println("In BOOMER_BLOWER_ON_FUEL_ON_IDLE, entering BOOMER_ABORT");
            #endif
            cluster.stars[star].boomer.outputState = BOOMER_ABORT;
        }
        else
        {

            if (currentMillis - cluster.stars[star].boomer.previousMillis >= boomerTimeFuelOn)
            {
                cluster.stars[star].boomer.previousMillis = millis();
                #if DEBUG_STARS_ENABLED
                Serial.print("Star - ");
                Serial.print(star);
                Serial.print(" - ");
                Serial.println("BOOMER_BLOWER_ON_FUEL_ON_IDLE");
                #endif
                cluster.stars[star].boomer.outputState = BOOMER_BLOWER_ON_FUEL_OFF;
            }
        }
    }
    else if (cluster.stars[star].boomer.outputState == BOOMER_BLOWER_ON_FUEL_OFF)
    {
        if (cluster.stars[star].boomer.abort)
        {
            #if DEBUG_STARS_ENABLED
            Serial.println("In BOOMER_BLOWER_ON_FUEL_OFF, entering BOOMER_ABORT");
            #endif
            cluster.stars[star].boomer.outputState = BOOMER_ABORT;
        }
        else
        {

            cluster.stars[star].boomer.previousMillis = millis();
            #if DEBUG_STARS_ENABLED
            Serial.print("Star - ");
            Serial.print(star);
            Serial.print(" - ");
            Serial.println("BOOMER_BLOWER_ON_FUEL_OFF");
            #endif

            novaIO->mcp_digitalWrite(cluster.stars[star].fuelOutput, LOW, cluster.stars[star].expander);
            novaIO->mcp_digitalWrite(cluster.stars[star].pooferOutput, HIGH, cluster.stars[star].expander);

            cluster.stars[star].boomer.outputState = BOOMER_BLOWER_ON_FUEL_OFF_IDLE;
        }
    }
    else if (cluster.stars[star].boomer.outputState == BOOMER_BLOWER_ON_FUEL_OFF_IDLE)
    {
        if (cluster.stars[star].boomer.abort)
        {
            #if DEBUG_STARS_ENABLED
            Serial.println("In BOOMER_BLOWER_ON_FUEL_OFF_IDLE, entering BOOMER_ABORT");
            #endif
            cluster.stars[star].boomer.outputState = BOOMER_ABORT;
        }
        else
        {

            if (currentMillis - cluster.stars[star].boomer.previousMillis >= boomerTimeFuelOff)
            {
                cluster.stars[star].boomer.previousMillis = millis();
                #if DEBUG_STARS_ENABLED
                Serial.print("Star - ");
                Serial.print(star);
                Serial.print(" - ");
                Serial.println("BOOMER_BLOWER_ON_FUEL_OFF_IDLE");
                #endif
                cluster.stars[star].boomer.outputState = BOOMER_BLOWER_OFF;
            }
        }
    }
    else if (cluster.stars[star].boomer.outputState == BOOMER_BLOWER_OFF)
    {
        if (cluster.stars[star].boomer.abort)
        {
            #if DEBUG_STARS_ENABLED
            Serial.println("In BOOMER_BLOWER_OFF, entering BOOMER_ABORT");
            #endif
            cluster.stars[star].boomer.outputState = BOOMER_ABORT;
        }
        else
        {

            cluster.stars[star].boomer.previousMillis = millis();
            #if DEBUG_STARS_ENABLED
            Serial.print("Star - ");
            Serial.print(star);
            Serial.print(" - ");
            Serial.println("BOOMER_BLOWER_OFF");
            #endif
            novaIO->mcp_digitalWrite(cluster.stars[star].blowerOutput, LOW, cluster.stars[star].expander);

            cluster.stars[star].boomer.outputState = BOOMER_BLOWER_OFF_IDLE;
        }
    }
    else if (cluster.stars[star].boomer.outputState == BOOMER_BLOWER_OFF_IDLE)
    {
        if (cluster.stars[star].boomer.abort)
        {
            #if DEBUG_STARS_ENABLED
            Serial.println("In BOOMER_BLOWER_OFF_IDLE, entering BOOMER_ABORT");
            #endif
            cluster.stars[star].boomer.outputState = BOOMER_ABORT;
        }
        else
        {

            if (currentMillis - cluster.stars[star].boomer.previousMillis >= boomerTimeBomerBlowerOff)
            {
                cluster.stars[star].boomer.previousMillis = millis();
                #if DEBUG_STARS_ENABLED
                Serial.print("Star - ");
                Serial.print(star);
                Serial.print(" - ");
                Serial.println("BOOMER_BLOWER_OFF_IDLE");
                #endif

                cluster.stars[star].boomer.outputState = BOOMER_ZAP_ON;
            }
        }
    }
    else if (cluster.stars[star].boomer.outputState == BOOMER_ZAP_ON)
    {
        if (cluster.stars[star].boomer.abort)
        {
            #if DEBUG_STARS_ENABLED
            Serial.println("In BOOMER_ZAP_ON, entering BOOMER_ABORT");
            #endif
            cluster.stars[star].boomer.outputState = BOOMER_ABORT;
        }
        else
        {

            if (star == 20) {
                #if DEBUG_STARS_ENABLED
                Serial.println("*** Star 20 - Virtual Star. ****");
                #endif
            }

            cluster.stars[star].boomer.previousMillis = millis();
            #if DEBUG_STARS_ENABLED
            Serial.print("Star - ");
            Serial.print(star);
            Serial.print(" - ");
            Serial.println("BOOMER_ZAP_ON");
            #endif

            novaIO->mcp_digitalWrite(cluster.stars[star].igniterOutput, HIGH, cluster.stars[star].expander);
            novaIO->mcp_digitalWrite(cluster.stars[star].pooferOutput, HIGH, cluster.stars[star].expander);
            cluster.stars[star].boomer.outputState = BOOMER_ZAP_ON_IDLE;
        }
    }
    else if (cluster.stars[star].boomer.outputState == BOOMER_ZAP_ON_IDLE)
    {
        if (cluster.stars[star].boomer.abort)
        {
            #if DEBUG_STARS_ENABLED
            Serial.println("In BOOMER_ZAP_ON_IDLE, entering BOOMER_ABORT");
            #endif
            cluster.stars[star].boomer.outputState = BOOMER_ABORT;
        }
        else
        {

            if (currentMillis - cluster.stars[star].boomer.previousMillis >= boomerTimeBomerZap)
            {
                cluster.stars[star].boomer.previousMillis = millis();
                #if DEBUG_STARS_ENABLED
                Serial.print("Star - ");
                Serial.print(star);
                Serial.print(" - ");
                Serial.println("BOOMER_ZAP_ON_IDLE");
                #endif
                cluster.stars[star].boomer.outputState = BOOMER_BLOWER_EXHAUST;
            }
        }
    }
    else if (cluster.stars[star].boomer.outputState == BOOMER_BLOWER_EXHAUST)
    {
        cluster.stars[star].boomer.previousMillis = millis();
        #if DEBUG_STARS_ENABLED
        Serial.print("Star - ");
        Serial.print(star);
        Serial.print(" - ");
        Serial.println("BOOMER_BLOWER_EXHAUST");
        #endif

        novaIO->mcp_digitalWrite(cluster.stars[star].blowerOutput, HIGH, cluster.stars[star].expander);
        novaIO->mcp_digitalWrite(cluster.stars[star].igniterOutput, LOW, cluster.stars[star].expander);
        novaIO->mcp_digitalWrite(cluster.stars[star].pooferOutput, LOW, cluster.stars[star].expander);

        cluster.stars[star].boomer.outputState = BOOMER_BLOWER_EXHAUST_IDLE;
    }
    else if (cluster.stars[star].boomer.outputState == BOOMER_BLOWER_EXHAUST_IDLE)
    {
        if (currentMillis - cluster.stars[star].boomer.previousMillis >= boomerTimeExhaust)
        {
            cluster.stars[star].boomer.previousMillis = millis();
            #if DEBUG_STARS_ENABLED
            Serial.print("Star - ");
            Serial.print(star);
            Serial.print(" - ");
            Serial.println("BOOMER_BLOWER_EXHAUST_IDLE");
            #endif

            cluster.stars[star].boomer.outputState = BOOMER_BLOWER_EXHAUST_OFF;
        }
    }
    else if (cluster.stars[star].boomer.outputState == BOOMER_BLOWER_EXHAUST_OFF)
    {
        novaIO->mcp_digitalWrite(cluster.stars[star].blowerOutput, LOW, cluster.stars[star].expander);
        #if DEBUG_STARS_ENABLED
        Serial.print("Star - ");
        Serial.print(star);
        Serial.print(" - ");
        Serial.println("BOOMER_BLOWER_EXHAUST_OFF");
        #endif

        cluster.stars[star].boomer.outputState = BOOMER_READY;

        // Serial.printf("Next state - %d\n", cluster.stars[star].boomer.outputState);

        // Setting abort to false after the boomer is done.
        if (cluster.stars[star].boomer.abort)
        {
            #if DEBUG_STARS_ENABLED
            Serial.println("Abort is True in BOOMER_BLOWER_EXHAUST_OFF.");
            #endif

            cluster.stars[star].boomer.abort = false;
        }

        // Boomer is done.
        return 1;
    }

    // Boomer is not done yet.
    return 0;
}

bool Star::goPoof(uint8_t star, uint32_t intervalOn, uint32_t intervalOff)
{
    #if DEBUG_STARS_ENABLED
    Serial.printf("Triggering poof for star %d (on: %d, off: %d)\n", star, intervalOn, intervalOff);
    #endif

    if (cluster.stars[star].disablePoofer)
    {
        #if DEBUG_STARS_ENABLED
        Serial.print("Star - ");
        Serial.print(star);
        Serial.println(" - Poofer is disabled.");
        #endif
        return 1;
    }

    uint32_t currentMillis = millis();
    // Serial.println("1");
    // Serial.print("goPoof called: ");
    // Serial.println(star);

    switch (cluster.stars[star].pooferOutputState)
    {
    case POOF_ON:
        // TODO Enable this
        //Serial.print("goPoof: On ");
        //Serial.print(star);
        //Serial.println();
        cluster.stars[star].pooferPreviousMillis = currentMillis;
        novaIO->mcp_digitalWrite(cluster.stars[star].pooferOutput, HIGH, cluster.stars[star].expander);
        cluster.stars[star].pooferOutputState = POOF_ON_IDLE;
        break;

    case POOF_ON_IDLE:
        if (currentMillis - cluster.stars[star].pooferPreviousMillis >= intervalOn)
        {
            cluster.stars[star].pooferOutputState = POOF_OFF;
        }
        break;

    case POOF_OFF:
        novaIO->mcp_digitalWrite(cluster.stars[star].pooferOutput, LOW, cluster.stars[star].expander);
        cluster.stars[star].pooferOutputState = POOF_OFF_IDLE;
        break;

    case POOF_OFF_IDLE:
        if (currentMillis - cluster.stars[star].pooferPreviousMillis >= intervalOn + intervalOff)
        {
            cluster.stars[star].pooferOutputState = POOF_ON;
            return 1;
        }
        break;

    default:
        break;
    }

    return 0; // We are not yet done with our task
}

/*
    Sets the output of the selected star to transmit.
    The other stars will be set to high impedience.

    If the star is 0xff, then sets all stars to transmit.

    RE - Receiver Output Enable Active LOW
    DE - Driver Output Enable Active HIGH

    From SP3485EN-L_TR.pdf:

    RE
        A logic LOW on RE (pin 2) will enable the differential receiver. A logic HIGH on RE
        (pin 2) of the SP3485 will disable the receiver.
    DE
        A logic HIGH on DE (pin 3) will enable the differential driver outputs. A logic LOW
        on the DE (pin 3) will tri-state the driver outputs.

*/
bool Star::netOut(uint8_t star)
{

    for (uint32_t i = 0; i < 20; i++)
    //for (uint32_t i = 0; i < 12; i++)
    {
        if (star == 0xff)
        {
            // Selected transceiver to output
            if (cluster.stars[i].net.cache_re == HIGH)
            {
                // If cache_re is already high, then we don't need ot do anything.
            }
            else
            {
                novaIO->mcp_digitalWrite(cluster.stars[i].net.re, HIGH, cluster.stars[i].net.expander);
                cluster.stars[i].net.cache_re = HIGH;
            }

            if (cluster.stars[i].net.cache_de == HIGH)
            {
                // If cache_de is already high, then we don't need ot do anything.
            }
            else
            {
                novaIO->mcp_digitalWrite(cluster.stars[i].net.de, HIGH, cluster.stars[i].net.expander);
                cluster.stars[i].net.cache_de = HIGH;
            }
        }
        else
        {

            if (star == i)
            {
                // *** Set RE to High and DE to High

                // Selected transceiver to output
                if (cluster.stars[i].net.cache_re == HIGH)
                {
                    // If cache_re is already high, then we don't need ot do anything.
                }
                else
                {
                    novaIO->mcp_digitalWrite(cluster.stars[i].net.re, HIGH, cluster.stars[i].net.expander);
                    cluster.stars[i].net.cache_re = HIGH;
                }

                if (cluster.stars[i].net.cache_de == HIGH)
                {
                    // If cache_de is already high, then we don't need ot do anything.
                }
                else
                {
                    novaIO->mcp_digitalWrite(cluster.stars[i].net.de, HIGH, cluster.stars[i].net.expander);
                    cluster.stars[i].net.cache_de = HIGH;
                }
            }
            else
            {
                // *** Set RE to High and DE Low

                // Everything else to high impediance
                // novaIO->mcp_digitalWrite(cluster.stars[i].net.re, HIGH, cluster.stars[i].net.expander);
                // novaIO->mcp_digitalWrite(cluster.stars[i].net.de, LOW, cluster.stars[i].net.expander);

                // Selected transceiver to output
                if (cluster.stars[i].net.cache_re == HIGH)
                {
                    // If cache_re is already high, then we don't need ot do anything.
                }
                else
                {
                    novaIO->mcp_digitalWrite(cluster.stars[i].net.re, HIGH, cluster.stars[i].net.expander);
                    cluster.stars[i].net.cache_re = HIGH;
                }

                if (cluster.stars[i].net.cache_de == HIGH)
                {
                    // If cache_de is high, then we don't need to set it low
                    novaIO->mcp_digitalWrite(cluster.stars[i].net.de, LOW, cluster.stars[i].net.expander);
                    cluster.stars[i].net.cache_de = LOW;
                }
                else
                {
                    // If cache_de is low, then we don't need to do anything
                }
            }
        }
    }
    return 1; // Success
}

void Star::poof(uint8_t star)
{
    if (star >= 20)
    {
        #if DEBUG_STARS_ENABLED
        Serial.println("Star::poof() - star is out of range");
        #endif
        return;
    }
    cluster.stars[star].starState.pooferButtonState = POOFER_POOF;
}

void Star::boom(uint8_t star)
{
    if (star >= 21)
    {
        #if DEBUG_STARS_ENABLED
        Serial.println("Star::boom() - star is out of range");
        #endif
        return;
    }
    cluster.stars[star].starState.boomerButtonState = BOOMER_ON;
    // cluster.stars[star].starState.pooferButtonState = POOFER_POOF;
}

void Star::manualPoof(uint8_t star, bool state)
{
    // Serial.println("manual pooooooof");
    novaIO->mcp_digitalWrite(cluster.stars[star].pooferOutput, state, cluster.stars[star].expander);
}

void Star::manualBlow(uint8_t star, bool state)
{
    novaIO->mcp_digitalWrite(cluster.stars[star].blowerOutput, state, cluster.stars[star].expander);
}

void Star::manualBlowFuel(uint8_t star, bool state)
{
    novaIO->mcp_digitalWrite(cluster.stars[star].blowerOutput, state, cluster.stars[star].expander);
    novaIO->mcp_digitalWrite(cluster.stars[star].fuelOutput, state, cluster.stars[star].expander);
}

void Star::manualFuel(uint8_t star, bool state)
{
    novaIO->mcp_digitalWrite(cluster.stars[star].fuelOutput, state, cluster.stars[star].expander);
}

void Star::manualZap(uint8_t star, bool state)
{
    novaIO->mcp_digitalWrite(cluster.stars[star].igniterOutput, state, cluster.stars[star].expander);
}

void Star::setFogEnabled(uint8_t star, bool enabled) {
    if (star >= 20) {
        #if DEBUG_STARS_ENABLED
        Serial.println("Star::setFogEnabled() - star is out of range");
        #endif
        return;
    }
    
    cluster.stars[star].fogEnabled = enabled;
    
    // Save to preferences
    char prefKey[16];
    snprintf(prefKey, sizeof(prefKey), "star%d_fog", star);
    PreferencesManager::setBool(prefKey, enabled);

    #if DEBUG_STARS_ENABLED
    Serial.printf("Star %d fog %s\n", star, enabled ? "enabled" : "disabled");
    #endif
}

bool Star::getFogEnabled(uint8_t star) {
    if (star >= 20) {
        #if DEBUG_STARS_ENABLED
        Serial.println("Star::getFogEnabled() - star is out of range");
        #endif
        return false;
    }
    
    // Get from preferences
    char prefKey[16];
    snprintf(prefKey, sizeof(prefKey), "star%d_fog", star);
    return PreferencesManager::getBool(prefKey, false);
}

uint32_t Star::whatBoomerFullTime()
{
    return (boomerTimeBlowerOn + boomerTimeFuelOn + boomerTimeFuelOff + boomerTimeBomerBlowerOff + boomerTimeBomerZap + boomerTimeExhaust);
}
