mc-hamster/nova-core/nova star/src/NovaNet.cpp

#include <Arduino.h>
#include "NovaNet.h"
#include "main.h"
#include "configuration.h"
#include "pb_arduino.h"
#include "NovaIO.h"
#include "DmxNet.h"
#include "globals.h"
#include "FogMachine.h"

#include "messaging.pb.h"

/*

This class is responsible for sending and receiving messages over the NovaNet protocol.

*/

NovaNet::NovaNet() : lastTime(0), count(0)
{
    // messaging_Request request = messaging_Request_init_zero;
    Serial.println("NovaNet setup started");

    // Serial2.begin(NOVANET_BAUD);

    // Set the NovaNet pins to receive
    novaIO->mcp_digitalWrite(NOVANET_RE, LOW, 0);
    novaIO->mcp_digitalWrite(NOVANET_DE, HIGH, 0);

    // Setup goes in here
}

bool NovaNet::readWithTimeout(uint8_t *buffer, size_t size, unsigned long timeout_ms)
{
    unsigned long startTime = millis();
    while (Serial2.available() < size)
    {
        if (millis() - startTime >= timeout_ms)
        {
            Serial.printf("Serial read timeout after %lu ms waiting for %d bytes\n", timeout_ms, size);
            return false;
        }
        vTaskDelay(pdMS_TO_TICKS(1));
    }
    size_t bytesRead = Serial2.readBytes((char *)buffer, size);
    return bytesRead == size;
}

void NovaNet::loop()
{
    unsigned long currentTime = millis();
    unsigned long elapsedTime = currentTime - lastTime;
    uint16_t msg_size = 0;

    // Prepare the header: F0 9F 92 A5 aka "fire" emoji 🔥
    uint8_t header[4] = {0xF0, 0x9F, 0x92, 0xA5};
    uint8_t received_header[4];

    // Read and validate header with timeout
    if (!readWithTimeout(received_header, sizeof(received_header)))
    {
        Serial.println("NovaNet: Timeout waiting for header");
        return;
    }

    if (!validateHeader(received_header))
    {
        Serial.println("NovaNet: Invalid Header");
        return;
    }

    // Read the CRC of the protobuf with timeout
    uint16_t received_protobuf_crc;
    if (!readWithTimeout((uint8_t *)&received_protobuf_crc, sizeof(received_protobuf_crc)))
    {
        Serial.println("NovaNet: Timeout waiting for CRC");
        return;
    }

    // Read the size of the received protobuf with timeout
    uint16_t received_size;
    if (!readWithTimeout((uint8_t *)&received_size, sizeof(received_size)))
    {
        Serial.println("NovaNet: Timeout waiting for size");
        return;
    }

    // Add size validation
    if (received_size > NOVABUF_MAX || received_size == 0)
    {
        Serial.printf("NovaNet: Invalid message size (%d bytes). Must be between 1 and %d bytes\n", received_size, NOVABUF_MAX);
        return;
    }

    // Read the protobuf data with timeout
    uint8_t received_buffer[NOVABUF_MAX];
    if (!readWithTimeout(received_buffer, received_size))
    {
        Serial.println("NovaNet: Timeout waiting for protobuf data");
        return;
    }

    // Calculate and validate CRC
    uint16_t calculated_protobuf_crc = crc16_ccitt(received_buffer, received_size);
    if (received_protobuf_crc != calculated_protobuf_crc)
    {
        Serial.println("NovaNet: Invalid receive CRC");
        return;
    }

    // Initialize a protobuf input stream
    pb_istream_t pb_istream = pb_istream_from_buffer(received_buffer, received_size);

    // Decode the received protobuf
    messaging_Request received_msg = messaging_Request_init_zero;
    if (!pb_decode(&pb_istream, messaging_Request_fields, &received_msg))
    {
        // Handle the decoding error
        Serial.println("NovaNet: Decode Error");
    }

    if (received_msg.which_request_payload == messaging_Request_dmx_request_tag)
    {
        // Handle the DMX request
        messaging_DmxRequest received_dmx_request = received_msg.request_payload.dmx_request;

        if (received_msg.has_configAmnesia)
        {

            if (received_msg.configAmnesia.fogActivateTime)
            {
                Serial.printf("Received Fog activate time: %d\n", received_msg.configAmnesia.fogActivateTime);
                Serial.println("WARNING: fogActivateTime received but this is not implemented");
            }

            bool timingChanged = false;
            if (received_msg.configAmnesia.fogOutputOnMinTime)
            {
                fogMachine->setFogOutputOnMinTime(received_msg.configAmnesia.fogOutputOnMinTime);
                timingChanged = true;
            }
            if (received_msg.configAmnesia.fogOutputOnMaxTime)
            {
                fogMachine->setFogOutputOnMaxTime(received_msg.configAmnesia.fogOutputOnMaxTime);
                timingChanged = true;
            }
            if (received_msg.configAmnesia.fogOutputOffMinTime)
            {
                fogMachine->setFogOutputOffMinTime(received_msg.configAmnesia.fogOutputOffMinTime);
                timingChanged = true;
            }
            if (received_msg.configAmnesia.fogOutputOffMaxTime)
            {
                fogMachine->setFogOutputOffMaxTime(received_msg.configAmnesia.fogOutputOffMaxTime);
                timingChanged = true;
            }

            if (timingChanged)
            {
                // Calculate average ON and OFF times for duty cycle
                float avgOnTime = (received_msg.configAmnesia.fogOutputOnMinTime + received_msg.configAmnesia.fogOutputOnMaxTime) / 2.0f;
                float avgOffTime = (received_msg.configAmnesia.fogOutputOffMinTime + received_msg.configAmnesia.fogOutputOffMaxTime) / 2.0f;
                float dutyCycle = (avgOnTime / (avgOnTime + avgOffTime)) * 100.0f;

                Serial.printf("Received Fog timings - On: %d-%dms, Off: %d-%dms (%.1f%% duty cycle)\n",
                              received_msg.configAmnesia.fogOutputOnMinTime,
                              received_msg.configAmnesia.fogOutputOnMaxTime,
                              received_msg.configAmnesia.fogOutputOffMinTime,
                              received_msg.configAmnesia.fogOutputOffMaxTime,
                              dutyCycle);
            }

            fogMachine->updateLastAmnesiaMessageTime();
            // Serial.println("Received configAmnesia");

            Serial.printf("Received Fog enabled: %d\n", received_msg.configAmnesia.fogEnabled);

            if (received_msg.configAmnesia.fogEnabled)
            {
                bool currentFogEnabled = fogMachine->getFogEnabled();
                if (!currentFogEnabled)
                {
                    Serial.printf("Received Fog enabled: %d\n", received_msg.configAmnesia.fogEnabled);
                    fogMachine->setFogEnabled(true);
                }
            }
            else
            {
                bool currentFogEnabled = fogMachine->getFogEnabled();
                if (currentFogEnabled)
                {
                    Serial.printf("Received Fog enabled: %d\n", received_msg.configAmnesia.fogEnabled);
                    fogMachine->setFogEnabled(false);
                }
            }
        }

        // Send the DMX values to the DMX output
        dmxNet->receiveDMX512(received_dmx_request.values.bytes);
    }
    else if (received_msg.which_request_payload == messaging_Request_power_request_tag)
    {
        // Handle the power request
        messaging_PowerRequest received_power_request = received_msg.request_payload.power_request;
        Serial.println("Power request: ???");
    }
    else
    {
        Serial.println("NovaNet: Invalid request payload");
    }

    /*
     * Calculate the frequency of received˝messages
     */
    if (elapsedTime >= 10000)
    {
        float frequency = (float)count / ((float)elapsedTime / 1000.0);
        Serial.print("Received Message Frequency: ");
        Serial.print(frequency);
        Serial.println(" Hz");

        lastTime = currentTime;
        count = 0;
    }
    count++;
}

bool NovaNet::validateHeader(const uint8_t *header)
{
    const uint8_t expected_header[4] = {0xF0, 0x9F, 0x92, 0xA5}; // "fire" emoji
    return memcmp(header, expected_header, 4) == 0;
}

// CRC-16-CCITT function
uint16_t NovaNet::crc16_ccitt(const uint8_t *data, uint16_t length)
{
    uint16_t crc = 0xFFFF; // Initialize CRC to 0xFFFF

    // Iterate over the data
    for (uint16_t i = 0; i < length; i++)
    {
        crc ^= data[i] << 8; // XOR the current byte with the CRC

        // Iterate over the bits in the byte
        for (uint16_t j = 0; j < 8; j++)
        {
            // If the MSB of the CRC is 1, XOR with the polynomial
            if (crc & 0x8000)
            {
                crc = (crc << 1) ^ 0x1021; // Polynomial: x^16 + x^12 + x^5 + 1
            }
            else // Otherwise, shift the CRC left by 1 bit
            {
                crc <<= 1;
            }
        }
    }

    return crc; // Return the final CRC value
}
