mc-hamster/nova-core/nova star/src/globals.h

#include "NovaNet.h"
#include "NovaIO.h"
#include "DmxNet.h"
#include "FogMachine.h"
#include "Sensors.h"

extern NovaNet *novaNet;
extern NovaIO *novaIO;
extern DmxNet *dmxNet;
extern FogMachine *fogMachine;
extern Sensors *sensors;
