mc-hamster/nova-core/nova core/src/Ambient.h

#ifndef AMBIENT_H
#define AMBIENT_H

#pragma once

#include <Arduino.h>
#include "messaging.pb.h"
#include "configuration.h"

bool encode_callback(pb_ostream_t *stream, const pb_field_t *field, void *const *arg);

class Ambient
{
private:
    uint32_t lastExecutionTime = 0;
    uint32_t totalFrameTime = 0;
    uint32_t numFrames = 0;

    void runAmnesiaCode(messaging_Request& request, uint8_t starIndex);

public:
    Ambient();

    void loop();

    void sendDmxMessage(uint8_t* dmxValues, size_t dmxValuesSize, bool sendAmnesia, uint8_t starIndex);

    uint32_t getFogOutputOffMinTime(void);
    uint32_t getFogOutputOffMaxTime(void);
    uint32_t getFogOutputOnMinTime(void);
    uint32_t getFogOutputOnMaxTime(void);

    bool setFogOutputOffMinTime(uint32_t time);
    bool setFogOutputOffMaxTime(uint32_t time);
    bool setFogOutputOnMinTime(uint32_t time);
    bool setFogOutputOnMaxTime(uint32_t time);



    // bool encode_callback(pb_ostream_t *stream, const pb_field_t *field, void *const *arg);

    uint16_t crc16_ccitt(const uint8_t *data, uint16_t length);
};

extern Ambient *ambient;

#endif
