mc-hamster/nova-core/nova core/src/Enable.h

#ifndef ENABLE_H
#define ENABLE_H

#pragma once

#include <Arduino.h>
#include "main.h"
#include "utilities/PreferencesManager.h"

extern PreferencesManager manager;

class Enable
{
private:
    bool systemEnable = 1;

    uint8_t disabledBrightness = 0;

    // This defines the speed of the fade
    uint8_t disabledBrightnessFade = 16; // This should be powers of two (1, 2, 4, 8, 16, 32, 64, etc)

public:
    Enable();

    void loop();

    void emergencyStopExit();
    void emergencyStopEnter();

    bool isSystemEnabled();
    bool isDrunktard();
};

extern Enable *enable;

#endif
