mc-hamster/nova-core/nova core/src/fileSystemHelper.cpp

#include <LittleFS.h>
#include "FS.h"

/**
 * Lists the contents of a directory recursively.
 *
 * @param fs The file system to list the directory from.
 * @param dirname The name of the directory to list.
 * @param levels The number of levels of subdirectories to list.
 *
 * Usage example:
 *
 * listDirRecursive(SPIFFS, "/", 2);
 */
void listDir(fs::FS &fs, const char *dirname, uint8_t levels)
{
  Serial.printf("Listing directory: %s\r\n", dirname);

  File root = fs.open(dirname);
  if (!root)
  {
    Serial.println("- failed to open directory");
    return;
  }
  if (!root.isDirectory())
  {
    Serial.println(" - not a directory");
    return;
  }

  File file = root.openNextFile();
  while (file)
  {
    if (file.isDirectory())
    {
      Serial.print("  DIR : ");

#ifdef CONFIG_LITTLEFS_FOR_IDF_3_2
      Serial.println(file.name());
#else
      Serial.print(file.name());
      time_t t = file.getLastWrite();
      struct tm *tmstruct = localtime(&t);
      Serial.printf("  LAST WRITE: %d-%02d-%02d %02d:%02d:%02d\n", (tmstruct->tm_year) + 1900, (tmstruct->tm_mon) + 1, tmstruct->tm_mday, tmstruct->tm_hour, tmstruct->tm_min, tmstruct->tm_sec);
#endif

      if (levels)
      {
        listDir(fs, file.name(), levels - 1);
      }
    }
    else
    {
      Serial.print("  FILE: ");
      Serial.print(file.name());
      Serial.print("  SIZE: ");

#ifdef CONFIG_LITTLEFS_FOR_IDF_3_2
      Serial.println(file.size());
#else
      Serial.print(file.size());
      time_t t = file.getLastWrite();
      struct tm *tmstruct = localtime(&t);
      Serial.printf("  LAST WRITE: %d-%02d-%02d %02d:%02d:%02d\n", (tmstruct->tm_year) + 1900, (tmstruct->tm_mon) + 1, tmstruct->tm_mday, tmstruct->tm_hour, tmstruct->tm_min, tmstruct->tm_sec);
#endif
    }
    file = root.openNextFile();
  }
}
