mc-hamster/nova-core/(commit log)

2022-10-07 Initial checkin
    [core.brd, core.sch, star.brd, star.sch]
2022-10-07 update schematic
    [core.brd, core.sch]
2022-10-11 Core 001 Complete
    [core.brd, core.csv, core.sch, core_top_bom.csv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]
2022-11-27 Nova 3.0 in progress. Needs line drivers.
    [core.brd, core.sch]
2022-12-08 start of adding ULN to the outputs
    [core.brd, core.sch]
2022-12-16 More Progress
    [core.brd, core.sch]
2022-12-18 Schematic Capture is complete
    [core.brd, core.sch]
2022-12-19 Completed v3
    [core.brd, core.sch]
2022-12-23 Nova Core v3 - Sent to JLC PCB
    [core.brd, core_bom.csv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]
2023-01-04 Fix for button status resistors & 12v status dim
    Fix for button status resistors & 12v status dim
    [core.brd, core.sch]
2023-01-04 Updated bulk capacitor spacing
    [core.brd]
2023-01-04 updated version number
    [core.brd]
2023-01-04 updated sample code using adafruit library
2023-01-21 Fixes interrupt on the "H" expander
2023-01-21 Initial work on class for read/write on gpio expander.
    [configuration.h]
2023-01-21 Update boards to remove interrupt for all but expansion H
    Update boards to remove interrupt for all but expansion H
    [core.brd, core.sch]
2023-01-21 Call out individual button interfaces
    [configuration.h]
2023-01-22 Switch to FreeRTOS and using semaphores
2023-01-22 wrapper around writeGPIOAB to make it thread safe
2023-02-01 Update phoenix connectors & add JLC_ROTATION
    [core.brd, core.sch]
2023-02-01 Replaced output resistor with 68 ohm (part c27592)
    [core.brd, core.sch]
2023-02-16 Add datasheet for TVS diode
2023-02-16 Add TVS and change led resistors to 1k
    [core.brd, core.sch]
2023-02-16 misc board updates
    [core.brd, core.sch]
2023-02-17 partially routed
    [core.brd, core.sch]
2023-02-17 manual routing complete
    [core.brd, core.sch]
2023-02-17 Updated silkscreens
    [core.brd, core.sch]
2023-02-18 Updated labels
    [core.brd, core.sch]
2023-02-24 v04 complete
    [core.sch, core_bom.csv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]
2023-03-28 New methods to control button lights and emergenecy stop
2023-04-09 Add labels 5v and 3v3
    [core.brd]
2023-04-09 Start to implement modes
    [configuration.h]
2023-04-09 define output devices, first a star
2023-04-11 Abstract the digitalWrite methods to make them threadsafe
2023-04-11 buttons setup to have click, double and long press
2023-04-12 buttons work to control the poofer
2023-04-21 Fix bug with stop getting in the way of the button lights
    [main.cpp]
2023-04-28 When button is pushed, blink the light associated with the button.
2023-05-04 Fix watchdog timeout on system disable
    [main.cpp]
2023-05-05 Remap outputs for unscruz.
    I need to fix the cable pigtails. FMYL!
    [Star.cpp]
2023-05-06 Reduce button push timeout
2023-05-14 add esp32-s3
    (for future use)
    [core.brd, core.sch]
2023-05-19 Core Manual v1.0.0
    [core_manual.brd, core_manual.sch, core_manual_bom.csv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]
2023-05-30 Update loop delays in button thread
    This will improve UE when system is enabled and give priority to other threads when the system is disabled.
2023-05-30 Fix the nasty bug from unscruz.
    [Star.cpp]
2023-06-30 Messages are now sent over the serial interface!
    [configuration.h]
2023-07-02 stashing the v2 board with the new processor. likely not going to be used.
    [core.brd, core.sch, core_bom.csv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]
2023-07-02 re & de status LEDs added
    [core.brd, core.sch]
2023-07-02 v1.5.0 of pcb
    [core_bom.csv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]
2023-07-02 Update to board 1.5.0
    [core.brd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]
2023-07-08 Web interface controls lighting
    [configuration.h]
2023-07-13 I2C clock to 400k & append mac to wifi AP
2023-07-13 add resetConfigSwitch and resetRebootSwitch
    [Web.cpp]
2023-07-13 Fix i/o mapping & cache de/re values
    [Star.cpp, Star.h]
2023-07-13 frames are being transmitted
2023-07-18 Fixed mapping of light fixgtures to the outputs.
    [Ambient.cpp]
2023-07-20 Better task reporting
    [configuration.h]
2023-07-20 Updated button feedback behavior
    It now reads the boomer status instead of the button status
2023-07-20 Clarified which frame average is reported
2023-07-23 Fix Pre & Post DMX mapping
    [Ambient.cpp]
2023-07-23 Reduce the amount of time used by the average frame calc
2023-07-23 decrease frequency of free stack size reporting
    [configuration.h]
2023-07-23 cleanup print statements in task loops
2023-07-23 Manual Control Web Buttons Done
2023-08-05 add active feedback on button pushes
2023-08-12 Update monitor filters
2023-08-12 Fix bug in init of bug 13->20
    [Star.cpp]
2023-09-03 skip boom on star 6 (zero indexed)
    [Star.cpp]
2025-03-02 combine nova star and nova core
    [.isort.cfg, configuration.h, core.brd, core.sch, core_bom.csv, core_manual.brd, core_manual.sch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]
2025-03-02 Implement white button
2025-03-07 move buttons into modes
2025-03-07 initial integration of simona
    [configuration.h]
2025-03-09 Simona is now fully ported to Nova
    [configuration.h]
2025-03-10 Bump stack allocations
    Need to fix a stack overflow
    [main.cpp]
2025-03-10 Remove task buttons
2025-03-10 fix web server heap crash
    [Web.cpp, Web.h]
2025-03-10 Cleanup from the old button interface
2025-03-10 Cache expansionDigitalRead reads to free up i2c bus
2025-03-10 Add i2c bus utilization
2025-03-11 Fix brightness not loading at startup
    [LightUtils.cpp, main.cpp]
2025-03-13 Update led <-> star <-> dmx map
2025-03-14 led animation porting complete
2025-03-14 button led position map
2025-03-15 reduce button flashing
2025-03-15 better but still broken
    [NovaNow.cpp]
2025-03-16 fixed random number generator
    [NovaNow.cpp]
2025-03-16 comment out the goPoof serial print
2025-03-16 move max rounds to the config file
    [configuration.h]
2025-03-16 add win animation
    [configuration.h]
2025-03-16 set max rounds back to 8
    oops
    [configuration.h]
2025-03-16 fix prefernce name space error
    [Web.cpp]
2025-03-16 Refactoring to make it easier to read
    [configuration.h]
2025-03-16 Revert "Refactoring to make it easier to read"
    This reverts commit 1a2426aa00bba131db1edb5a4b0cce5537a63259.
    [configuration.h]
2025-03-16 reduce the amount of time we poof during the input stage
2025-03-17 Config for disable debug messages in stars.cpp
    [configuration.h]
2025-03-17 fix timing of stars
    [Star.cpp, Tasks.cpp]
2025-03-17 Fix stalled tasks
2025-03-18 Revert "Fix stalled tasks"
    This reverts commit 07517c7216bb89cdf079c6cdaf90f9eb23ba0c11.
    [Tasks.cpp]
2025-03-18 Revert "Create wifi_config.h"
    This reverts commit 89ce5e07fefa8dec5ebfdf949daa17e2fff7a561.
    [wifi_config.h]
2025-03-19 fix stalling condition (non critical)
    [Simona.cpp]
2025-03-19 Fix formatting and add startup music
    [main.cpp]
2025-03-20 Revert "Update Tasks.cpp"
    This reverts commit a6069fd257d096d91a2489869f4efc050a34c41c.
    [Tasks.cpp]
2025-03-20 back out the version of arduinojson
2025-03-21 Fix STA status bug, start to add Fog control
    [Web.cpp]
2025-03-21 fix brightness on startup
    [LightUtils.cpp]
2025-03-27 small adapter for the seeed midi interface
    [midi thing.brd, midi thing.sch]
2025-04-08 Fix xSemaphoreTake bug in NovaIO
    [NovaIO.cpp]
2025-04-10 Switch to case statement
2025-04-10 Bump I2C speed
2025-04-10 i2c reporting
2025-04-23 begin implementation of sensors on nova star
2025-06-09 Fix crash on web update. Caused by update status message
    [Web.cpp]
2025-07-19 Add full sequence display for Simona game
    Introduces methods in Simona to retrieve and format the full LED sequence, exposes it via the web interface, and adds a new label to display the sequence in the UI. Also refines fog control panel labels and adjusts manual switch indexing logic for improved clarity.
2025-07-19 Remove reset configuration switch from Web UI
    Eliminates the resetConfigSwitch control and its associated logic from the Web UI, including the handler in switchExample and its initialization in webSetup. Also disables debug output in Ambient::runAmnesiaCode.
    [Ambient.cpp, Web.cpp]
2025-07-19 Fix label for fog output max time slider
    Corrects the label from 'Min' to 'Max' for the fog output max time slider control in the web setup, ensuring proper UI representation.
    [Web.cpp]
2025-07-20 Increase loop execution interval to 30 seconds
    Changed the interval for executing the average frame time calculation in Ambient::loop from 10 seconds to 30 seconds to reduce frequency of this operation.
2025-07-20 Add debug prints for input collection stage
    Added Serial print statements to log entry into SIMONA_STAGE_INPUT_COLLECTION and button presses, aiding in debugging input handling.
2025-07-20 Limit poof calls during input collection stage
    Introduces a timer and message ID tracking to restrict poof calls to only occur within the first 200ms after a new message is received in the INPUT_COLLECTION stage. This prevents repeated poof events and adds debug logging for poof triggers.
    [NovaNow.cpp]
2025-08-22 Update DMX pin setup and adjust sensor task initialization
    Set DMX hardware pins in DmxNet constructor and ensure DMX packets are sent after writing data. Commented out sensor initialization and related task creation in main.cpp, likely for debugging or to temporarily disable sensor functionality.
2025-08-30 Add core pinning option and adjust poof logic
    Introduces a USE_CORE_PINNING toggle in Tasks.cpp to optionally pin tasks to specific CPU cores for improved stability. Refactors task creation for both pinned and unpinned modes, cleans up debug output, and updates NovaNow.cpp to extend poof timing, increase poof repetitions, and change poof behavior for round transitions. Also increases default pooferDuration in Star.h from 100 to 120.
    [NovaNow.cpp, Star.h, Tasks.cpp]
2025-11-18 Add Mini Nova system and gas diagrams
    Added 'mini nova diagram.graphml' and 'mini nova gas diagram.graphml' to document the Mini Nova system architecture and gas flow. These diagrams provide visual references for hardware and control system design.
